olin-electric-motorsports/OEM_Preferred_Parts/3DModels/3P4T_rotary_switch/3P4T_rotary_switch.fcstd

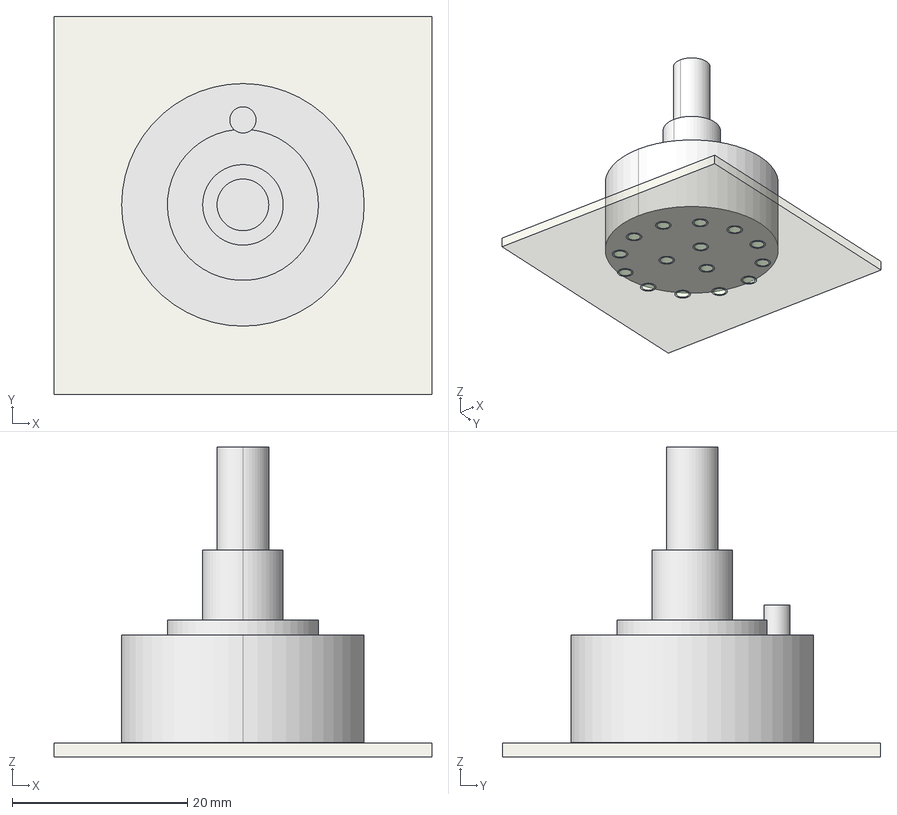
[picture p29: CAD file, 2018-02-22]
3DModels/3P4T_rotary_switch/3P4T_rotary_switch.fcstd
43.2 x 43.2 x 35.4 mm
FrontSilk
TopPads
BotPads
PTHs
Pcb
prog_switch
