olin-electric-motorsports/OEM_Preferred_Parts/3DModels/5029-smdTestPoint/5019--3DModel-STEP-56544.STEP

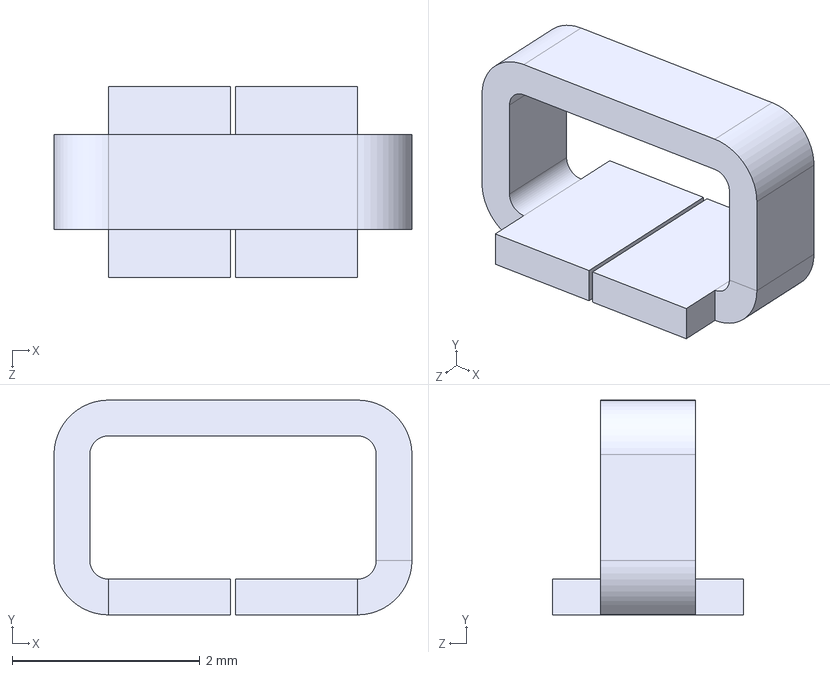
[picture p30: CAD file, 2020-11-04]
3DModels/5029-smdTestPoint/5019--3DModel-STEP-56544.STEP
3.81 x 2.29 x 2.03 mm
