olin-electric-motorsports/OEM_Preferred_Parts/3DModels/Ampseal-14/ampseal-14_OtherSide.stp

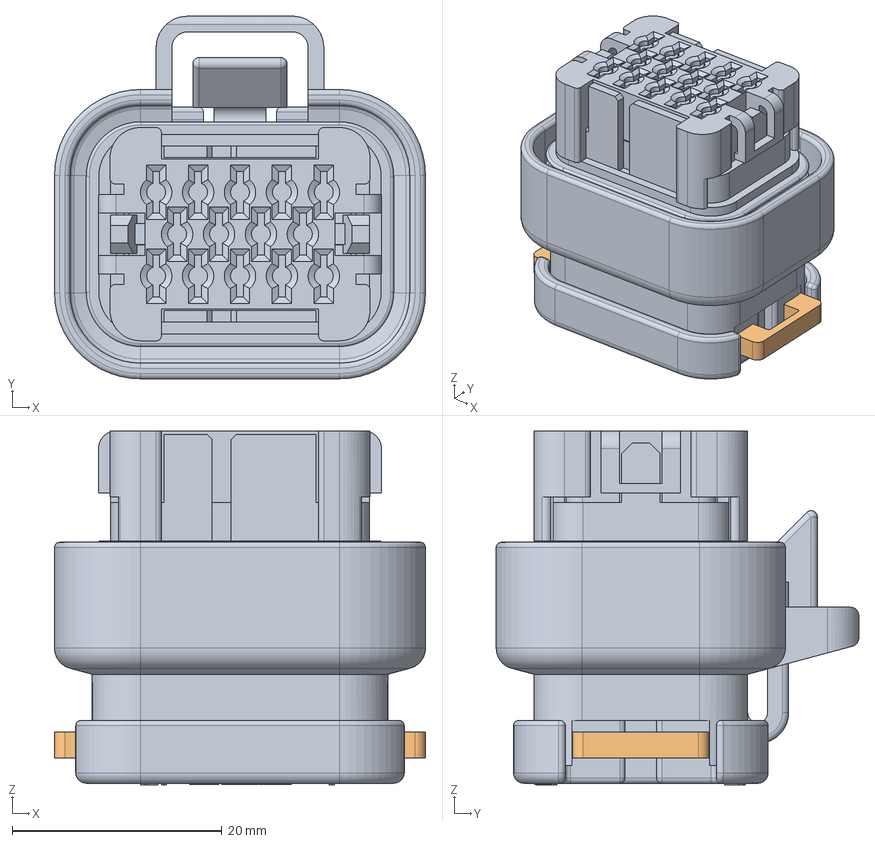
[picture p31: CAD file, 2020-02-05]
3DModels/Ampseal-14/ampseal-14_OtherSide.stp
35.4 x 34.6 x 33.8 mm
