olin-electric-motorsports/OEM_Preferred_Parts/3DModels/Ampseal-23/Ampseal_23.step

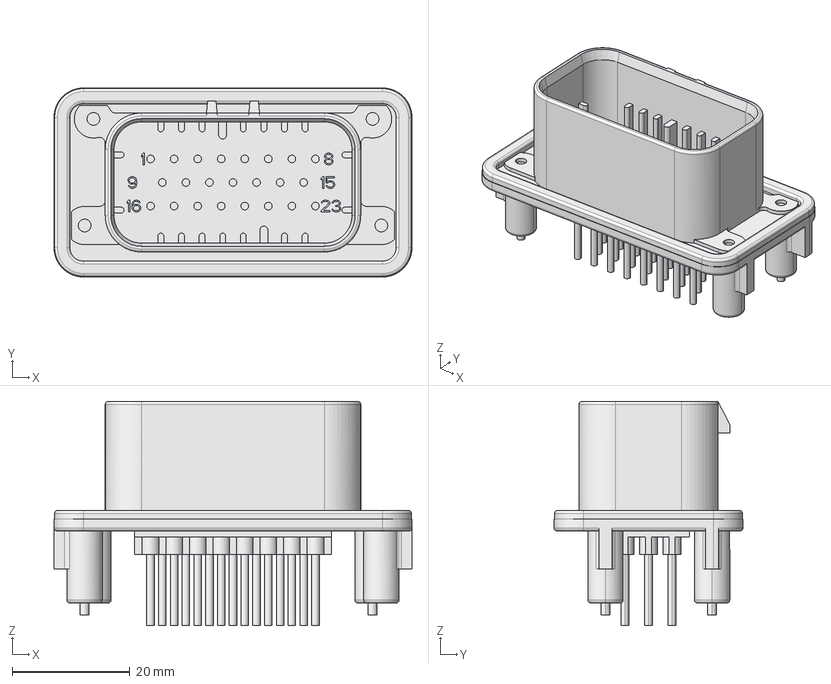
[picture p32: CAD file, 2018-02-08]
3DModels/Ampseal-23/Ampseal_23.step
60.8 x 32.1 x 38.1 mm
