olin-electric-motorsports/OEM_Preferred_Parts/3DModels/Ampseal-35/Ampseal35_OtherSide.stp

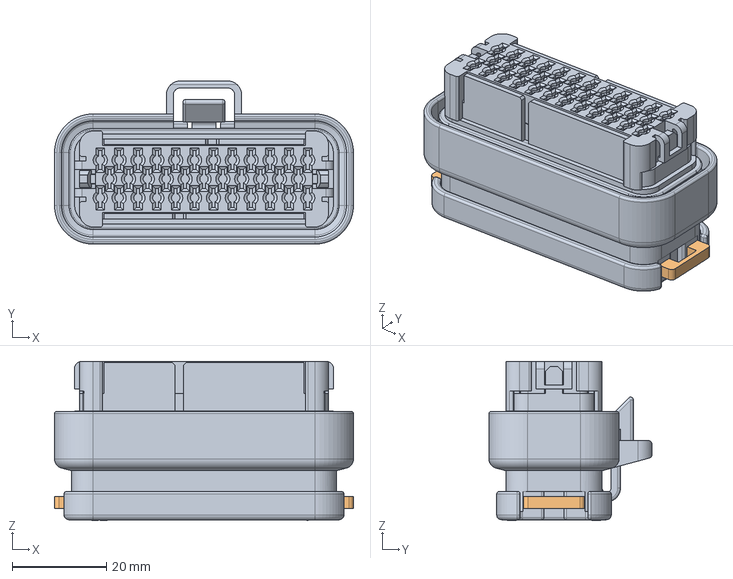
[picture p33: CAD file, 2020-01-15]
3DModels/Ampseal-35/Ampseal35_OtherSide.stp
63.4 x 34.6 x 33.8 mm
