olin-electric-motorsports/OEM_Preferred_Parts/3DModels/AP101_3k_resistor/AP101.fcstd

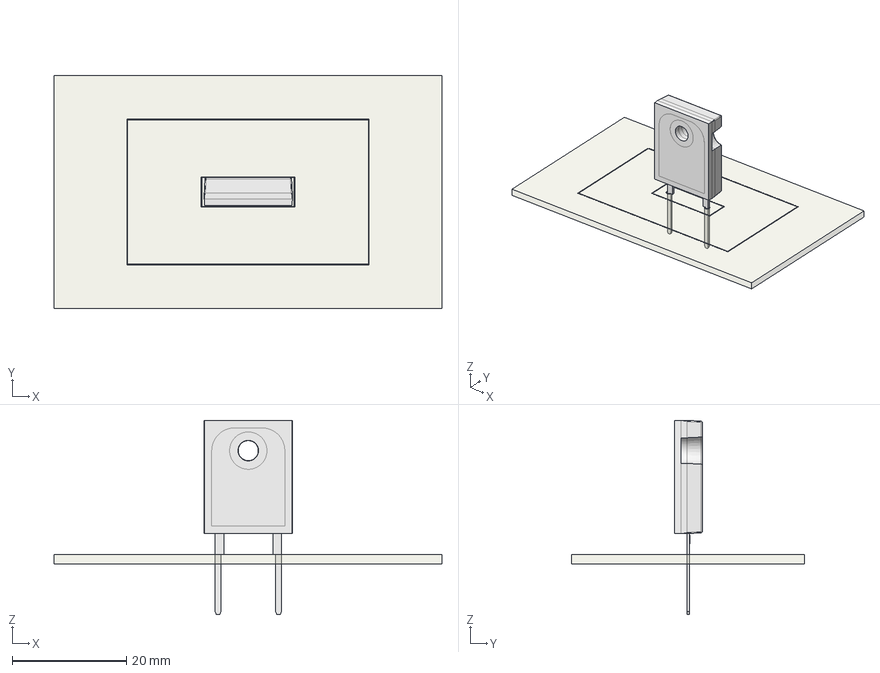
[picture p34: CAD file, 2017-12-29]
3DModels/AP101_3k_resistor/AP101.fcstd
68.0 x 40.8 x 34.0 mm
F_CrtYd
FrontSilk
TopPads
BotPads
PTHs
Pcb
TIP 144_sp
