olin-electric-motorsports/OEM_Preferred_Parts/3DModels/Atmega16m1/32A-M.step

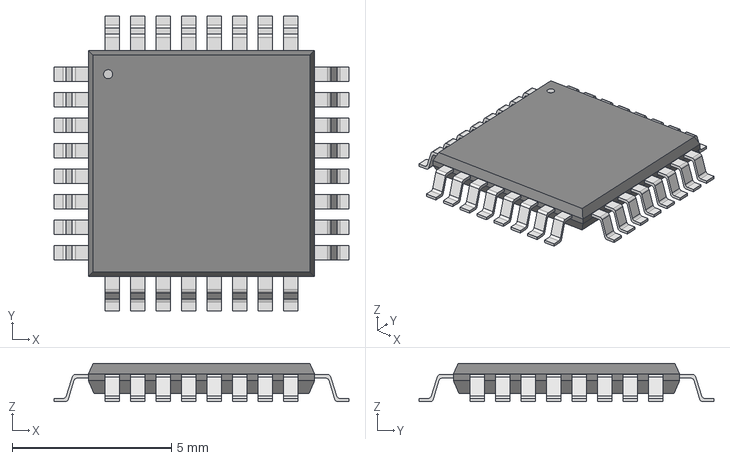
[picture p35: CAD file, 2018-01-06]
3DModels/Atmega16m1/32A-M.step
9.25 x 9.25 x 1.20 mm
