olin-electric-motorsports/OEM_Preferred_Parts/3DModels/BBS-126-G-A/BBS-126-G-A.stp

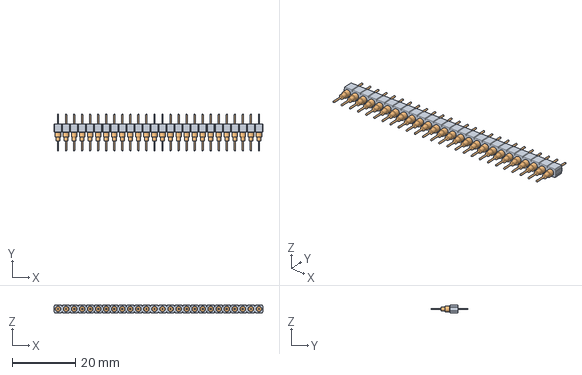
[picture p36: CAD file, 2019-04-12]
3DModels/BBS-126-G-A/BBS-126-G-A.stp
66.0 x 11.7 x 2.44 mm
_BBS-126-G-A_socket
_BBS-126-G-A_pins x 26
