olin-electric-motorsports/OEM_Preferred_Parts/3DModels/C_0805_OEM/C_0805.step

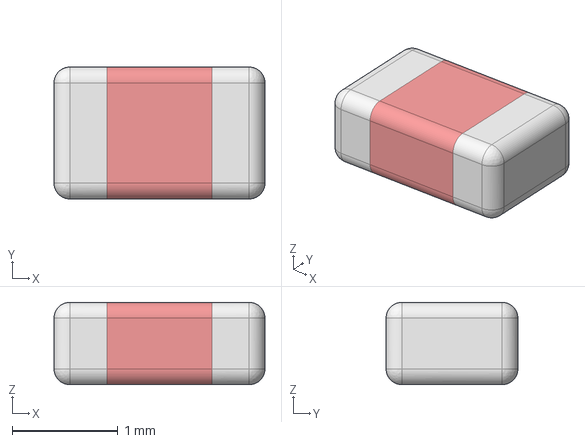
[picture p37: CAD file, 2017-12-01]
3DModels/C_0805_OEM/C_0805.step
2.00 x 1.25 x 0.78 mm
