olin-electric-motorsports/OEM_Preferred_Parts/3DModels/C_1206_OEM/C_1206_OEM.step

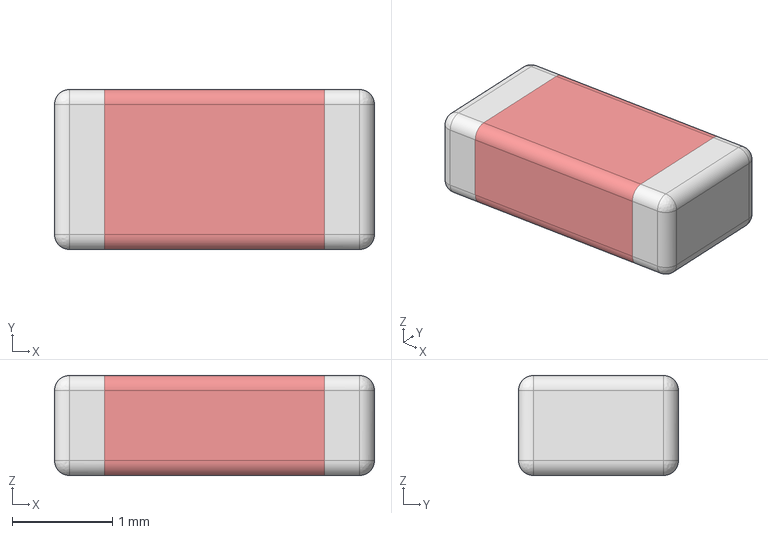
[picture p38: CAD file, 2017-12-29]
3DModels/C_1206_OEM/C_1206_OEM.step
3.20 x 1.60 x 1.00 mm
