olin-electric-motorsports/OEM_Preferred_Parts/3DModels/CAN Transceiver/CAN Transceiver.step

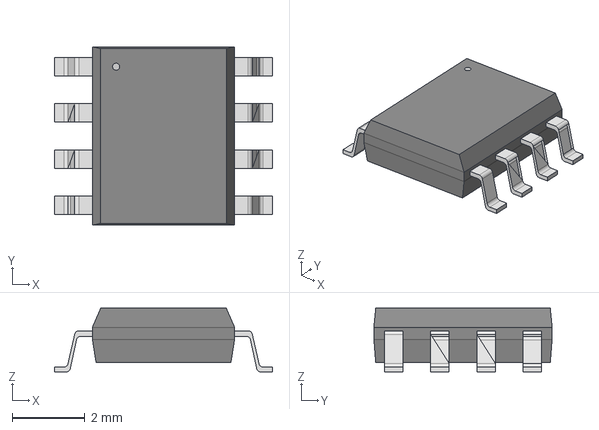
[picture p39: CAD file, 2018-01-06]
3DModels/CAN Transceiver/CAN Transceiver.step
5.99 x 4.90 x 1.75 mm
