olin-electric-motorsports/OEM_Preferred_Parts/3DModels/Crystal/Crystal_SMD_SeikoEpson_TSX3225-4Pin_3.2x2.5mm_HandSoldering.step

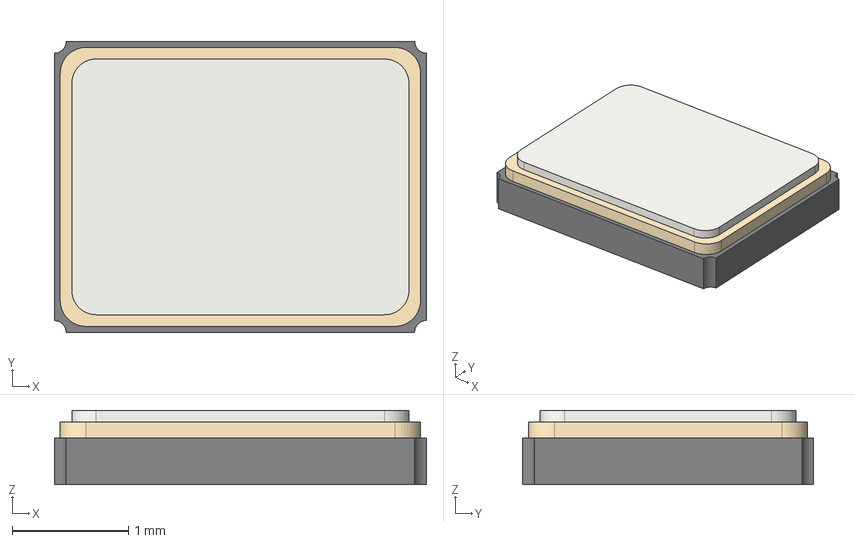
[picture p40: CAD file, 2020-02-01]
3DModels/Crystal/Crystal_SMD_SeikoEpson_TSX3225-4Pin_3.2x2.5mm_HandSoldering.step
3.20 x 2.50 x 0.64 mm
