olin-electric-motorsports/OEM_Preferred_Parts/3DModels/Cynergy_Relay/D_Series_Cynergy_Relays.STEP

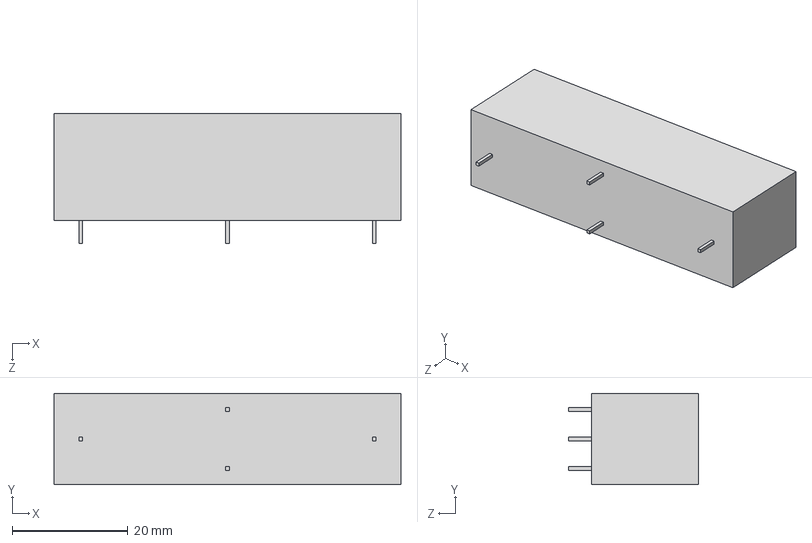
[picture p41: CAD file, 2019-03-15]
3DModels/Cynergy_Relay/D_Series_Cynergy_Relays.STEP
60.0 x 15.8 x 22.5 mm
