olin-electric-motorsports/OEM_Preferred_Parts/3DModels/D_Schottky_SOD123/DO-215AD002_sp.step

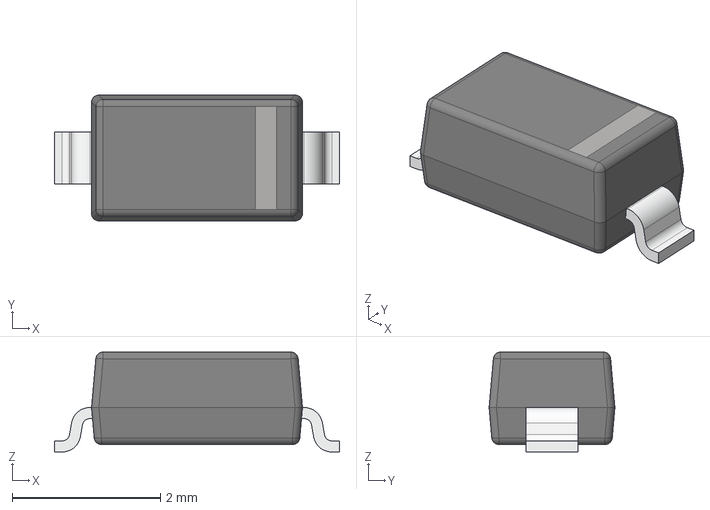
[picture p42: CAD file, 2017-12-29]
3DModels/D_Schottky_SOD123/DO-215AD002_sp.step
3.85 x 1.70 x 1.35 mm
