olin-electric-motorsports/OEM_Preferred_Parts/3DModels/DO_214AA_OEM/DO_214AA.step

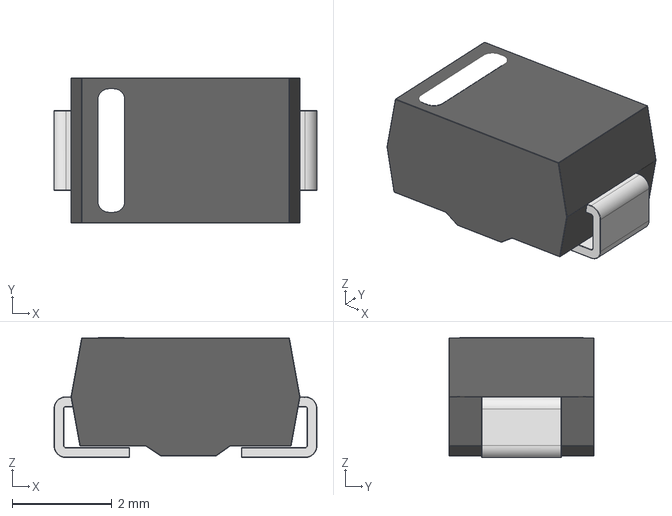
[picture p43: CAD file, 2017-12-01]
3DModels/DO_214AA_OEM/DO_214AA.step
5.28 x 2.92 x 2.41 mm
