olin-electric-motorsports/OEM_Preferred_Parts/3DModels/DTO25/DTO025.step

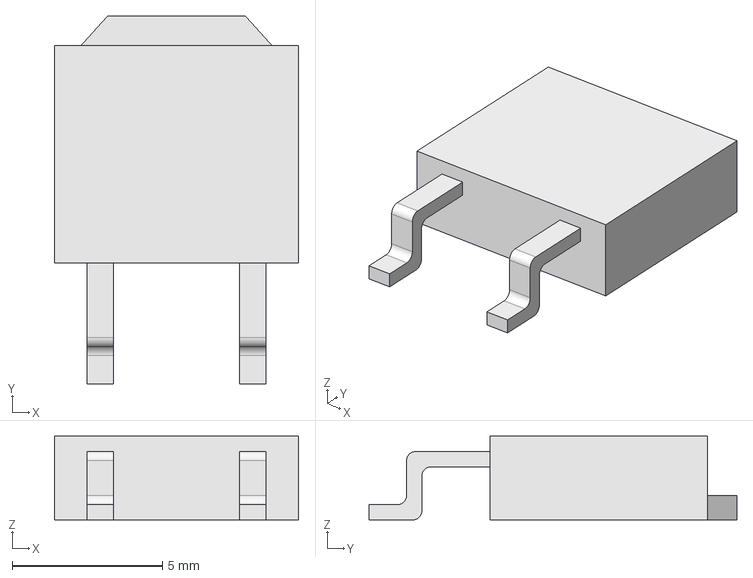
[picture p44: CAD file, 2018-01-06]
3DModels/DTO25/DTO025.step
8.13 x 12.2 x 2.79 mm
