olin-electric-motorsports/OEM_Preferred_Parts/3DModels/Fuse_1210_OEM/Fuse1210.step

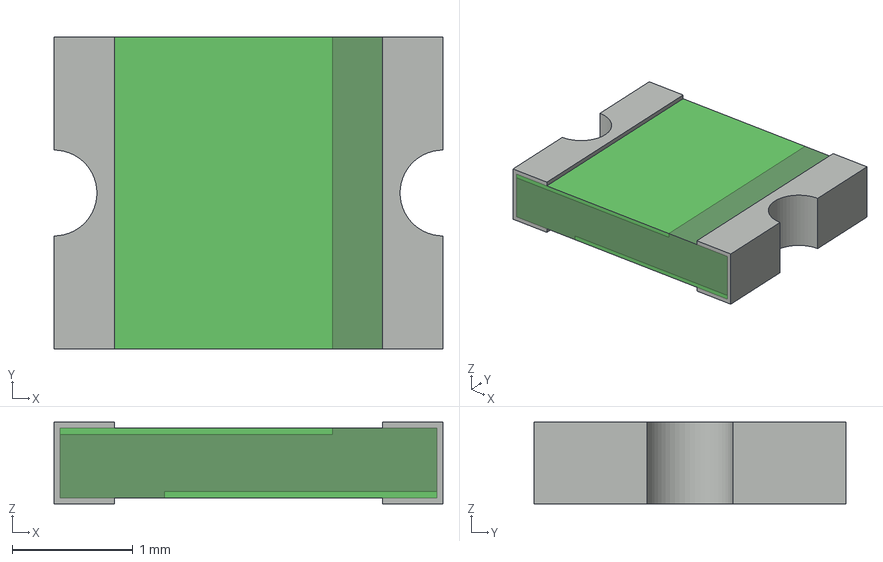
[picture p45: CAD file, 2017-12-01]
3DModels/Fuse_1210_OEM/Fuse1210.step
3.21 x 2.58 x 0.675 mm
