olin-electric-motorsports/OEM_Preferred_Parts/3DModels/Fuse_807/Fuse_807.fcstd

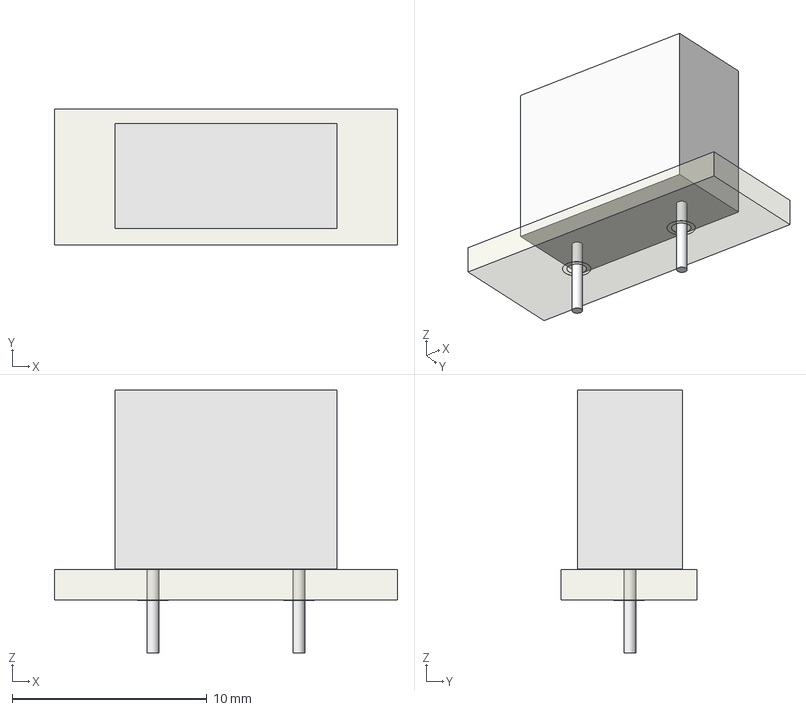
[picture p46: CAD file, 2017-12-29]
3DModels/Fuse_807/Fuse_807.fcstd
17.6 x 6.98 x 13.5 mm
F_CrtYd
FrontSilk
TopPads
BotPads
PTHs
Pcb
