olin-electric-motorsports/OEM_Preferred_Parts/3DModels/fuse_block/fuse_block.step

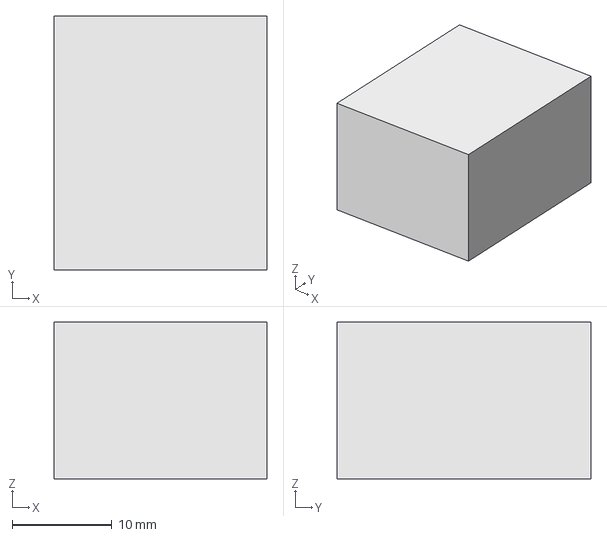
[picture p47: CAD file, 2018-02-22]
3DModels/fuse_block/fuse_block.step
21.3 x 25.4 x 15.7 mm
