olin-electric-motorsports/OEM_Preferred_Parts/3DModels/fuse_block_3557_2/Fuse_3557-2.step

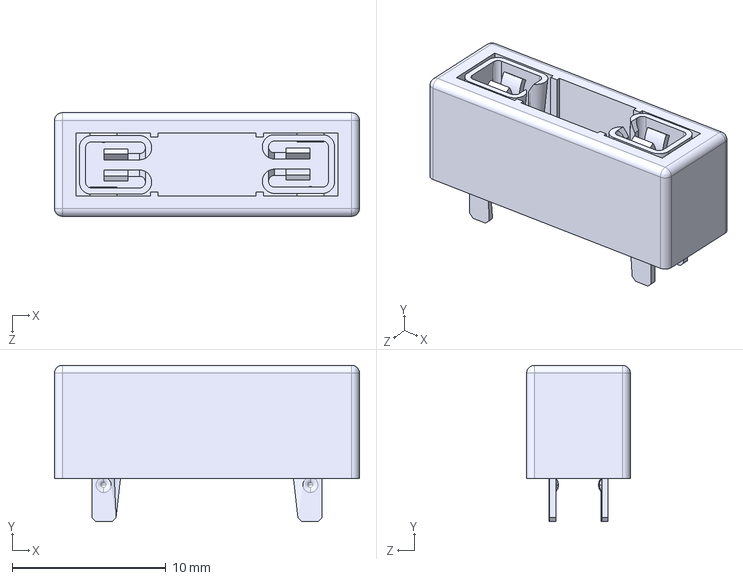
[picture p48: CAD file, 2019-03-01]
3DModels/fuse_block_3557_2/Fuse_3557-2.step
19.8 x 10.2 x 6.73 mm
