olin-electric-motorsports/OEM_Preferred_Parts/3DModels/G5Q_OEM/G5Q.step

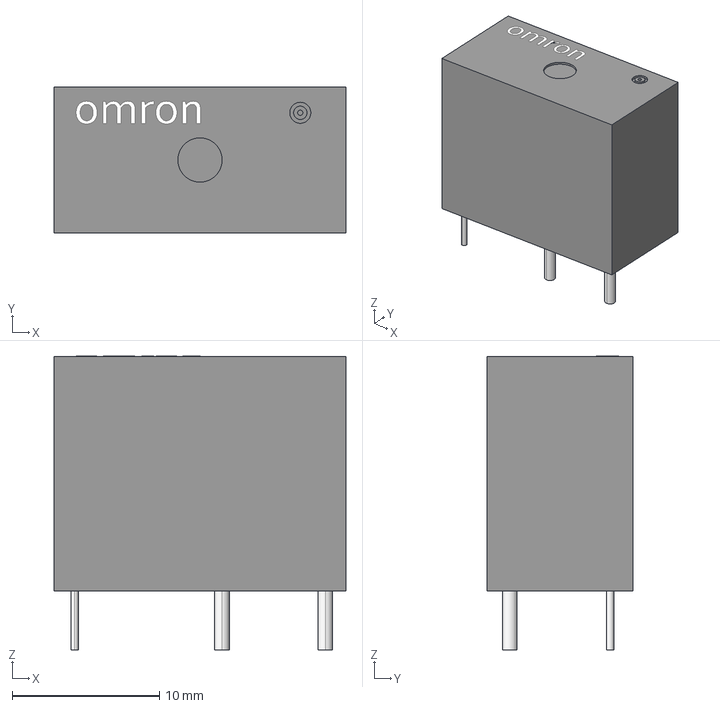
[picture p49: CAD file, 2017-12-01]
3DModels/G5Q_OEM/G5Q.step
19.8 x 9.90 x 19.9 mm
