olin-electric-motorsports/OEM_Preferred_Parts/3DModels/Header_Pin_2x3/Header_Pin_2x3.fcstd

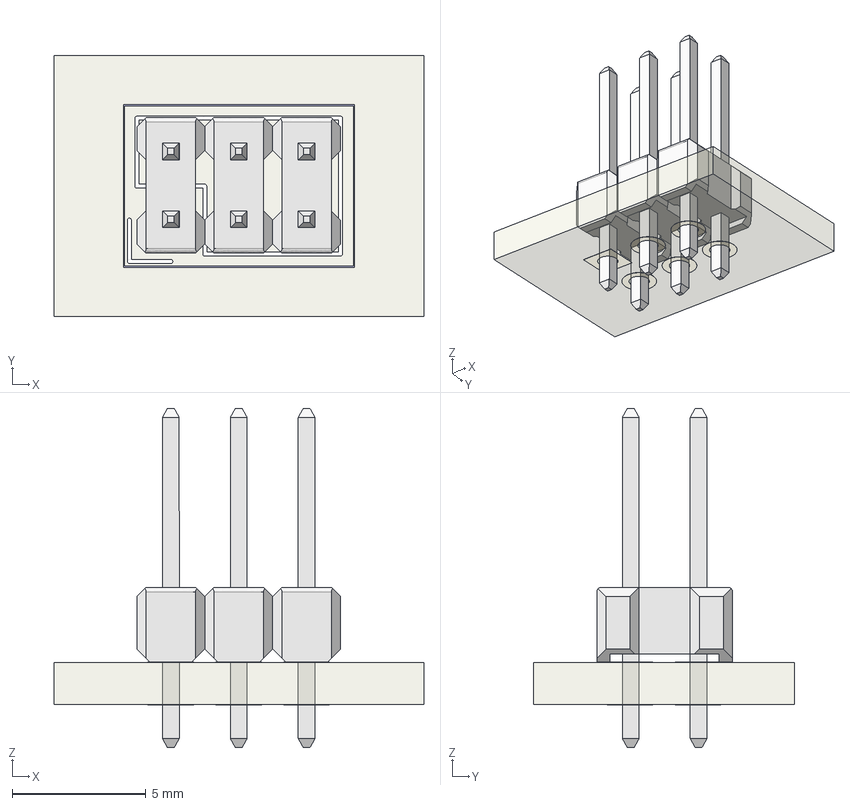
[picture p50: CAD file, 2018-01-06]
3DModels/Header_Pin_2x3/Header_Pin_2x3.fcstd
13.8 x 9.76 x 12.7 mm
FCrtYd
FrontSilk
TopPads
BotPads
PTHs
Pcb
Header_Straight_2x3
