olin-electric-motorsports/OEM_Preferred_Parts/3DModels/LED_0805/LED_0805.fcstd

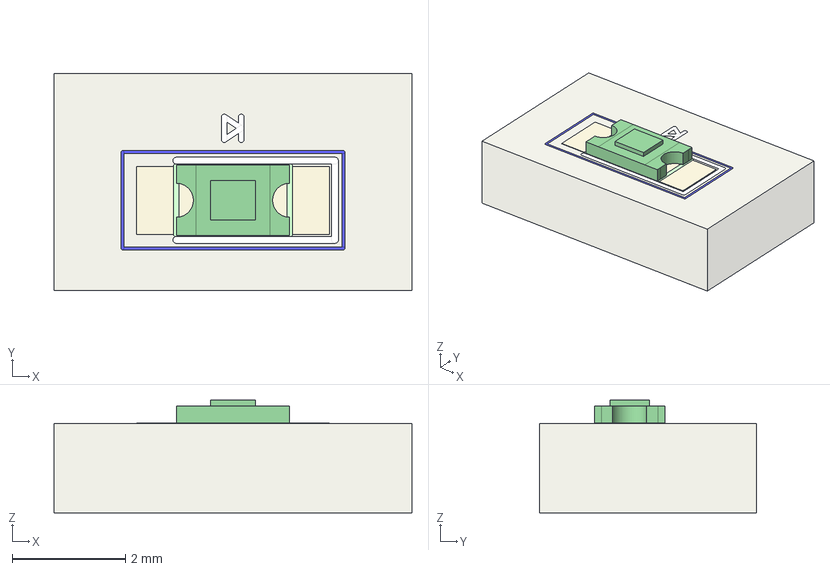
[picture p51: CAD file, 2017-12-01]
3DModels/LED_0805/LED_0805.fcstd
6.32 x 3.83 x 1.99 mm
FFab
FrontSilk
TopPads
Pcb
FCrtYd
LED 0805 Base GREEN001_sp
