olin-electric-motorsports/OEM_Preferred_Parts/3DModels/LTC1380/LTC1380.STEP

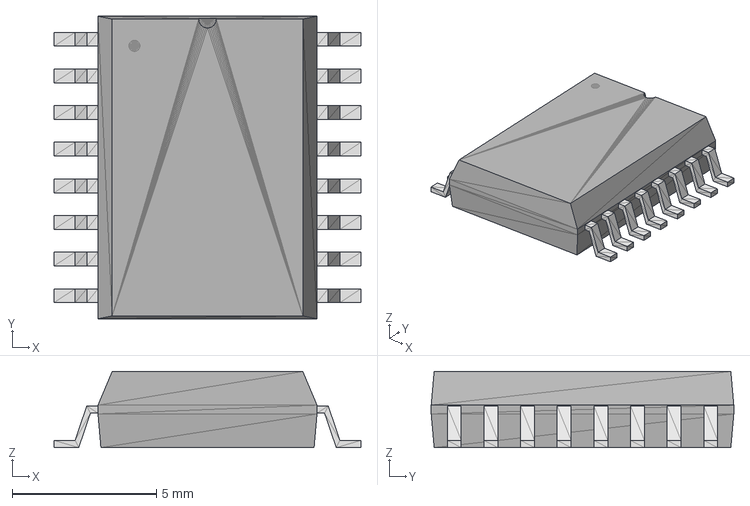
[picture p52: CAD file, 2019-01-19]
3DModels/LTC1380/LTC1380.STEP
10.6 x 10.5 x 2.64 mm
