olin-electric-motorsports/OEM_Preferred_Parts/3DModels/LTC6804/LTC6804-G.step

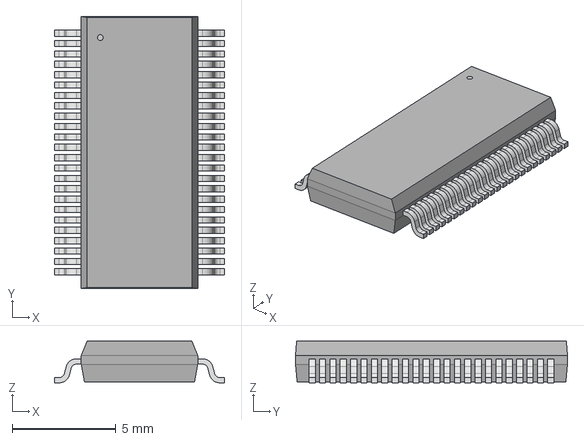
[picture p53: CAD file, 2019-11-15]
3DModels/LTC6804/LTC6804-G.step
8.20 x 13.1 x 2.01 mm
