olin-electric-motorsports/OEM_Preferred_Parts/3DModels/LTC6811-1/LTC6811-1.stp

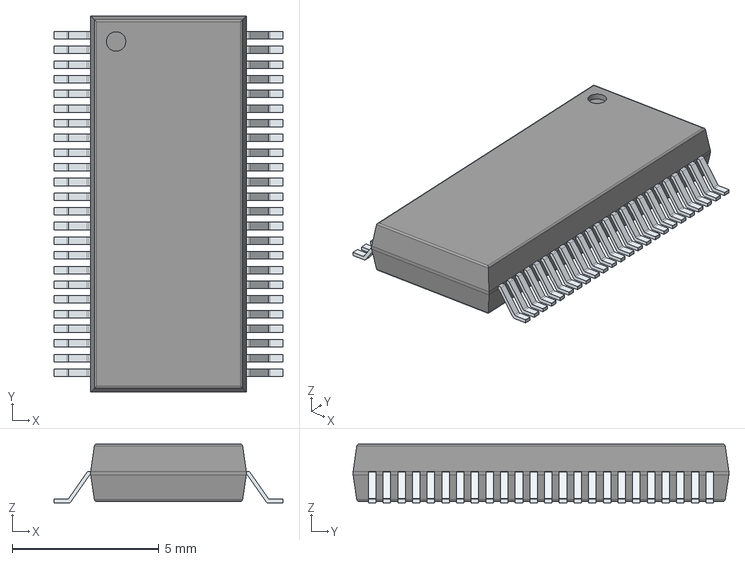
[picture p54: CAD file, 2019-01-19]
3DModels/LTC6811-1/LTC6811-1.stp
7.80 x 12.8 x 2.00 mm
PinsArrayLR
