olin-electric-motorsports/OEM_Preferred_Parts/3DModels/MicroFit-10-RA/MicroFit-10-RA.stp

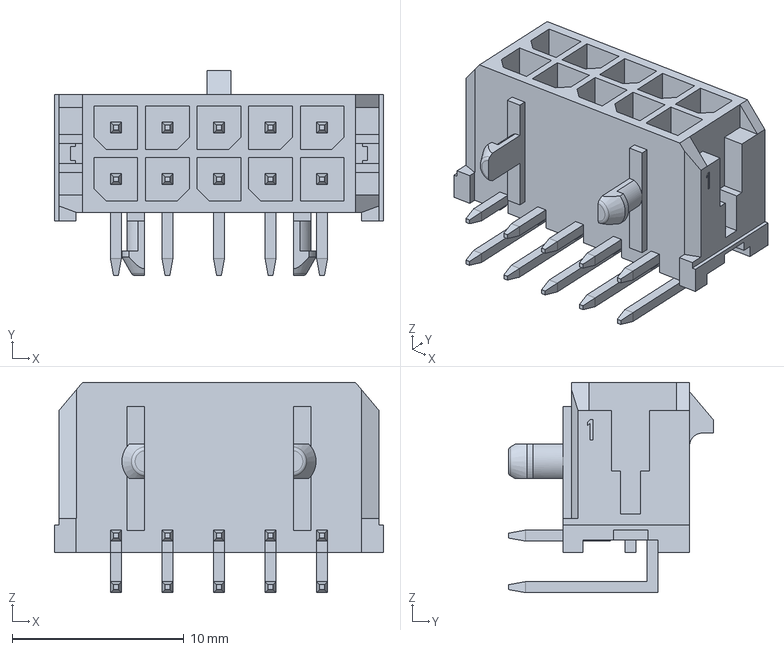
[picture p55: CAD file, 2019-03-15]
3DModels/MicroFit-10-RA/MicroFit-10-RA.stp
19.1 x 11.9 x 12.2 mm
