olin-electric-motorsports/OEM_Preferred_Parts/3DModels/Microfit-2-VT/Microfit_2_VT.stp

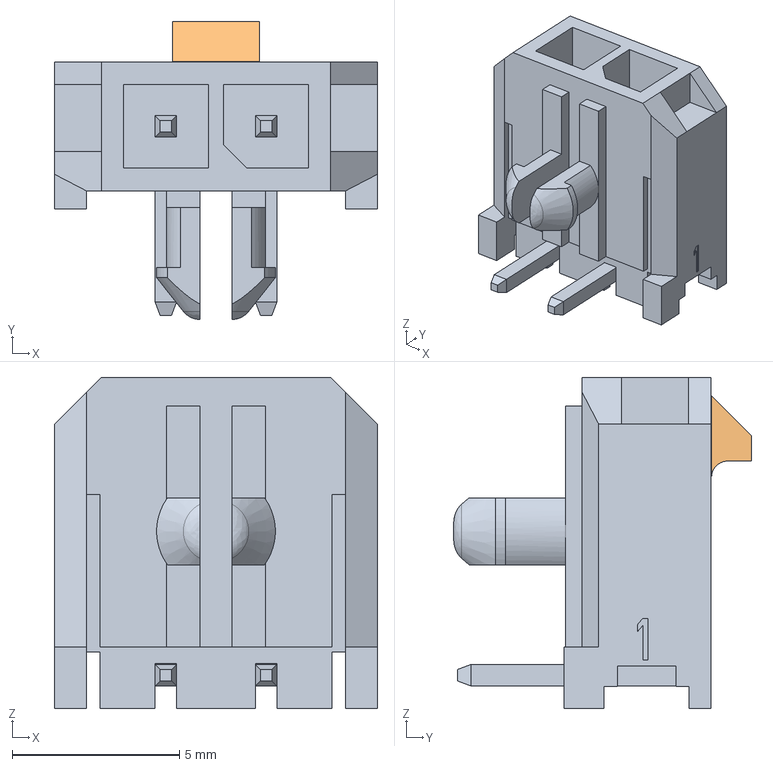
[picture p56: CAD file, 2019-04-12]
3DModels/Microfit-2-VT/Microfit_2_VT.stp
9.65 x 8.91 x 9.90 mm
