olin-electric-motorsports/OEM_Preferred_Parts/3DModels/MicroFit-6-RA/MF_RA_06.stp

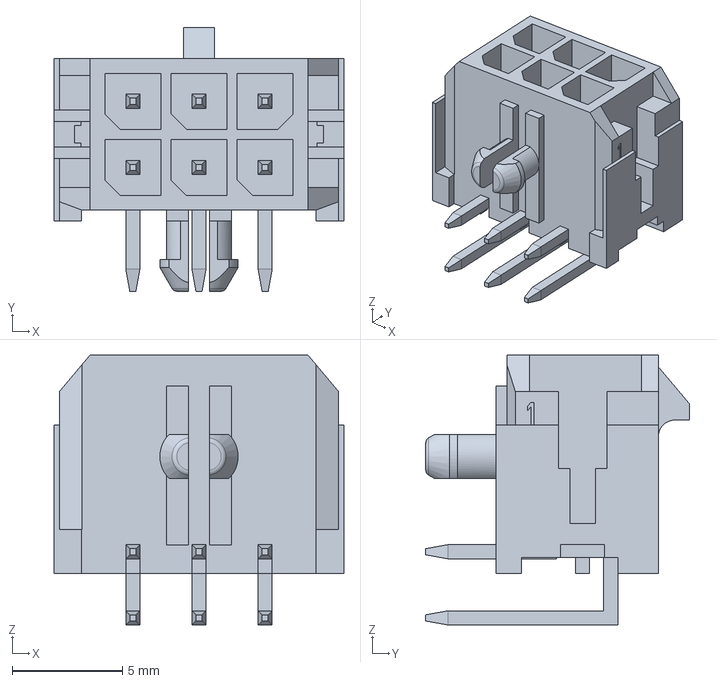
[picture p57: CAD file, 2019-03-15]
3DModels/MicroFit-6-RA/MF_RA_06.stp
13.2 x 11.9 x 12.2 mm
