olin-electric-motorsports/OEM_Preferred_Parts/3DModels/MicroFit-8-RA/MF-08-RA.stp

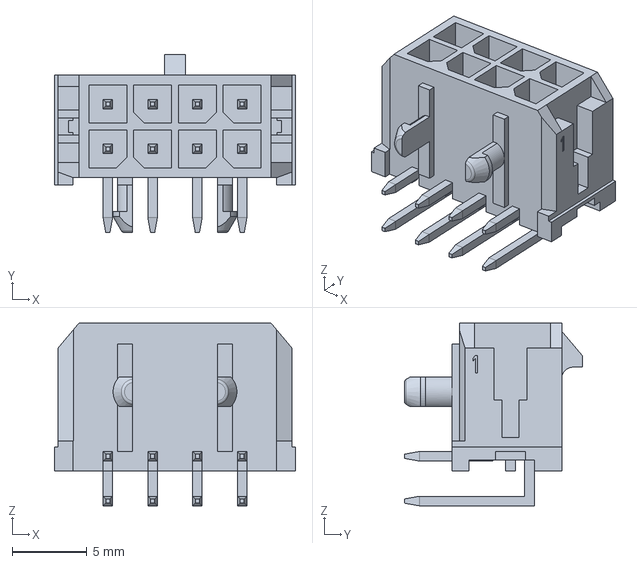
[picture p58: CAD file, 2019-03-15]
3DModels/MicroFit-8-RA/MF-08-RA.stp
16.1 x 11.9 x 12.2 mm
