olin-electric-motorsports/OEM_Preferred_Parts/3DModels/Microfit3_Header_02x06_Angled_OEM/Microfit3_Header_02x06_Angled_OEM.step

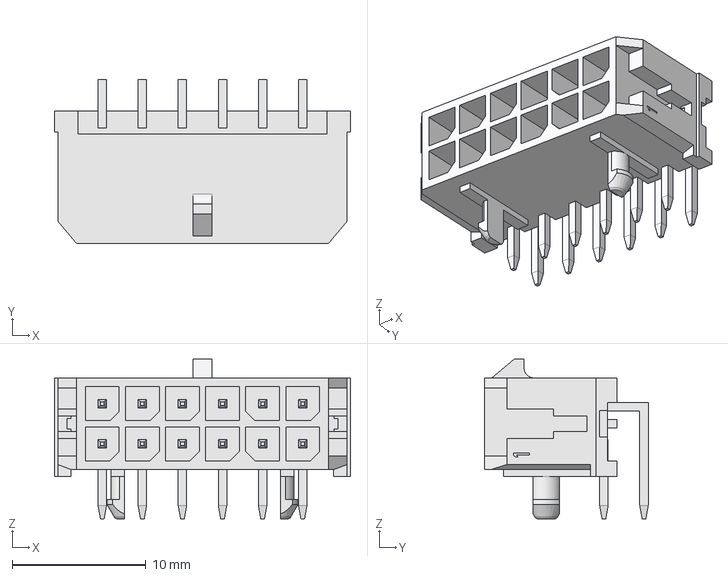
[picture p59: CAD file, 2018-01-06]
3DModels/Microfit3_Header_02x06_Angled_OEM/Microfit3_Header_02x06_Angled_OEM.step
22.1 x 12.2 x 11.9 mm
