olin-electric-motorsports/OEM_Preferred_Parts/3DModels/Microfit_RA_SMD/Microfit_RA_SMD.stp

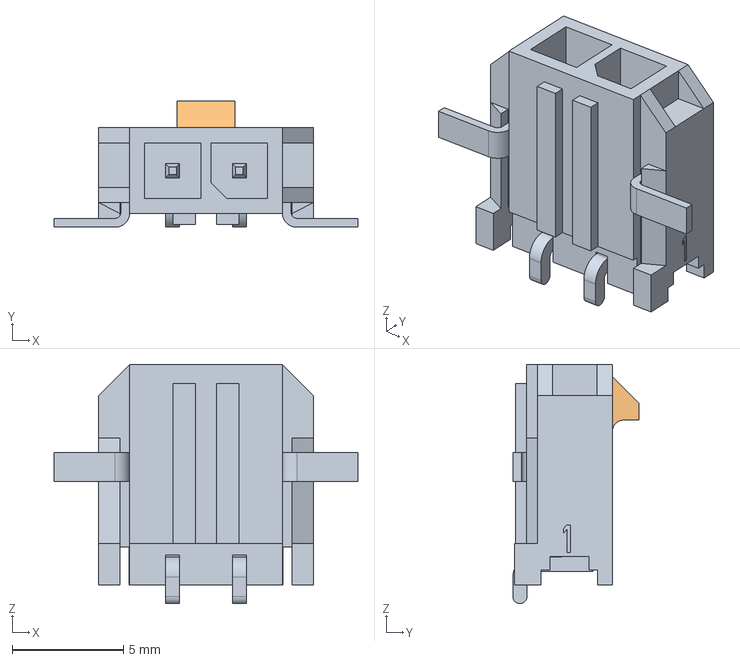
[picture p60: CAD file, 2019-11-15]
3DModels/Microfit_RA_SMD/Microfit_RA_SMD.stp
13.7 x 5.67 x 10.7 mm
