olin-electric-motorsports/OEM_Preferred_Parts/3DModels/MicroFit_V_2/MicroFit_V_2.stp

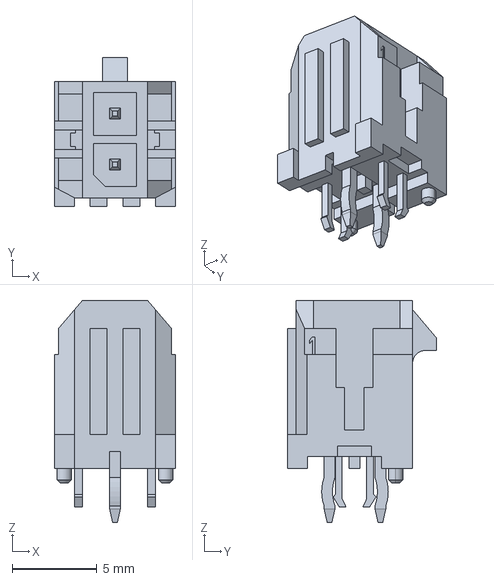
[picture p61: CAD file, 2019-04-12]
3DModels/MicroFit_V_2/MicroFit_V_2.stp
7.15 x 8.77 x 13.1 mm
