olin-electric-motorsports/OEM_Preferred_Parts/3DModels/MicroFit_VT_4/MicroFit_VT_4.stp

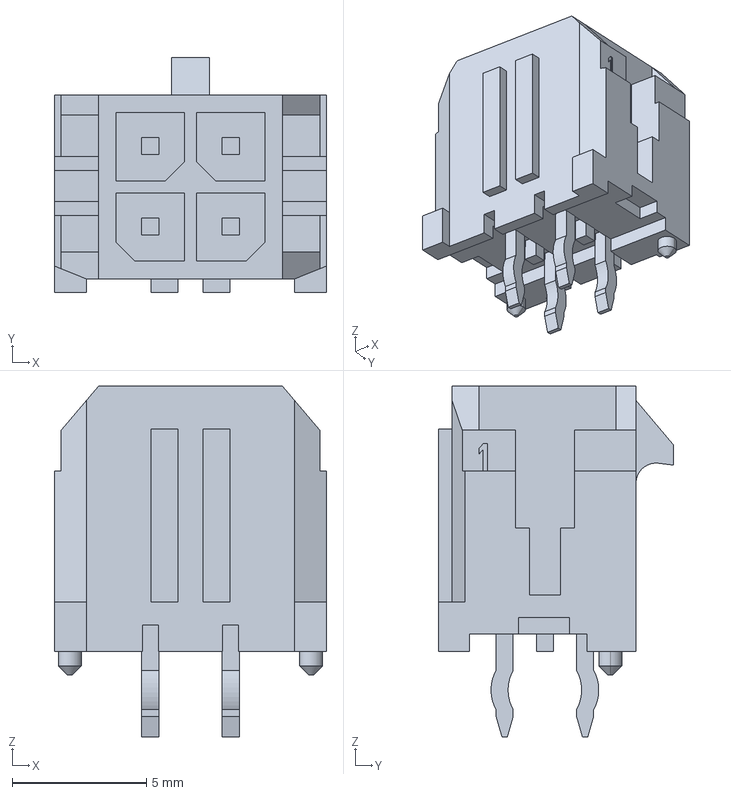
[picture p62: CAD file, 2020-01-15]
3DModels/MicroFit_VT_4/MicroFit_VT_4.stp
10.2 x 8.77 x 13.1 mm
