olin-electric-motorsports/OEM_Preferred_Parts/3DModels/MicroFit_VT_6/MicroFit_VT_6.stp

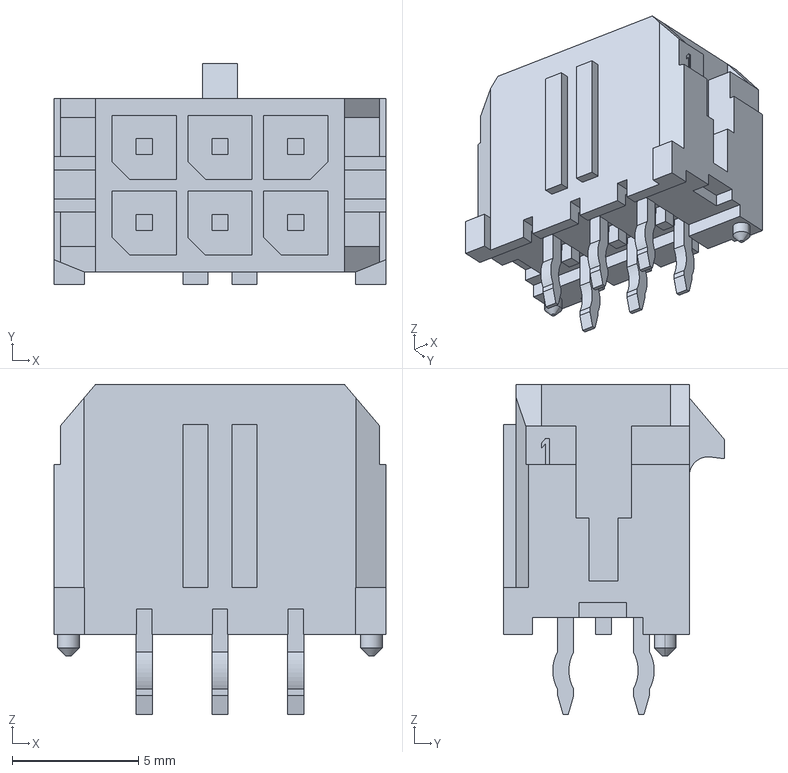
[picture p63: CAD file, 2020-01-15]
3DModels/MicroFit_VT_6/MicroFit_VT_6.stp
13.2 x 8.77 x 13.1 mm
