olin-electric-motorsports/OEM_Preferred_Parts/3DModels/micromatch_female_ra_12/C-1-215464-2.step

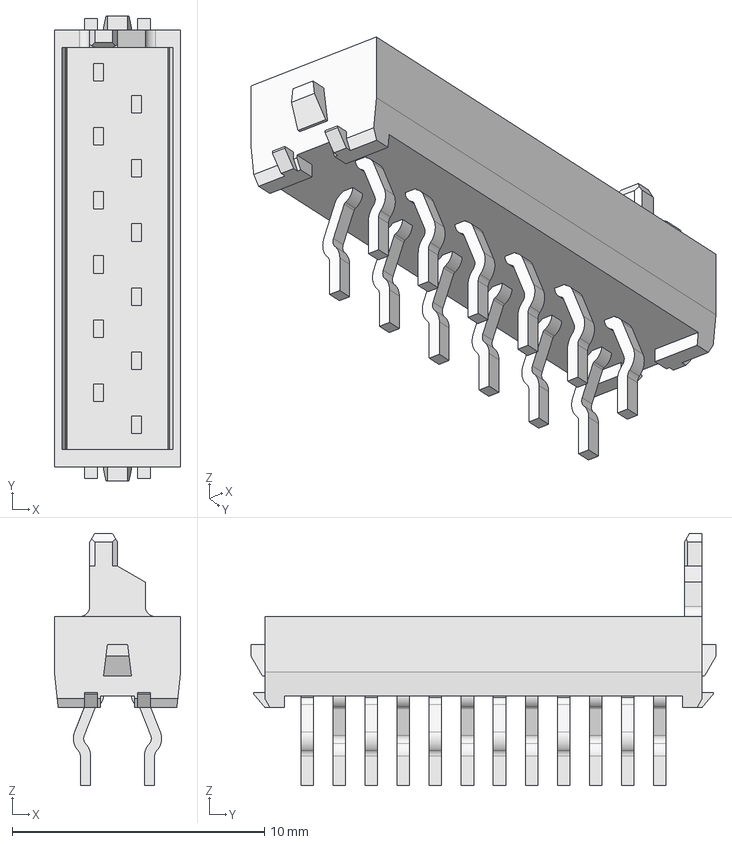
[picture p64: CAD file, 2018-02-22]
3DModels/micromatch_female_ra_12/C-1-215464-2.step
5.00 x 18.4 x 10.0 mm
