olin-electric-motorsports/OEM_Preferred_Parts/3DModels/Micromatch_Female_RA_16/c-8-100400-6-j-3d.stp

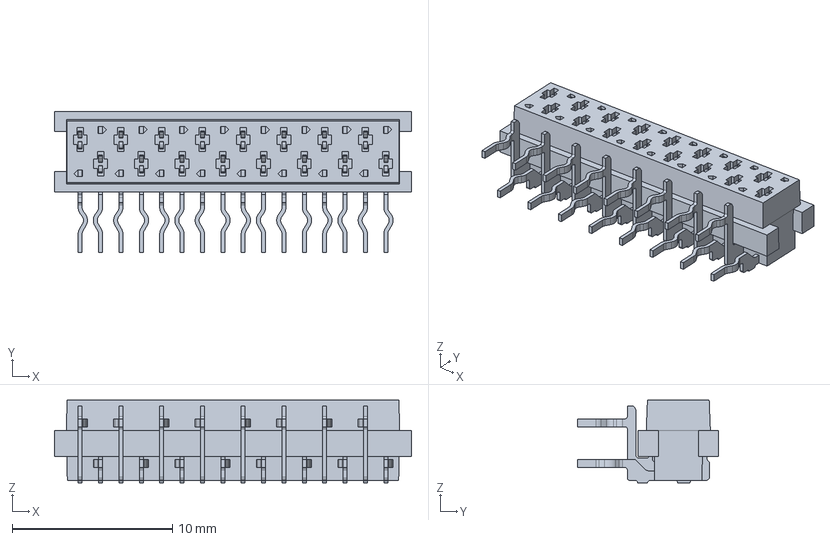
[picture p65: CAD file, 2018-01-06]
3DModels/Micromatch_Female_RA_16/c-8-100400-6-j-3d.stp
22.2 x 8.78 x 5.15 mm
