olin-electric-motorsports/OEM_Preferred_Parts/3DModels/micromatch_female_ra_18/micromatch_female_ra_18.fcstd

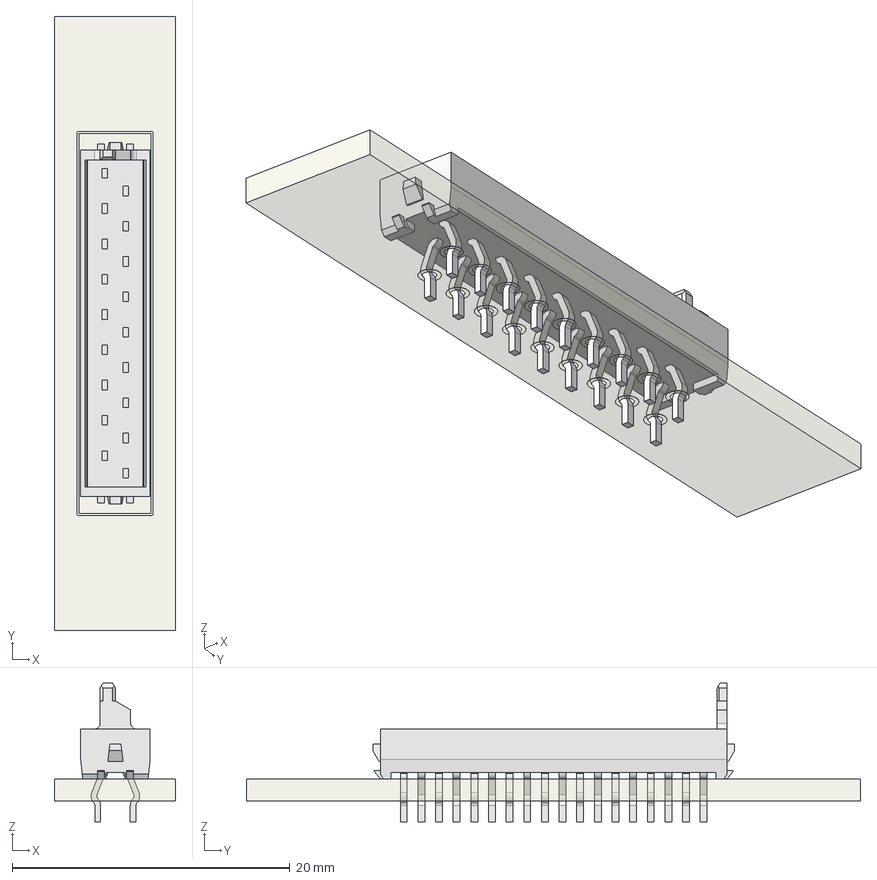
[picture p66: CAD file, 2018-02-22]
3DModels/micromatch_female_ra_18/micromatch_female_ra_18.fcstd
8.72 x 44.2 x 10.0 mm
FrontSilk
TopPads
BotPads
PTHs
Pcb
C-1-215464-8
