olin-electric-motorsports/OEM_Preferred_Parts/3DModels/micromatch_female_ra_20/C-2-215464-0.step

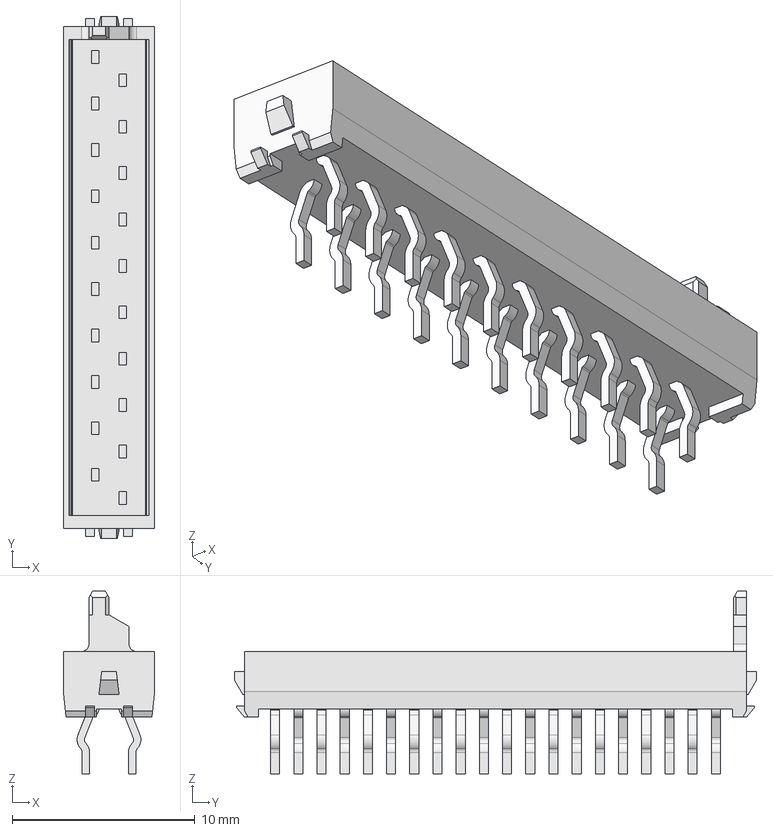
[picture p67: CAD file, 2018-02-22]
3DModels/micromatch_female_ra_20/C-2-215464-0.step
5.00 x 28.6 x 10.0 mm
