olin-electric-motorsports/OEM_Preferred_Parts/3DModels/micromatch_female_ra_6/C-215464-6.step

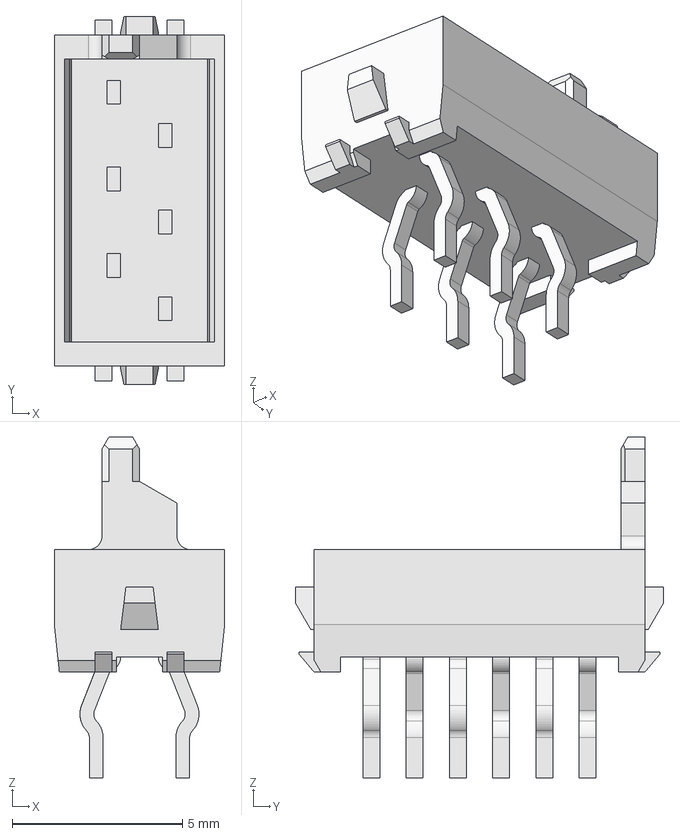
[picture p68: CAD file, 2018-02-22]
3DModels/micromatch_female_ra_6/C-215464-6.step
5.00 x 10.8 x 10.0 mm
