olin-electric-motorsports/OEM_Preferred_Parts/3DModels/Micromatch_Female_RA_8/micromatch_female_ra_8.step

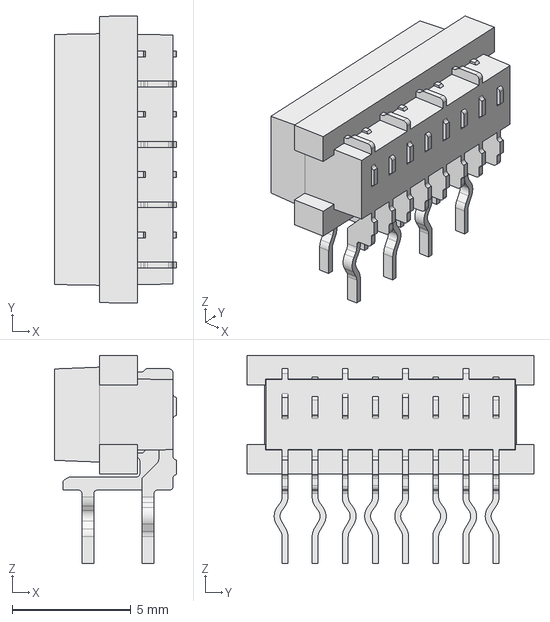
[picture p69: CAD file, 2017-12-04]
3DModels/Micromatch_Female_RA_8/micromatch_female_ra_8.step
5.15 x 12.1 x 8.78 mm
