olin-electric-motorsports/OEM_Preferred_Parts/3DModels/micromatch_female_vert_16/c-1-338068-6-f-3d.stp

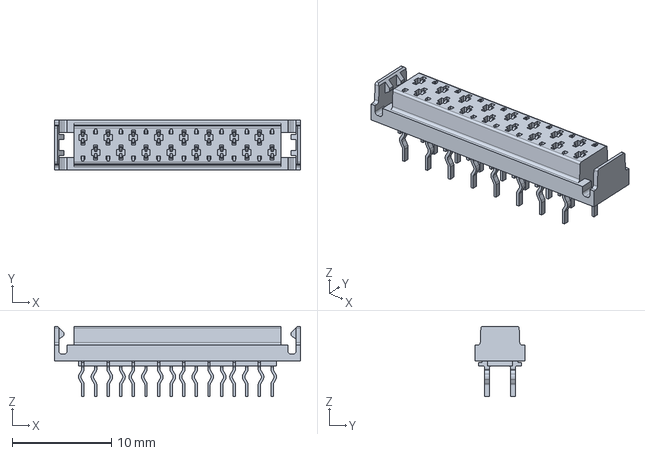
[picture p70: CAD file, 2019-03-18]
3DModels/micromatch_female_vert_16/c-1-338068-6-f-3d.stp
24.8 x 5.00 x 7.10 mm
