olin-electric-motorsports/OEM_Preferred_Parts/3DModels/MicroMatch_Female_VT_6/MM_F_VT_6.stp

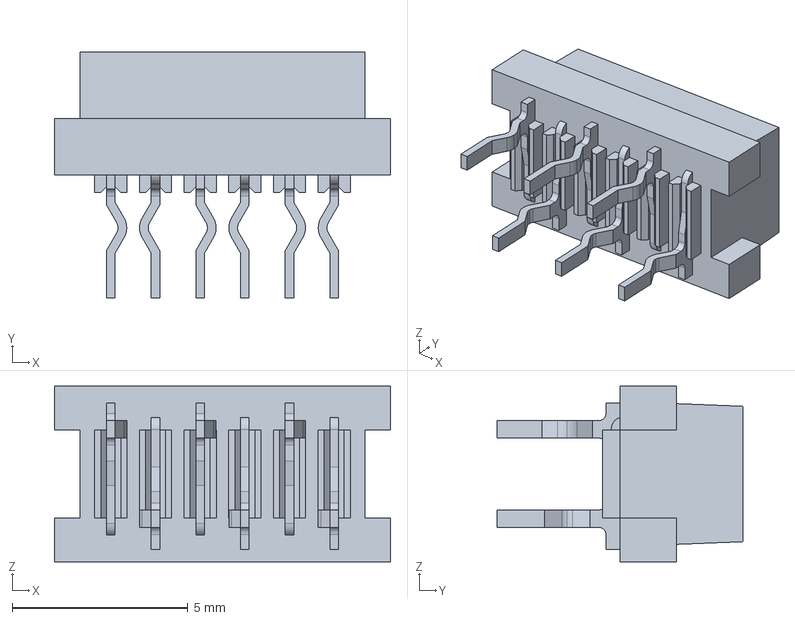
[picture p71: CAD file, 2019-03-01]
3DModels/MicroMatch_Female_VT_6/MM_F_VT_6.stp
9.55 x 7.00 x 5.00 mm
