olin-electric-motorsports/OEM_Preferred_Parts/3DModels/micromatch_vert10/micromatch_vert10.fcstd

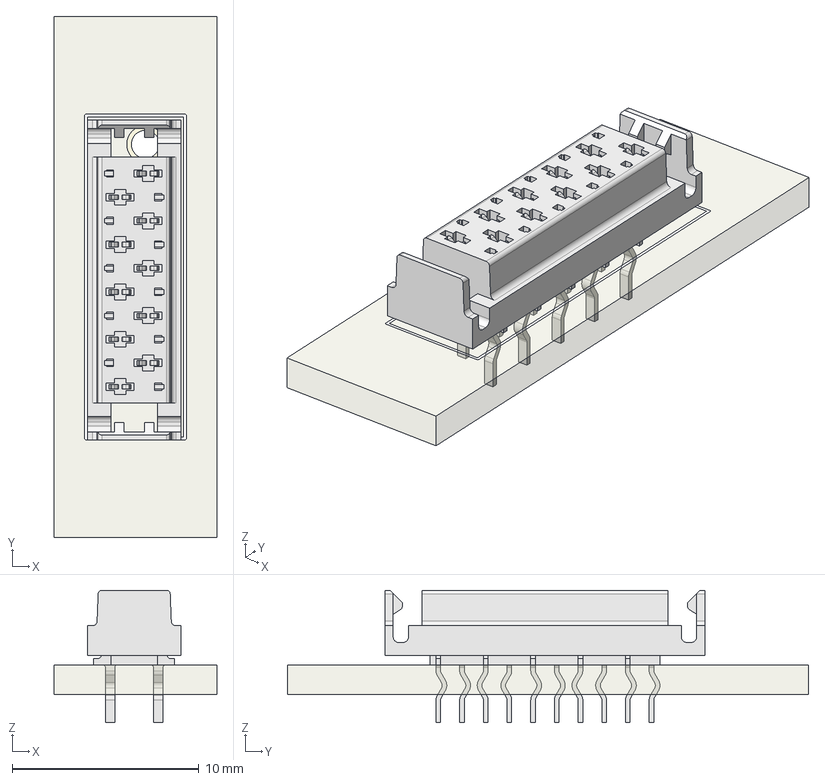
[picture p72: CAD file, 2018-02-08]
3DModels/micromatch_vert10/micromatch_vert10.fcstd
8.72 x 27.9 x 7.10 mm
FrontSilk
TopPads
BotPads
PTHs
Pcb
micromatch_10_vert
