olin-electric-motorsports/OEM_Preferred_Parts/3DModels/micromatch_vert4/micromatch_vert4.step

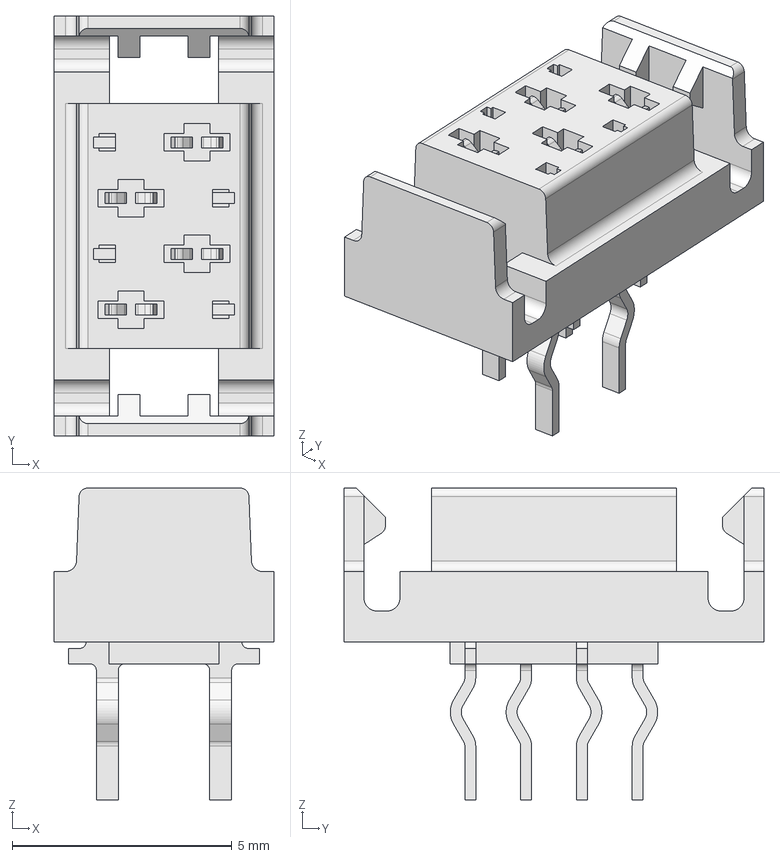
[picture p73: CAD file, 2018-02-08]
3DModels/micromatch_vert4/micromatch_vert4.step
5.00 x 9.55 x 7.10 mm
