olin-electric-motorsports/OEM_Preferred_Parts/3DModels/micromath-female-vert-12/MM-12-V-Female.stp

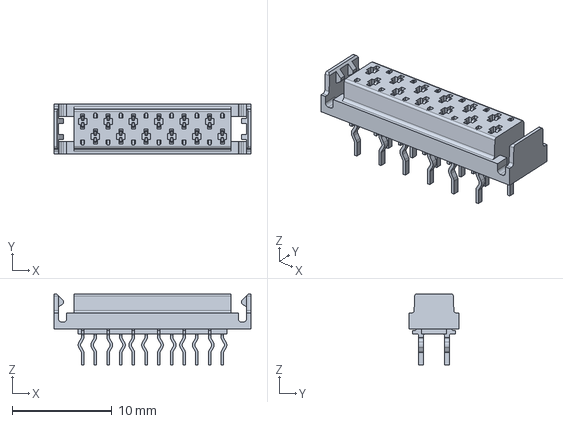
[picture p74: CAD file, 2019-11-15]
3DModels/micromath-female-vert-12/MM-12-V-Female.stp
19.7 x 5.00 x 7.10 mm
