olin-electric-motorsports/OEM_Preferred_Parts/3DModels/Molex_Microfit3_Header_02x10_Angled_OEM_fp/Molex_Microfit3_Header_02x10_Angled_OEM_fp.step

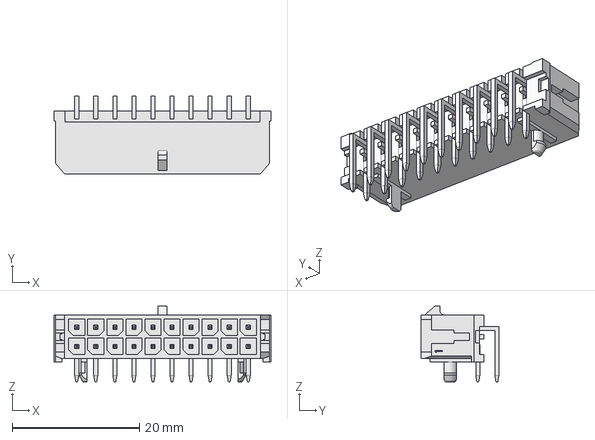
[picture p75: CAD file, 2018-01-06]
3DModels/Molex_Microfit3_Header_02x10_Angled_OEM_fp/Molex_Microfit3_Header_02x10_Angled_OEM_fp.step
34.1 x 12.2 x 12.0 mm
