olin-electric-motorsports/OEM_Preferred_Parts/3DModels/Molex_NanoFit_1x02x2_50mm_Angled_OEM/Molex_NanoFit_1x02x2_50mm_Angled_OEM001.step

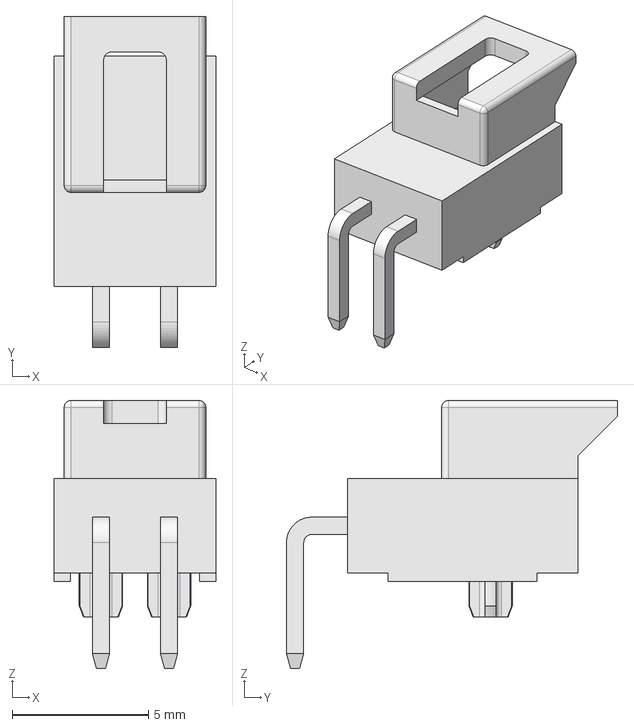
[picture p76: CAD file, 2018-01-06]
3DModels/Molex_NanoFit_1x02x2_50mm_Angled_OEM/Molex_NanoFit_1x02x2_50mm_Angled_OEM001.step
5.94 x 12.2 x 9.84 mm
