olin-electric-motorsports/OEM_Preferred_Parts/3DModels/mx150l_2/mx150l_2.fcstd

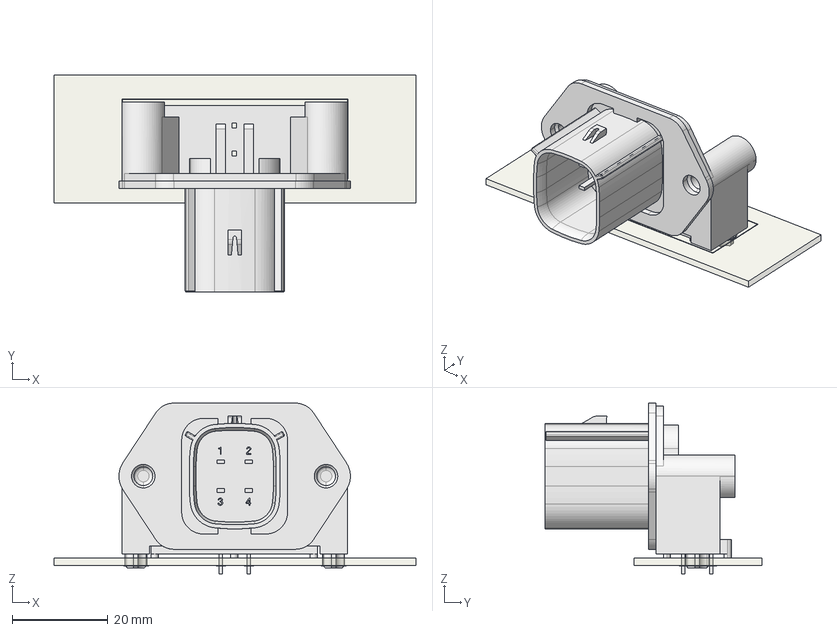
[picture p77: CAD file, 2018-02-10]
3DModels/mx150l_2/mx150l_2.fcstd
75.5 x 45.2 x 35.6 mm
FrontSilk
TopPads
BotPads
PTHs
Pcb
