olin-electric-motorsports/OEM_Preferred_Parts/3DModels/NanoFit_VT_TH_2x2/NF_VT_TH_2x2.stp

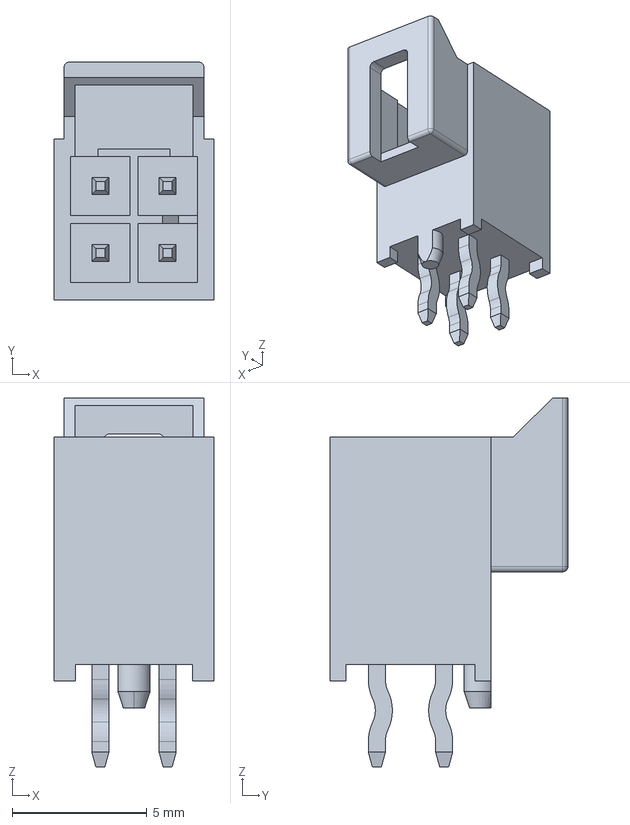
[picture p78: CAD file, 2020-03-10]
3DModels/NanoFit_VT_TH_2x2/NF_VT_TH_2x2.stp
5.94 x 8.84 x 13.7 mm
