olin-electric-motorsports/OEM_Preferred_Parts/3DModels/NanoFit_VT_TH_2x5/NF_VT_TH_2x5.stp

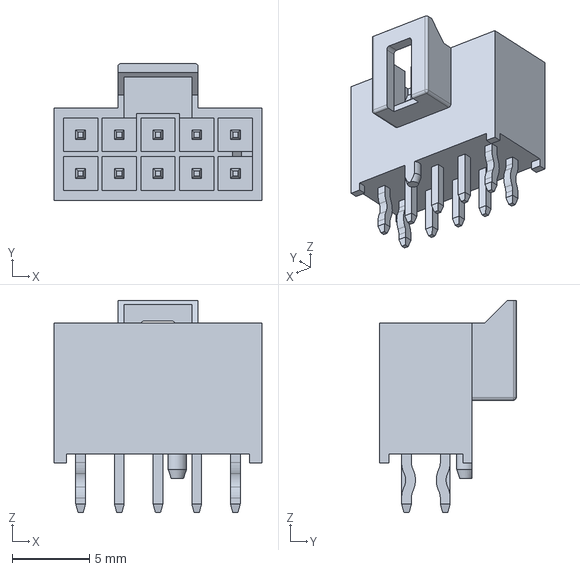
[picture p79: CAD file, 2020-03-10]
3DModels/NanoFit_VT_TH_2x5/NF_VT_TH_2x5.stp
13.4 x 8.84 x 13.7 mm
