olin-electric-motorsports/OEM_Preferred_Parts/3DModels/NanoFit_VT_TH_2x6/NF_VT_TH_2x6.stp

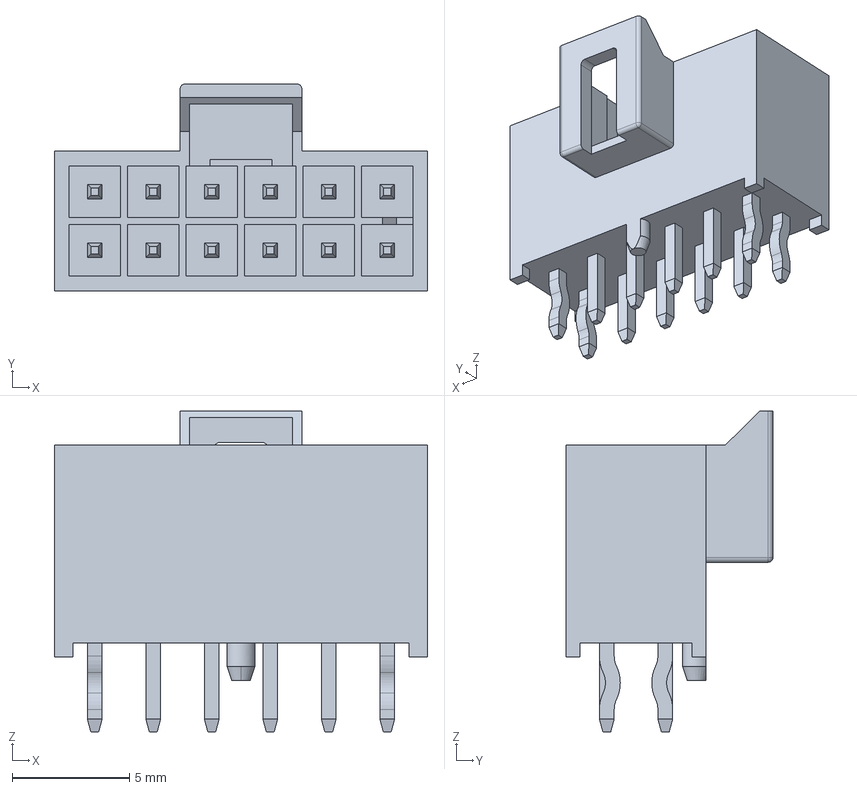
[picture p80: CAD file, 2020-03-10]
3DModels/NanoFit_VT_TH_2x6/NF_VT_TH_2x6.stp
15.9 x 8.84 x 13.7 mm
