olin-electric-motorsports/OEM_Preferred_Parts/3DModels/R_0805_OEM/R_0805.fcstd

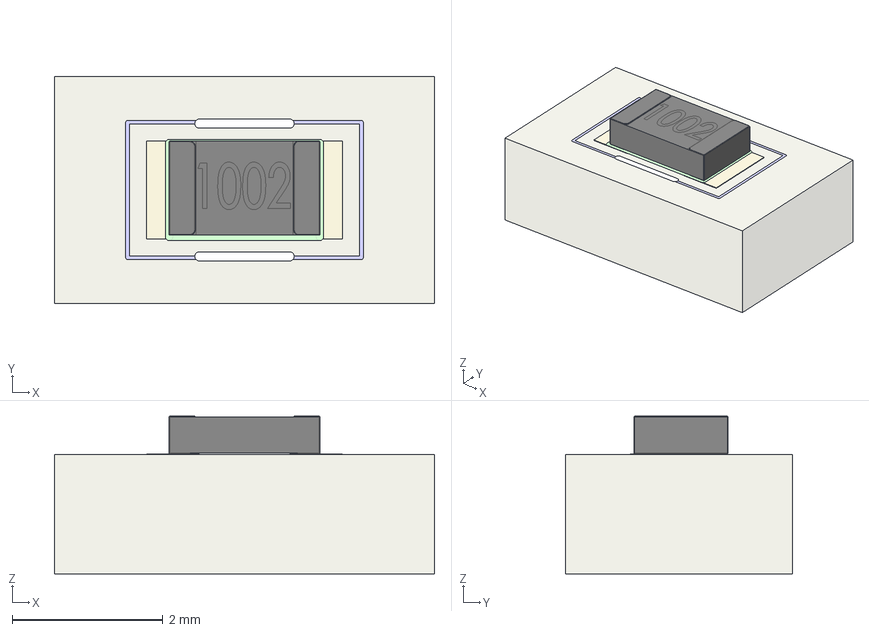
[picture p81: CAD file, 2017-12-01]
3DModels/R_0805_OEM/R_0805.fcstd
5.04 x 3.01 x 2.09 mm
FCrtYd
FFab
FrontSilk
TopPads
Pcb
res0805
