olin-electric-motorsports/OEM_Preferred_Parts/3DModels/R_10K_HV/part_sp.step

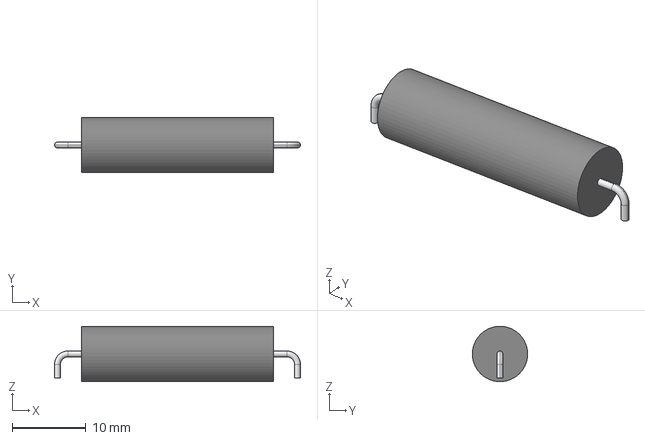
[picture p82: CAD file, 2017-12-29]
3DModels/R_10K_HV/part_sp.step
33.3 x 7.49 x 7.49 mm
