olin-electric-motorsports/OEM_Preferred_Parts/3DModels/R_1k_HS_TO247_OEM/User Library-RA-T2X-25E heat sink.STEP

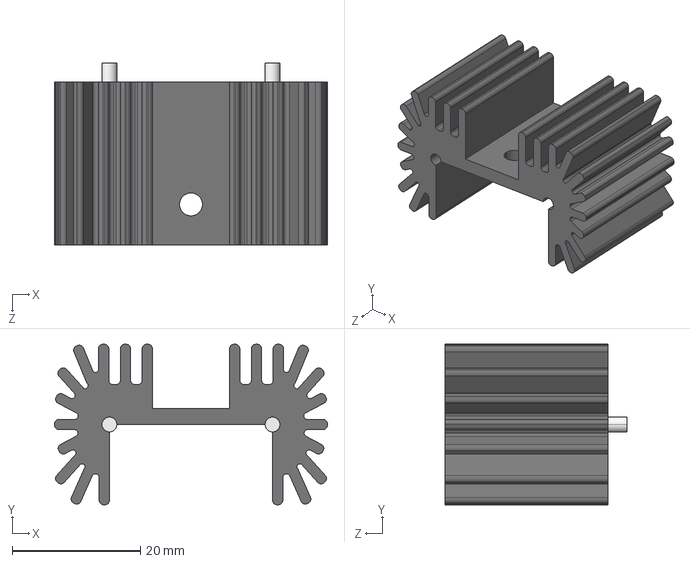
[picture p83: CAD file, 2018-01-29]
3DModels/R_1k_HS_TO247_OEM/User Library-RA-T2X-25E heat sink.STEP
42.5 x 25.0 x 28.4 mm
