olin-electric-motorsports/OEM_Preferred_Parts/3DModels/R_2512_OEM/R_2512_OEM.step

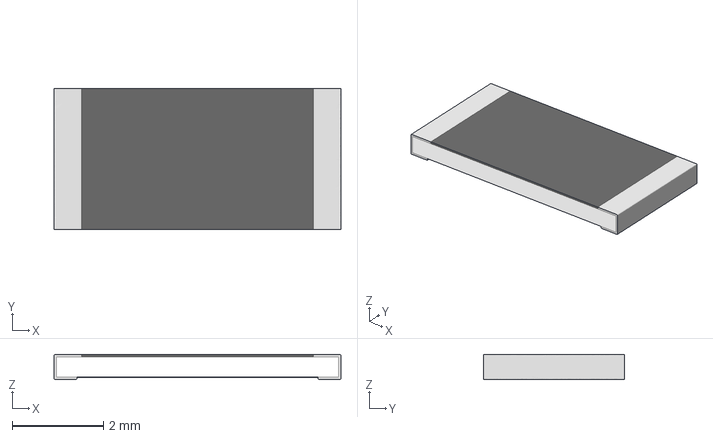
[picture p84: CAD file, 2017-12-29]
3DModels/R_2512_OEM/R_2512_OEM.step
6.30 x 3.10 x 0.55 mm
