olin-electric-motorsports/OEM_Preferred_Parts/3DModels/R_3K_heatsink/RA-T2X-51E_sp001_sp.step

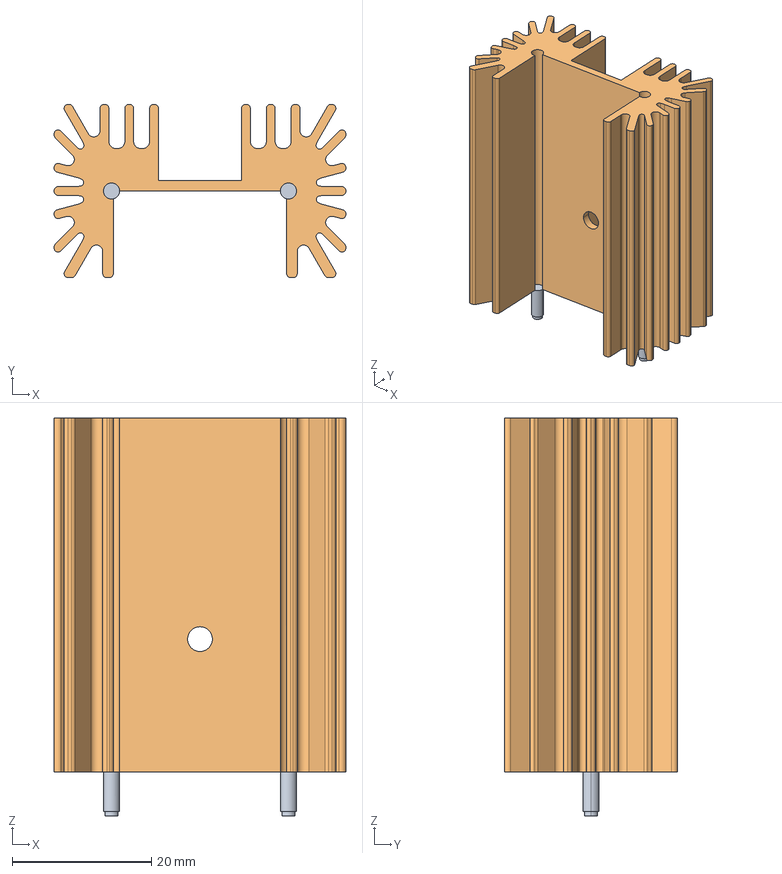
[picture p85: CAD file, 2018-02-13]
3DModels/R_3K_heatsink/RA-T2X-51E_sp001_sp.step
41.9 x 24.9 x 57.1 mm
