olin-electric-motorsports/OEM_Preferred_Parts/3DModels/Radial_Can/C_Radial_D10_L13_P5_OEM.step

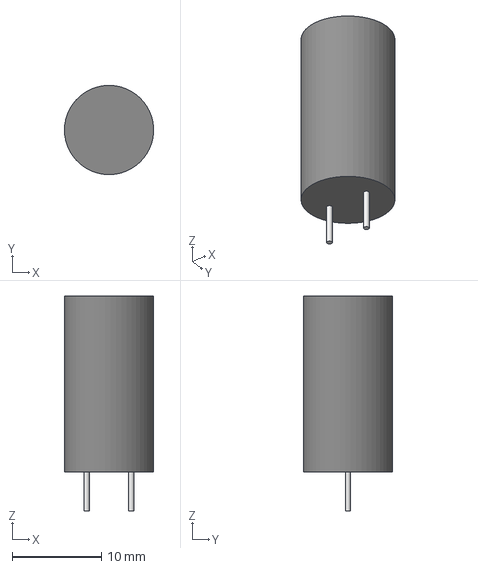
[picture p86: CAD file, 2018-01-06]
3DModels/Radial_Can/C_Radial_D10_L13_P5_OEM.step
10.00 x 10.0 x 24.1 mm
