olin-electric-motorsports/OEM_Preferred_Parts/3DModels/redcube_7461166/redcube_7461166.stp

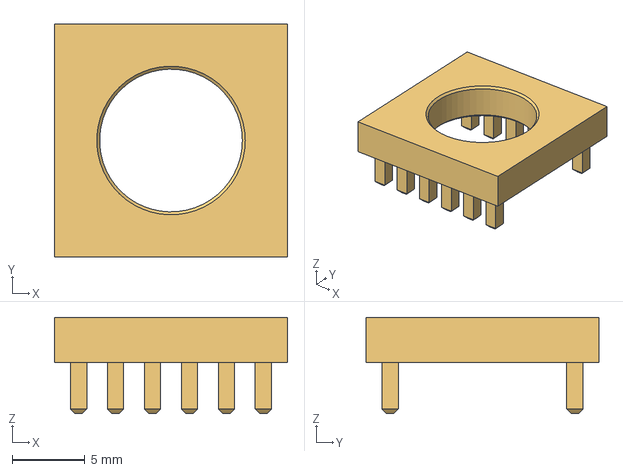
[picture p87: CAD file, 2020-01-17]
3DModels/redcube_7461166/redcube_7461166.stp
16.0 x 16.0 x 6.60 mm
