olin-electric-motorsports/OEM_Preferred_Parts/3DModels/relay_G2RL-1-E/Part 2.step

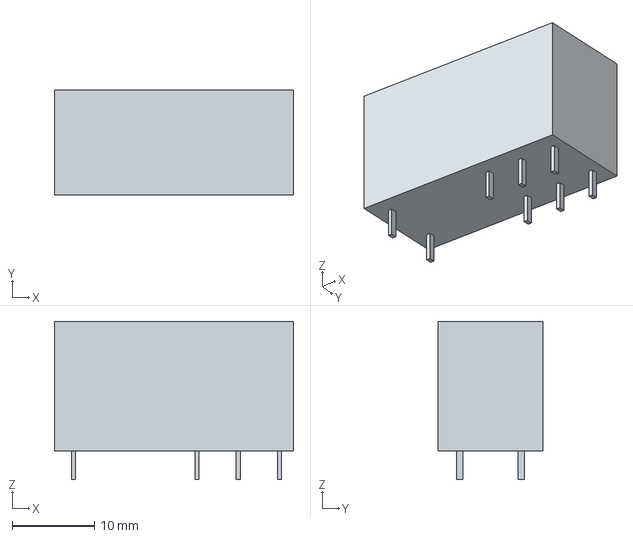
[picture p88: CAD file, 2017-12-29]
3DModels/relay_G2RL-1-E/Part 2.step
29.0 x 12.7 x 19.2 mm
