olin-electric-motorsports/OEM_Preferred_Parts/3DModels/rj45-vert/rj45-vert.step

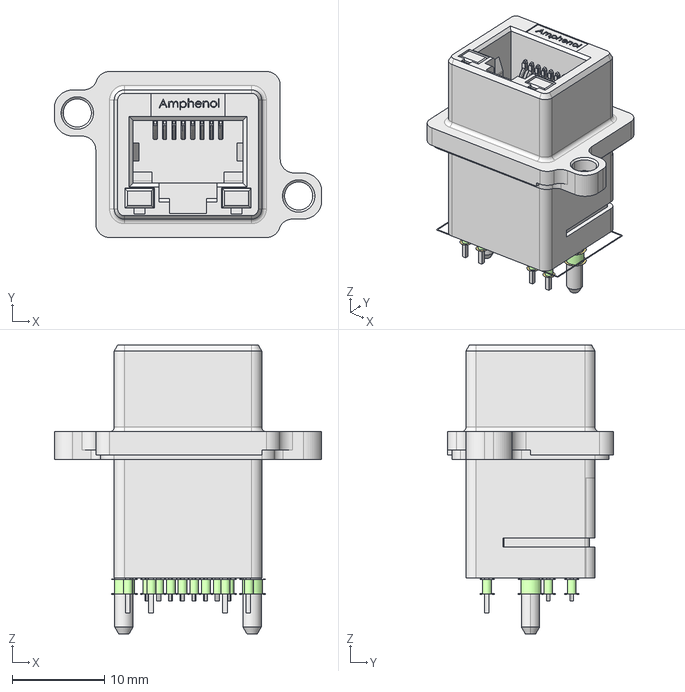
[picture p89: CAD file, 2018-02-09]
3DModels/rj45-vert/rj45-vert.step
29.0 x 18.0 x 31.3 mm
