olin-electric-motorsports/OEM_Preferred_Parts/3DModels/SC-70-5/User Library-SC70-5-1.STEP

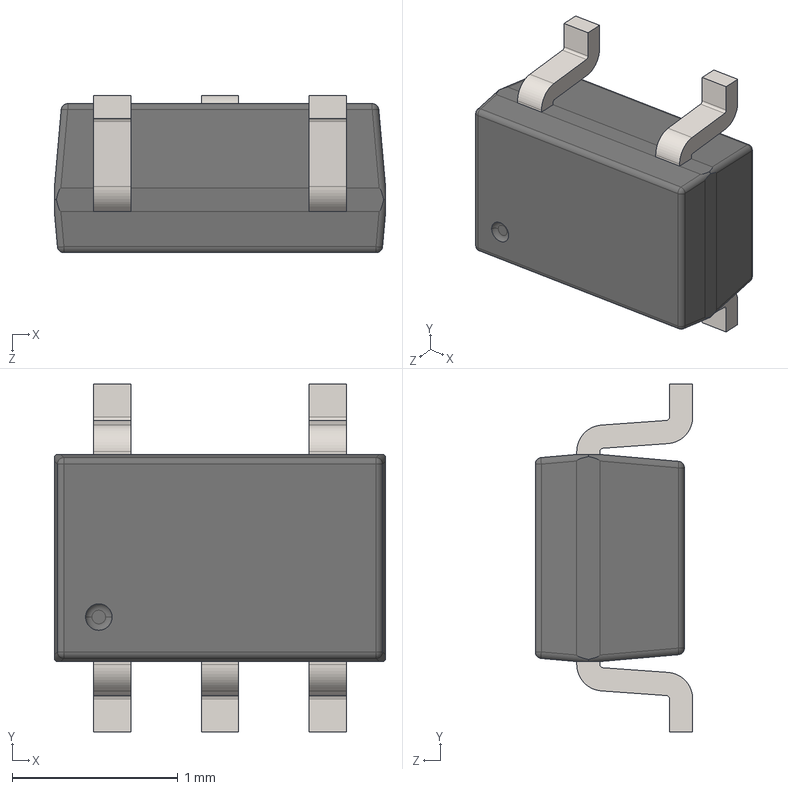
[picture p90: CAD file, 2019-01-19]
3DModels/SC-70-5/User Library-SC70-5-1.STEP
2.00 x 2.10 x 0.95 mm
