olin-electric-motorsports/OEM_Preferred_Parts/3DModels/SEGMENT_BICOL_BL-AR12Z3010/led_bar.step

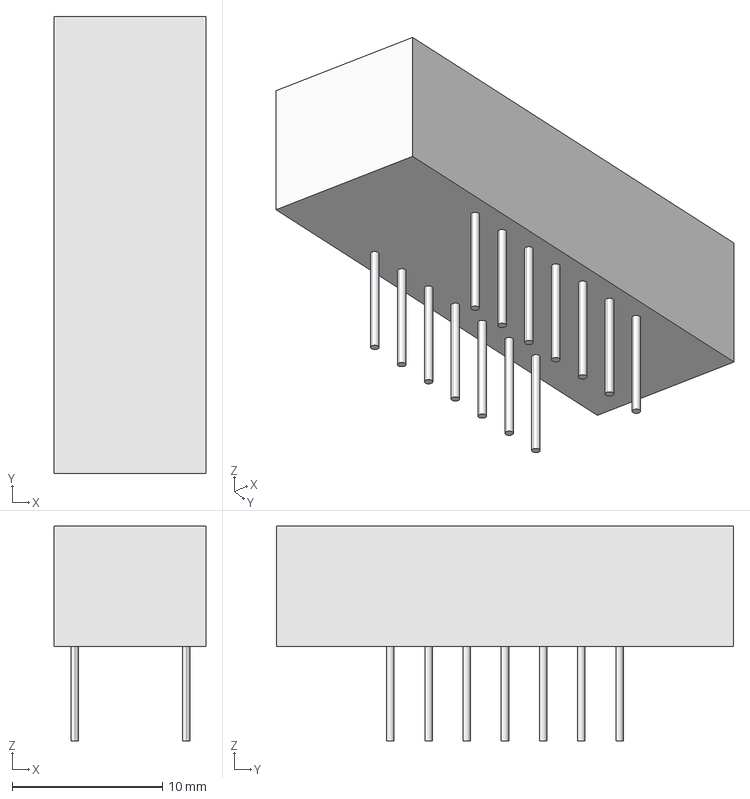
[picture p91: CAD file, 2018-02-22]
3DModels/SEGMENT_BICOL_BL-AR12Z3010/led_bar.step
10.1 x 30.4 x 14.3 mm
