olin-electric-motorsports/OEM_Preferred_Parts/3DModels/SMB_OEM/SMB.step

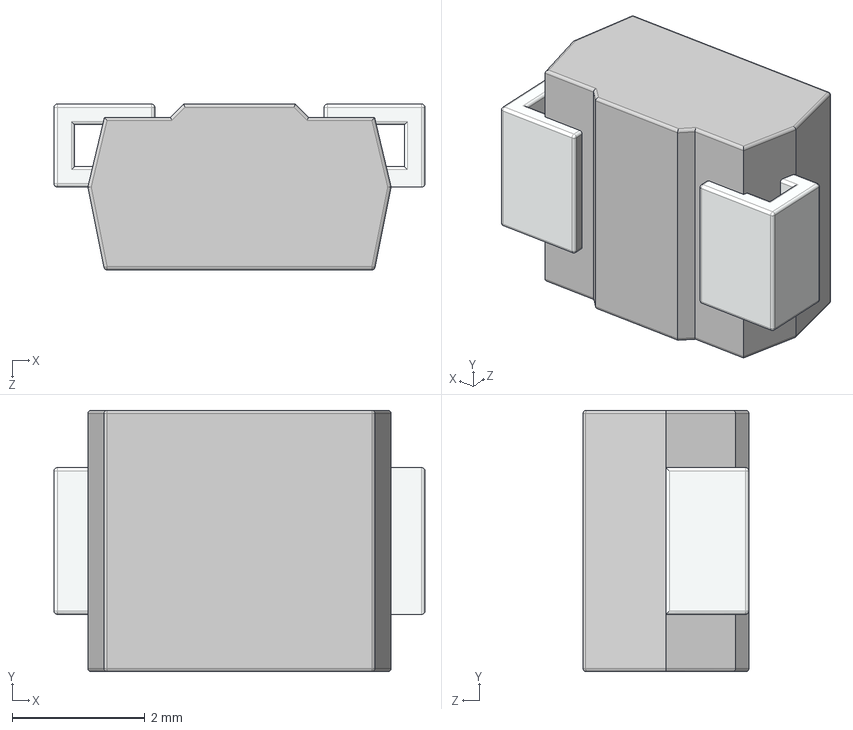
[picture p92: CAD file, 2020-12-02]
3DModels/SMB_OEM/SMB.step
5.59 x 3.94 x 2.50 mm
