olin-electric-motorsports/OEM_Preferred_Parts/3DModels/SOD-123_OEM/SOD-123.step

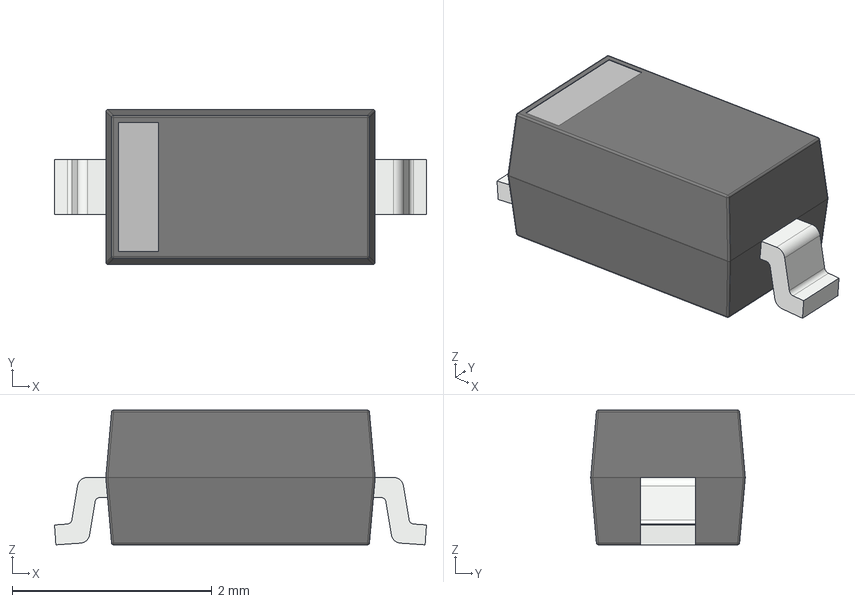
[picture p93: CAD file, 2017-12-01]
3DModels/SOD-123_OEM/SOD-123.step
3.73 x 1.55 x 1.35 mm
