olin-electric-motorsports/OEM_Preferred_Parts/3DModels/SOD_923_OEM/SOD-923.step

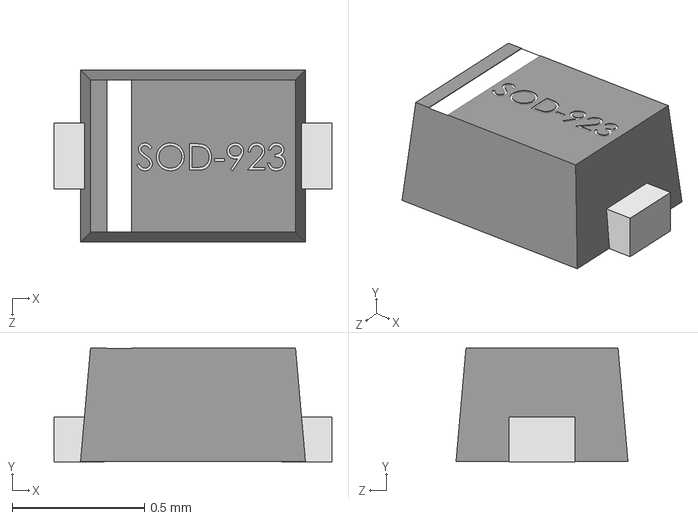
[picture p94: CAD file, 2020-12-02]
3DModels/SOD_923_OEM/SOD-923.step
1.05 x 0.43 x 0.65 mm
