olin-electric-motorsports/OEM_Preferred_Parts/3DModels/SOT-223/sot-223.STEP

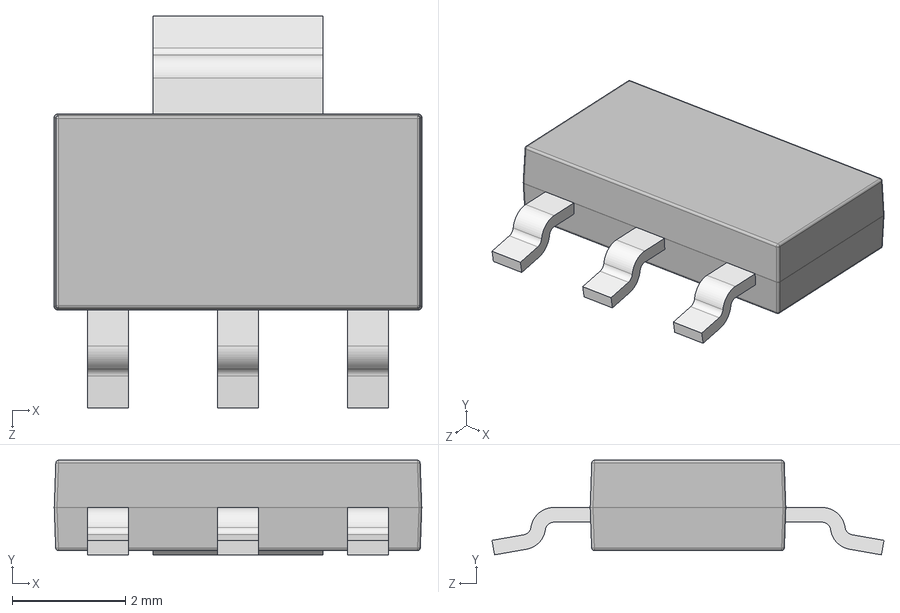
[picture p95: CAD file, 2019-01-19]
3DModels/SOT-223/sot-223.STEP
6.50 x 1.67 x 6.93 mm
