olin-electric-motorsports/OEM_Preferred_Parts/3DModels/SOT-23-5(generic)/SOT-23-5(generic).step

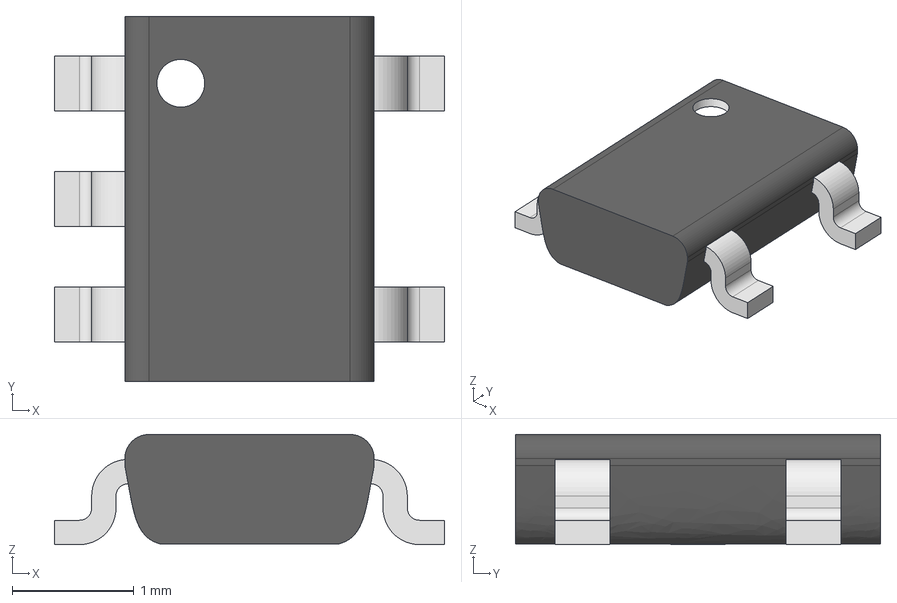
[picture p96: CAD file, 2017-12-29]
3DModels/SOT-23-5(generic)/SOT-23-5(generic).step
3.20 x 3.00 x 0.905 mm
