olin-electric-motorsports/OEM_Preferred_Parts/3DModels/SOT-23-6(generic)/SOT-23-6(generic).step

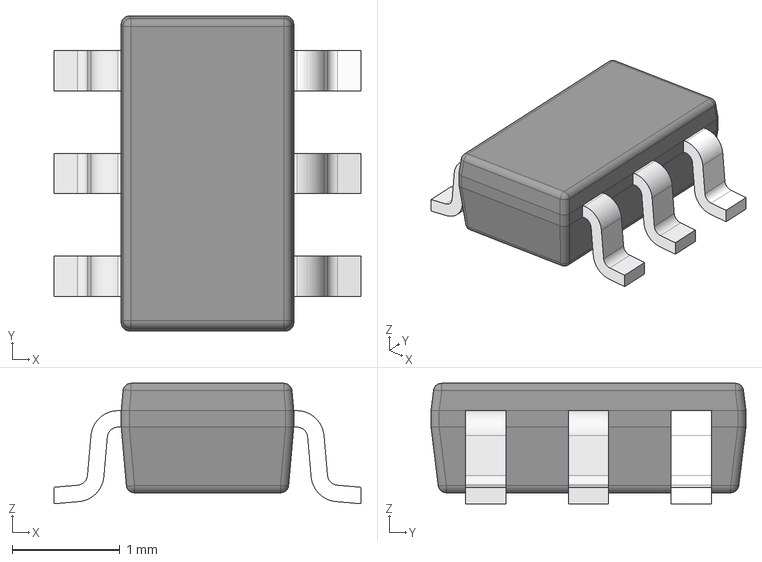
[picture p97: CAD file, 2017-12-29]
3DModels/SOT-23-6(generic)/SOT-23-6(generic).step
2.84 x 2.92 x 1.12 mm
