olin-electric-motorsports/OEM_Preferred_Parts/3DModels/SOT-23_OEM/SOT-23.step

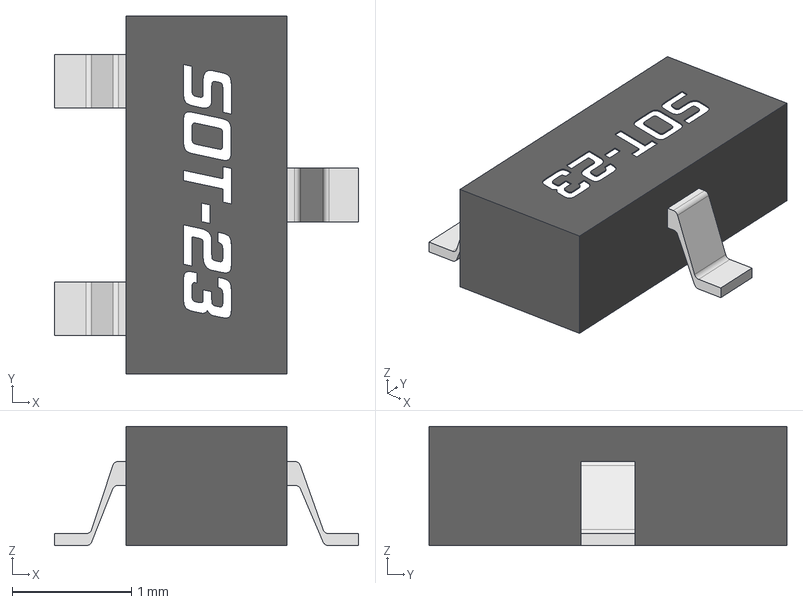
[picture p98: CAD file, 2017-12-01]
3DModels/SOT-23_OEM/SOT-23.step
2.55 x 3.00 x 1.00 mm
