olin-electric-motorsports/OEM_Preferred_Parts/3DModels/SOT223/SOT223.stp

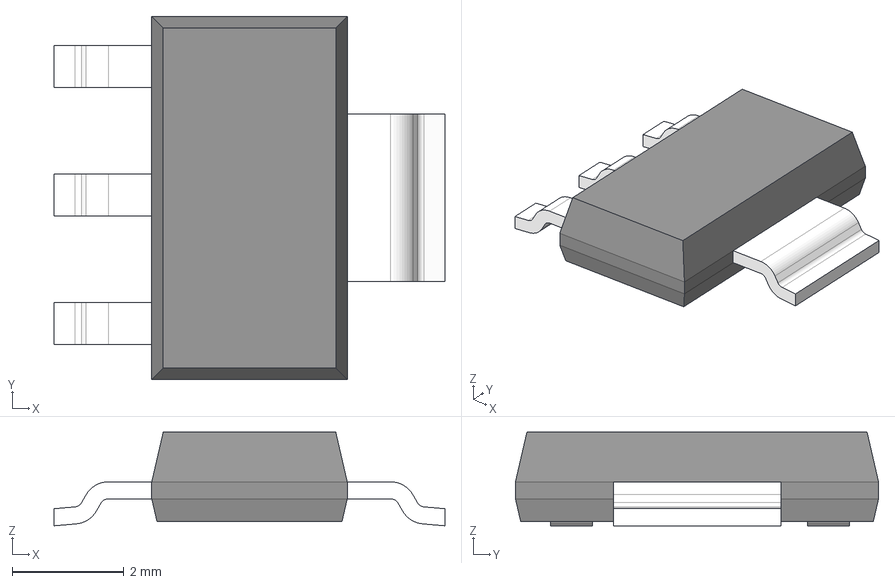
[picture p99: CAD file, 2019-11-15]
3DModels/SOT223/SOT223.stp
7.00 x 6.50 x 1.68 mm
BODY-SOT
LEAD-SOT x 3
LEAD-SOT-WIDE
PIN1-ID
