olin-electric-motorsports/OEM_Preferred_Parts/3DModels/SOT_753/SOT753.STEP

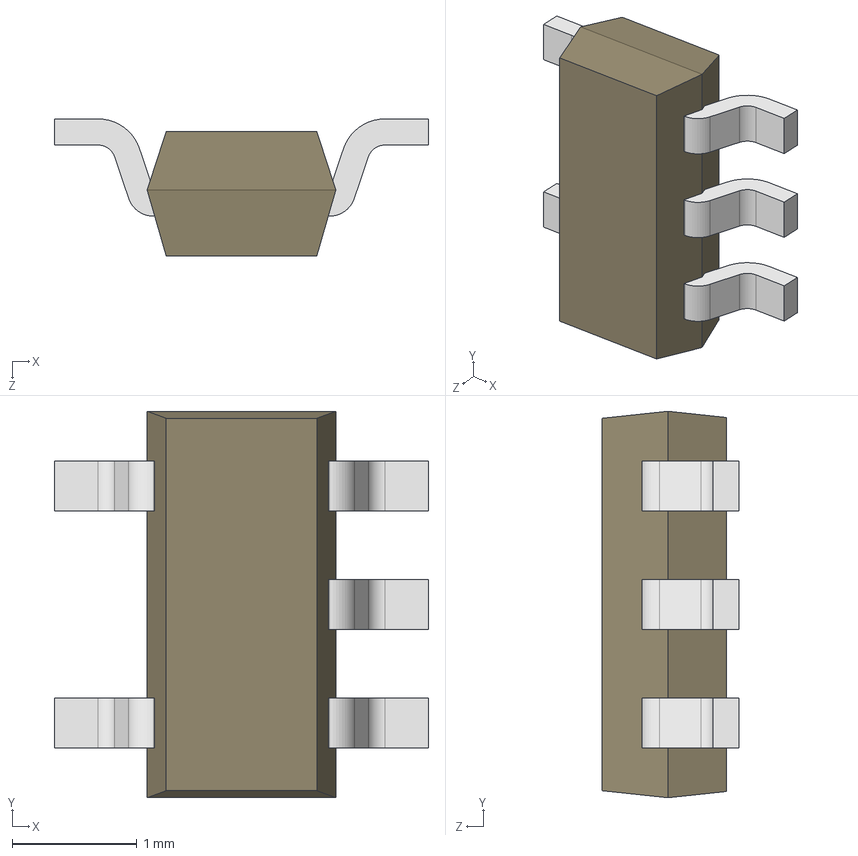
[picture p100: CAD file, 2019-01-19]
3DModels/SOT_753/SOT753.STEP
3.00 x 3.10 x 1.10 mm
