olin-electric-motorsports/OEM_Preferred_Parts/3DModels/SOT_89_OEM/SOT-89.step

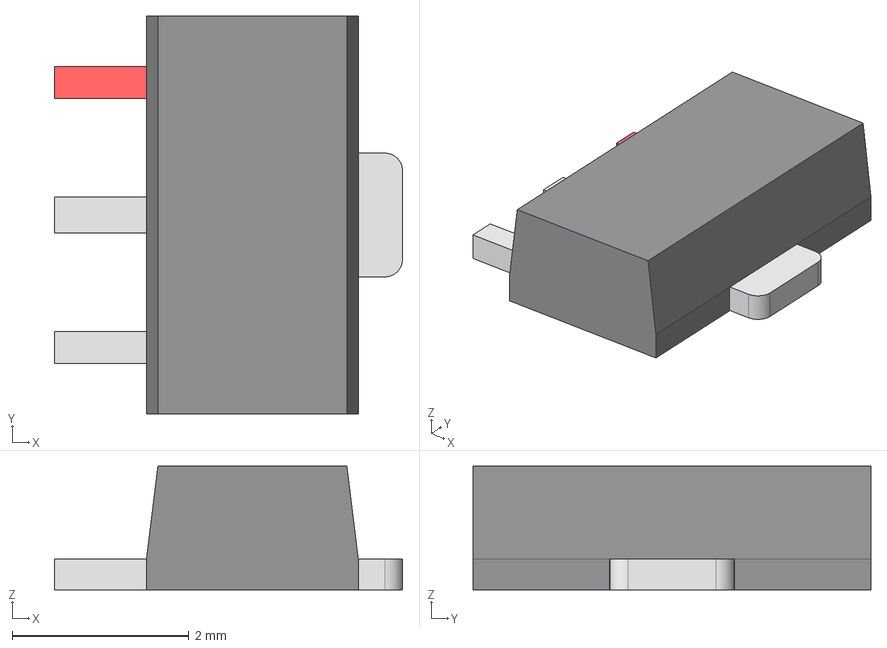
[picture p101: CAD file, 2018-01-29]
3DModels/SOT_89_OEM/SOT-89.step
3.94 x 4.50 x 1.40 mm
