olin-electric-motorsports/OEM_Preferred_Parts/3DModels/SS-126-G-2/SS-126-G-2.stp

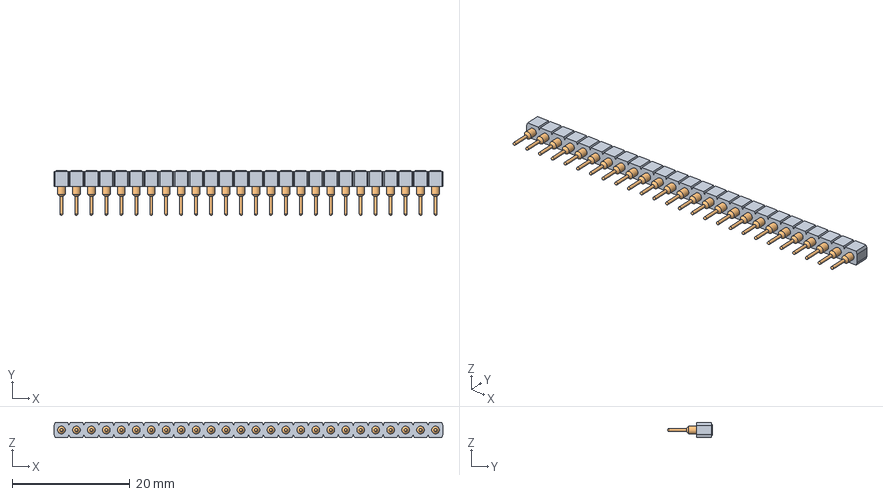
[picture p102: CAD file, 2019-04-12]
3DModels/SS-126-G-2/SS-126-G-2.stp
66.0 x 7.62 x 2.54 mm
_SS-126_socket
_SC-1P1_pins x 26
