olin-electric-motorsports/OEM_Preferred_Parts/3DModels/Standex Meder Relay/Standex_Meder_Relay.STEP

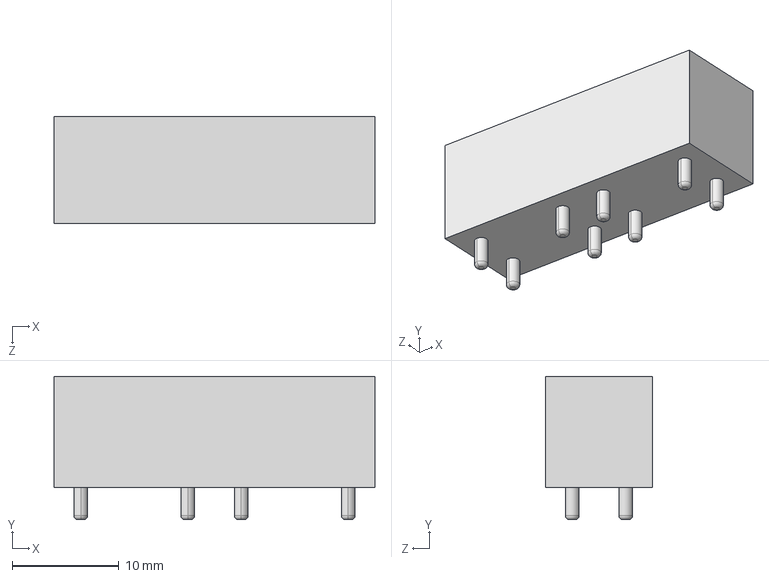
[picture p103: CAD file, 2019-03-15]
3DModels/Standex Meder Relay/Standex_Meder_Relay.STEP
30.0 x 13.4 x 10.0 mm
