olin-electric-motorsports/OEM_Preferred_Parts/3DModels/TLIN1021DRQ1/TLIN1021DRQ1.stp

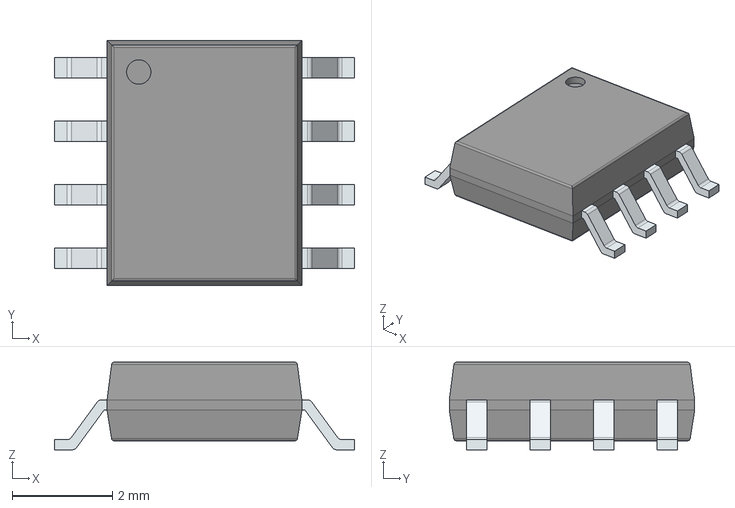
[picture p104: CAD file, 2020-12-08]
3DModels/TLIN1021DRQ1/TLIN1021DRQ1.stp
6.00 x 4.91 x 1.75 mm
PinsArrayLR
