olin-electric-motorsports/OEM_Preferred_Parts/3DModels/TSSOP-16_OEM/TSSOP_16.step

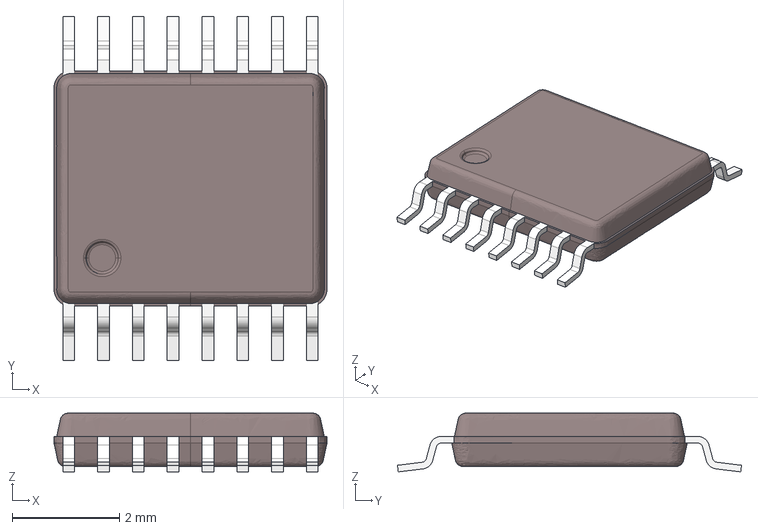
[picture p105: CAD file, 2017-12-01]
3DModels/TSSOP-16_OEM/TSSOP_16.step
5.10 x 6.43 x 1.10 mm
