olin-electric-motorsports/OEM_Preferred_Parts/3DModels/Ultrafit-2/Ultrafit-2.step

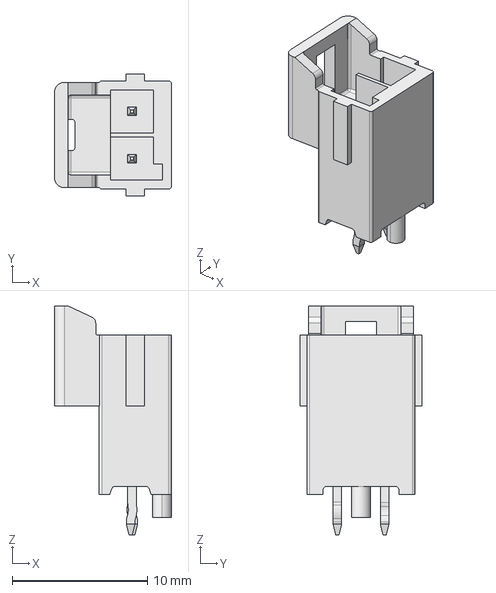
[picture p106: CAD file, 2017-12-04]
3DModels/Ultrafit-2/Ultrafit-2.step
8.67 x 9.00 x 16.9 mm
