olin-electric-motorsports/OEM_Preferred_Parts/3DModels/Ultrafit-5.fcstd

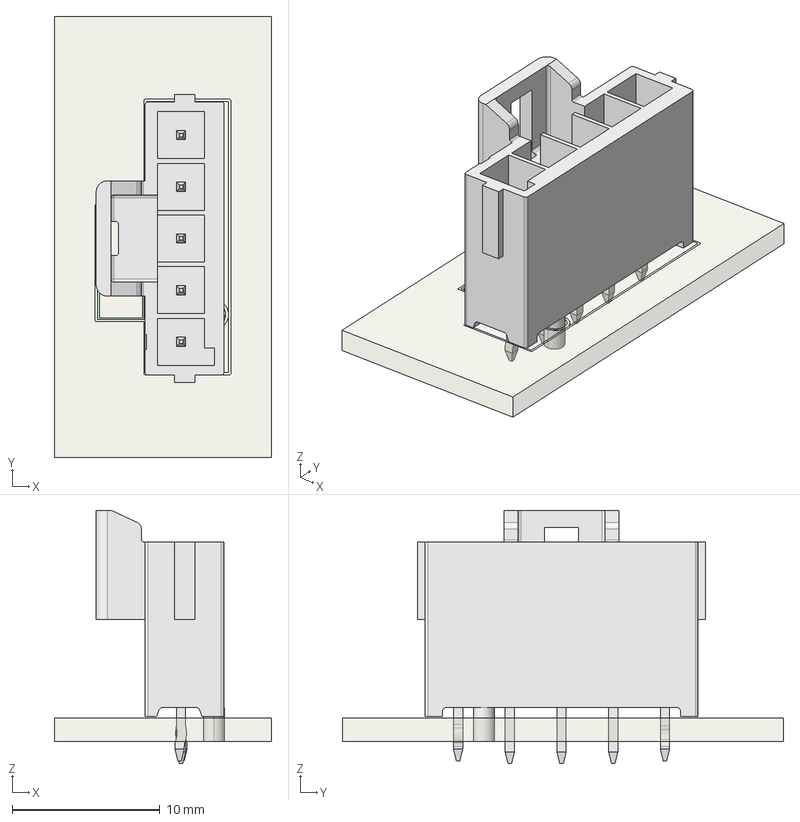
[picture p107: CAD file, 2018-02-08]
3DModels/Ultrafit-5.fcstd
14.7 x 29.8 x 17.1 mm
FFab
FrontSilk
TopPads
BotPads
PTHs
Pcb
COMPOUND_sp
