olin-electric-motorsports/OEM_Preferred_Parts/3DModels/Ultrafit-5/COMPOUND_sp.step

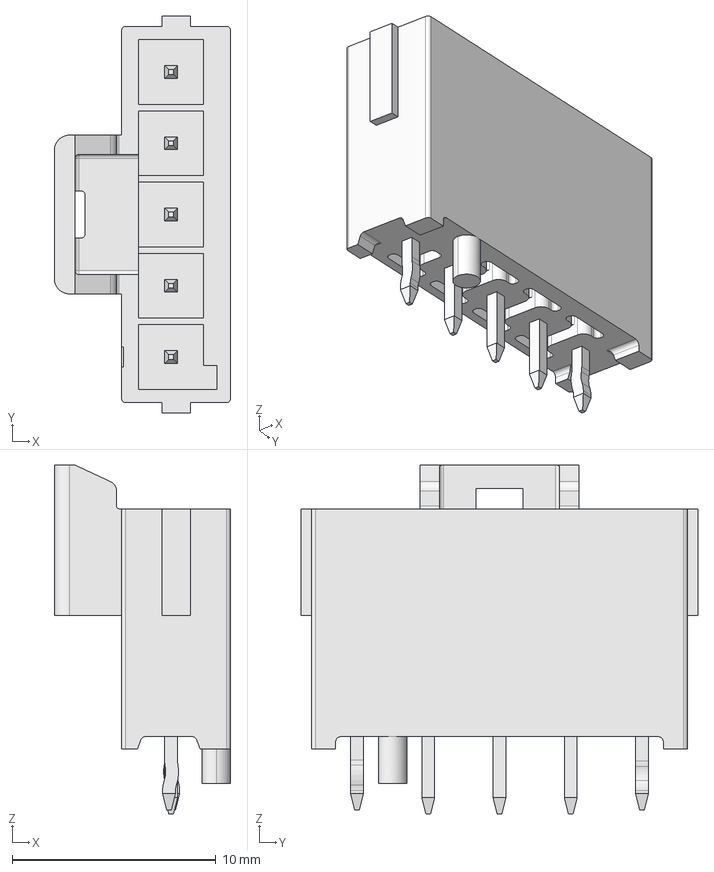
[picture p108: CAD file, 2018-02-08]
3DModels/Ultrafit-5/COMPOUND_sp.step
8.67 x 19.5 x 17.2 mm
