olin-electric-motorsports/OEM_Preferred_Parts/3DModels/USB/SAMTEC-USB-A-S-S-B-SM2.stp

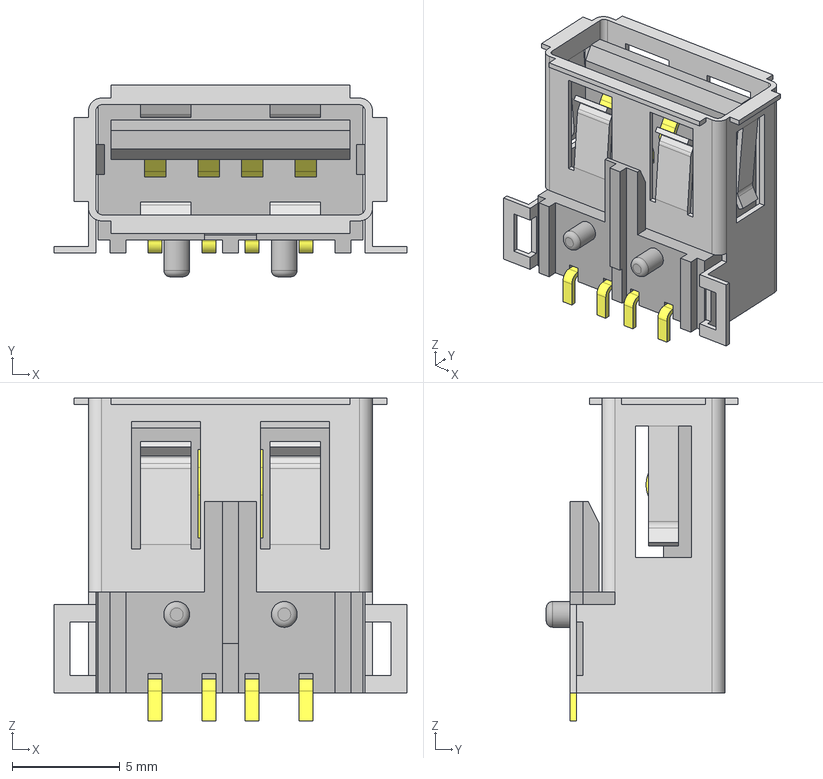
[picture p109: CAD file, 2020-11-04]
3DModels/USB/SAMTEC-USB-A-S-S-B-SM2.stp
16.4 x 8.90 x 15.0 mm
_USB-A-S-SM2_S
_USB-A-S-B-SM2_B
_USB-A-S-SM2_P
