olin-electric-motorsports/OEM_Preferred_Parts/3DModels/3P4T_rotary_switch/prog_switch.step

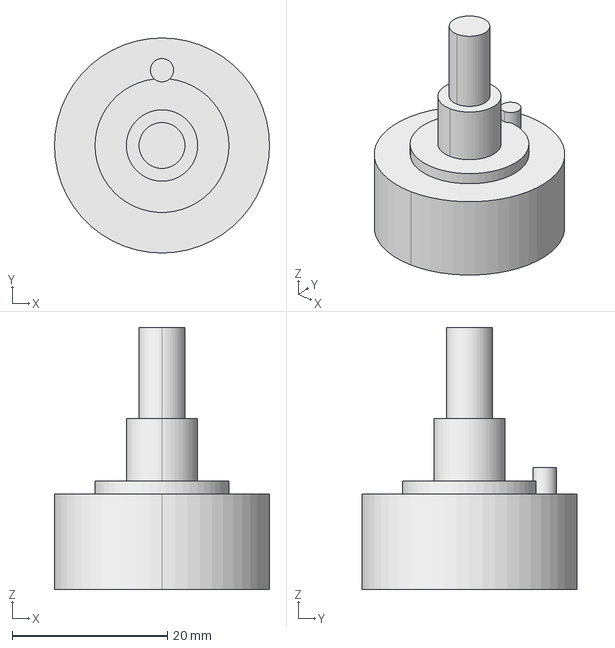
[picture p110: CAD file, 2018-02-22]
3DModels/3P4T_rotary_switch/prog_switch.step
27.7 x 27.7 x 33.8 mm
