olin-electric-motorsports/OEM_Preferred_Parts/3DModels/Ampseal-14/AmpSeal-14.step

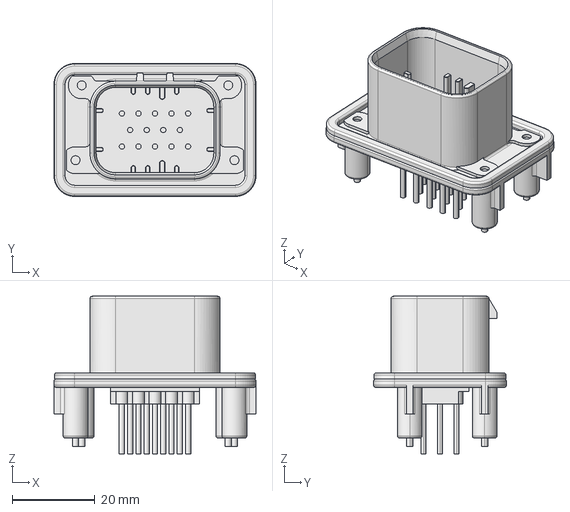
[picture p111: CAD file, 2018-02-08]
3DModels/Ampseal-14/AmpSeal-14.step
48.8 x 32.1 x 38.1 mm
