olin-electric-motorsports/OEM_Preferred_Parts/3DModels/Ampseal-35/Ampseal-35.fcstd

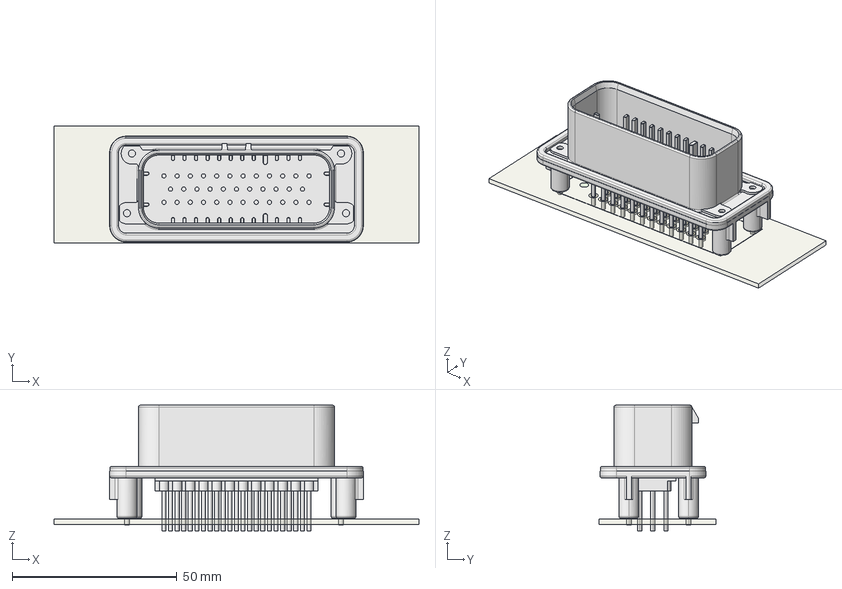
[picture p112: CAD file, 2018-02-19]
3DModels/Ampseal-35/Ampseal-35.fcstd
110.6 x 35.4 x 38.0 mm
FrontSilk
TopPads
BotPads
PTHs
Pcb
C-1-776231-4
