olin-electric-motorsports/OEM_Preferred_Parts/3DModels/AP101_3k_resistor/TIP 144_sp.step

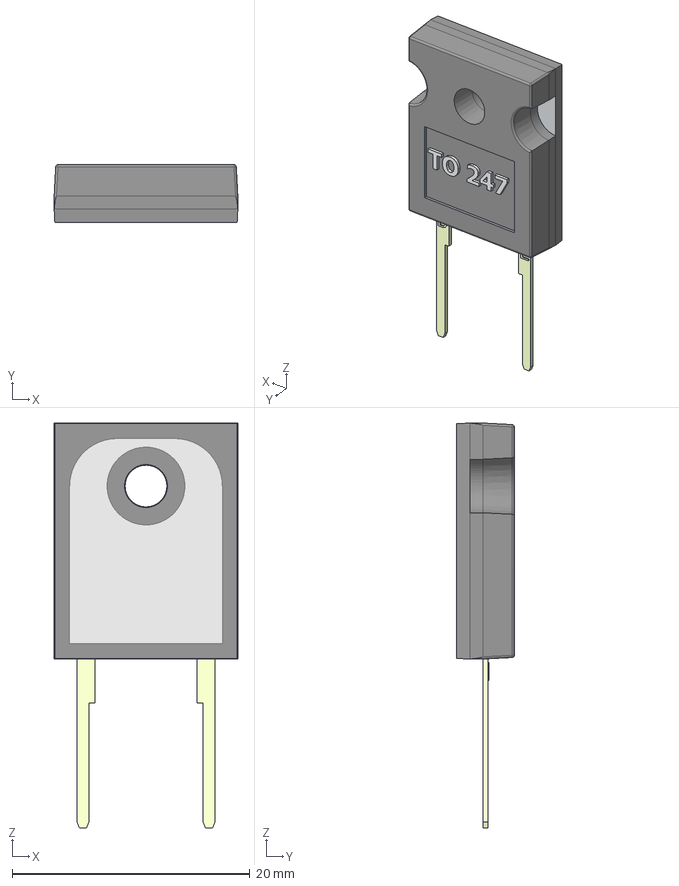
[picture p113: CAD file, 2017-12-29]
3DModels/AP101_3k_resistor/TIP 144_sp.step
15.5 x 4.86 x 34.1 mm
