olin-electric-motorsports/OEM_Preferred_Parts/3DModels/D_Schottky_SOD123/D_Schottky_SOD123.fcstd

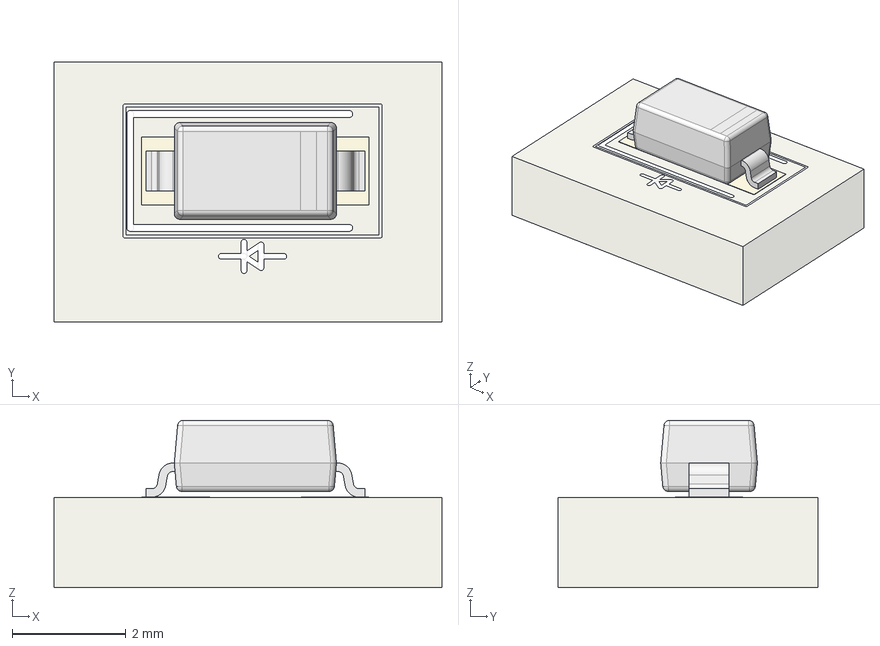
[picture p114: CAD file, 2017-12-29]
3DModels/D_Schottky_SOD123/D_Schottky_SOD123.fcstd
6.82 x 4.58 x 2.94 mm
F_CrtYd
FrontSilk
TopPads
Pcb_solid
DO-215AD002_sp
