olin-electric-motorsports/OEM_Preferred_Parts/3DModels/DTO25/DTO25.fcstd

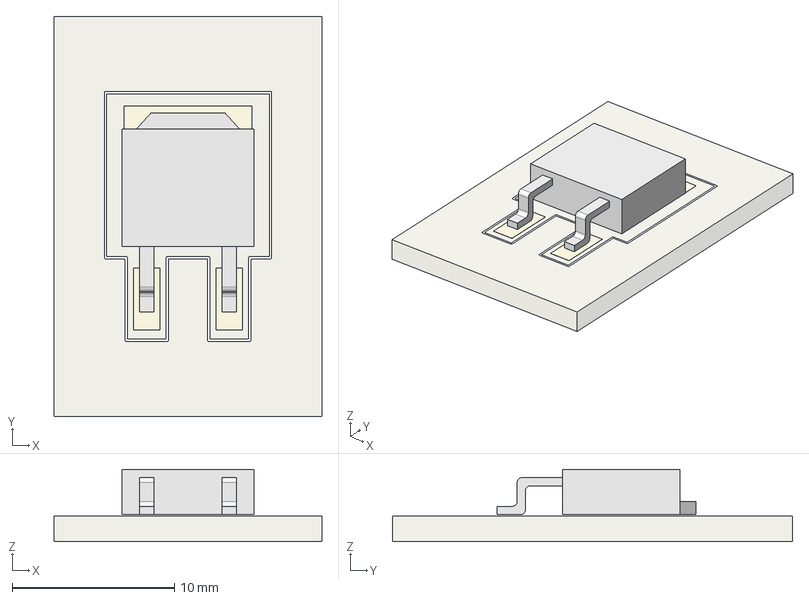
[picture p115: CAD file, 2018-01-06]
3DModels/DTO25/DTO25.fcstd
16.5 x 24.6 x 4.46 mm
FrontSilk
TopPads
Pcb
DTO025
