olin-electric-motorsports/OEM_Preferred_Parts/3DModels/Fuse_807/Part 1.step

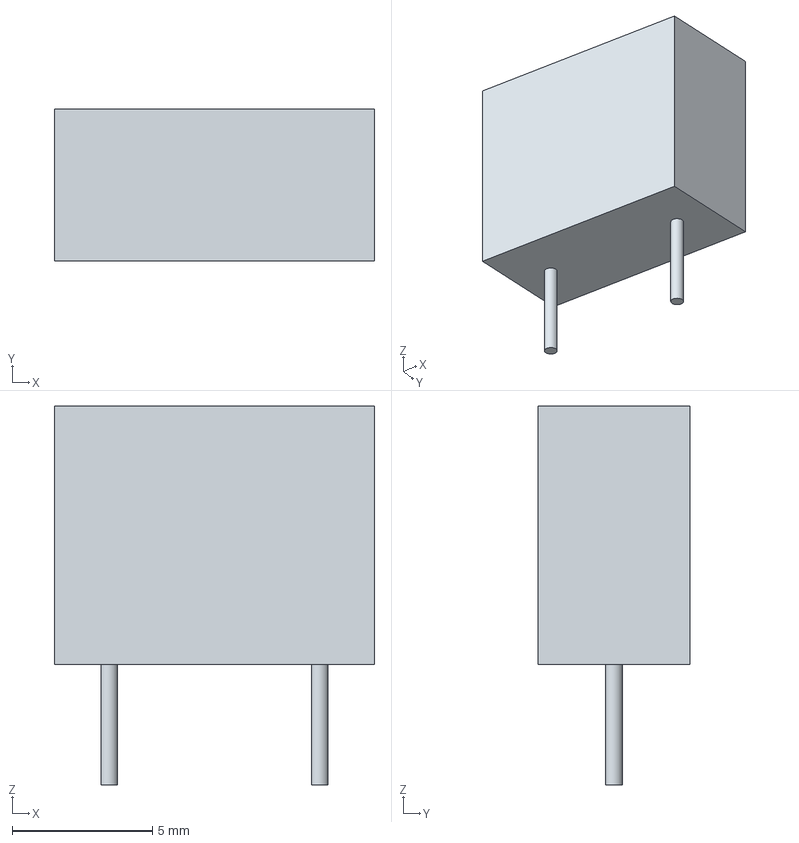
[picture p116: CAD file, 2017-12-29]
3DModels/Fuse_807/Part 1.step
11.4 x 5.40 x 13.5 mm
