olin-electric-motorsports/OEM_Preferred_Parts/3DModels/Header_Pin_2x3/Header_Straight_2x3.step

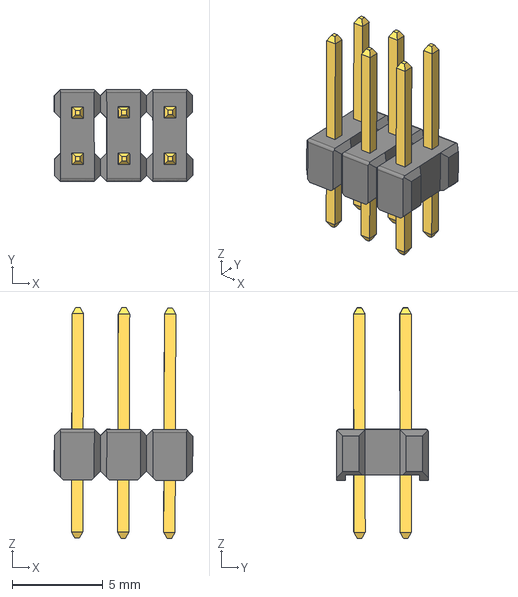
[picture p117: CAD file, 2018-01-06]
3DModels/Header_Pin_2x3/Header_Straight_2x3.step
7.63 x 5.09 x 12.7 mm
