olin-electric-motorsports/OEM_Preferred_Parts/3DModels/LED_0805/LED 0805 Base GREEN001_sp.step

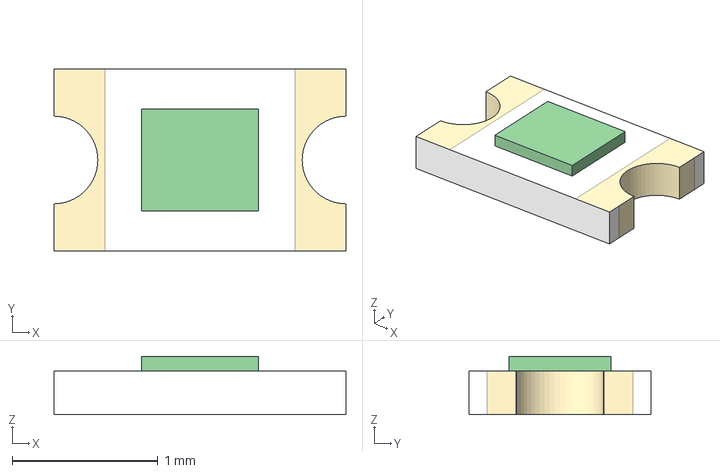
[picture p118: CAD file, 2017-12-01]
3DModels/LED_0805/LED 0805 Base GREEN001_sp.step
2.00 x 1.25 x 0.4 mm
