olin-electric-motorsports/OEM_Preferred_Parts/3DModels/MicroFit_VT_4/MicroFit_4_OtherSide.stp

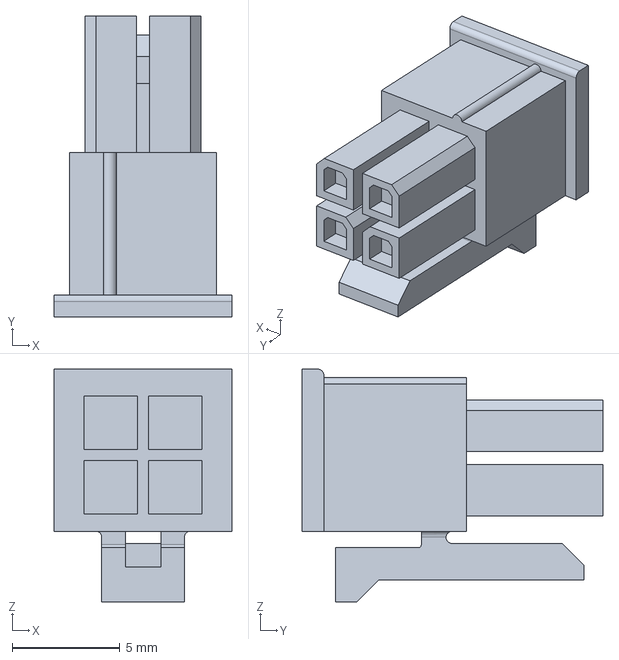
[picture p119: CAD file, 2020-01-15]
3DModels/MicroFit_VT_4/MicroFit_4_OtherSide.stp
8.27 x 14.0 x 10.8 mm
