olin-electric-motorsports/OEM_Preferred_Parts/3DModels/MicroFit_VT_6/MicroFit_6_OtherSide.stp

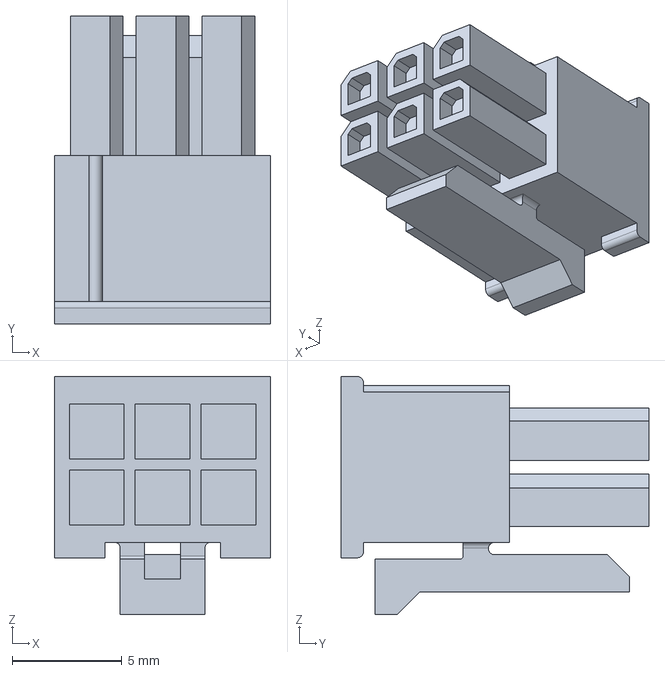
[picture p120: CAD file, 2020-01-15]
3DModels/MicroFit_VT_6/MicroFit_6_OtherSide.stp
9.85 x 14.0 x 10.8 mm
