olin-electric-motorsports/OEM_Preferred_Parts/3DModels/micromatch_female_ra_12/micromatch_female_ra_12.fcstd

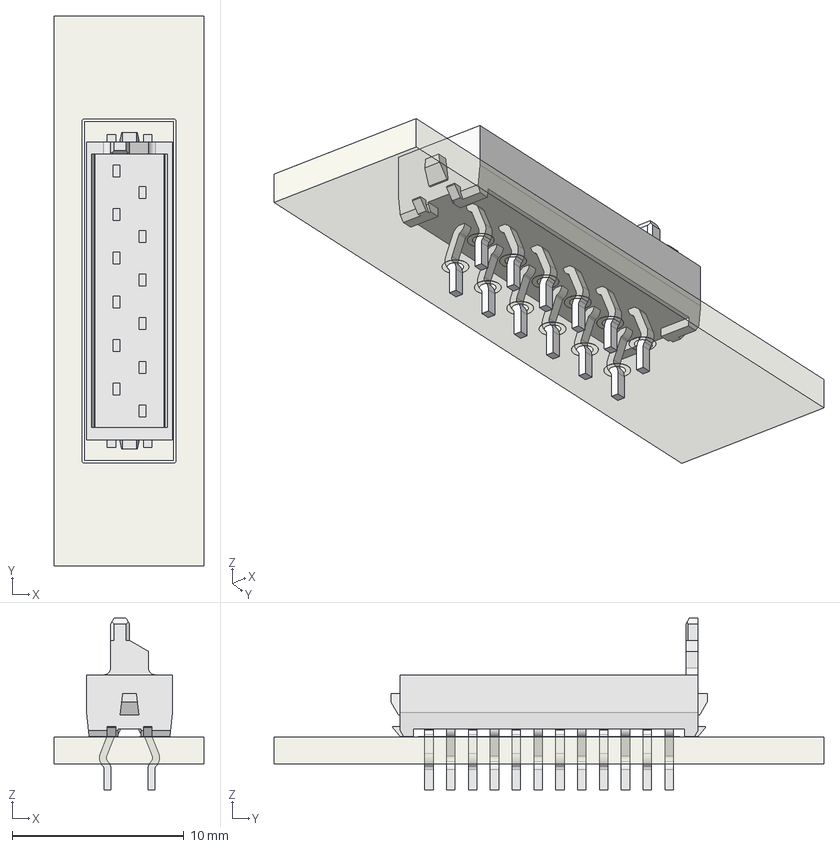
[picture p121: CAD file, 2018-02-22]
3DModels/micromatch_female_ra_12/micromatch_female_ra_12.fcstd
8.72 x 32.0 x 10.0 mm
FrontSilk
TopPads
BotPads
PTHs
Pcb
C-1-215464-2
