olin-electric-motorsports/OEM_Preferred_Parts/3DModels/micromatch_female_ra_18/C-1-215464-8.step

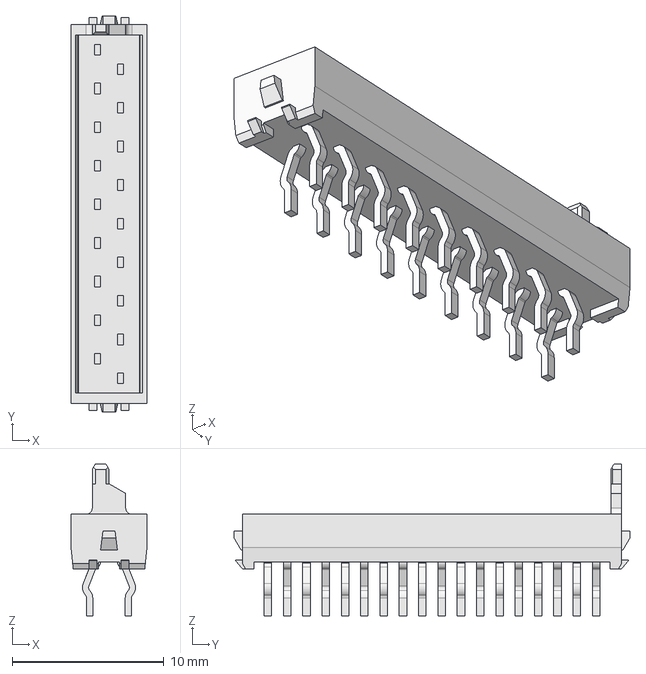
[picture p122: CAD file, 2018-02-22]
3DModels/micromatch_female_ra_18/C-1-215464-8.step
5.00 x 26.0 x 10.0 mm
