olin-electric-motorsports/OEM_Preferred_Parts/3DModels/Micromatch_Female_RA_20/Micromatch_Female_RA_20.step

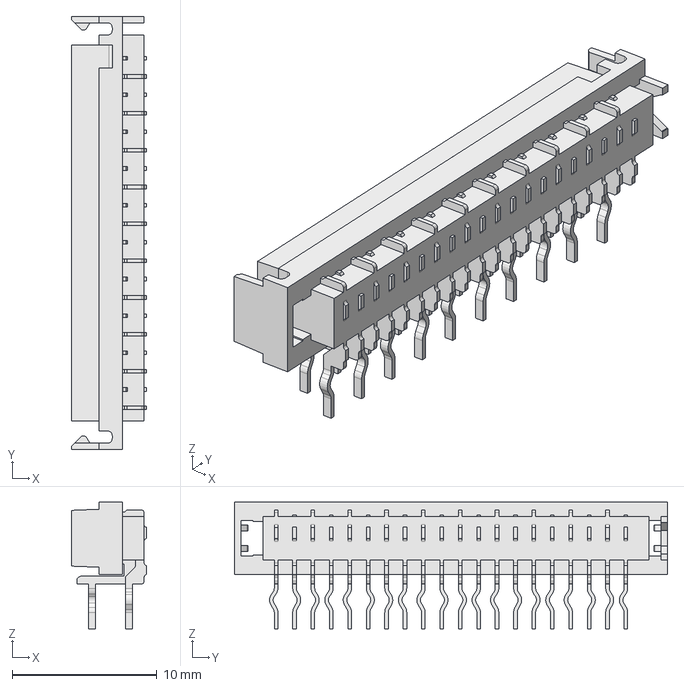
[picture p123: CAD file, 2017-12-29]
3DModels/Micromatch_Female_RA_20/Micromatch_Female_RA_20.step
5.15 x 29.9 x 8.76 mm
