olin-electric-motorsports/OEM_Preferred_Parts/3DModels/micromatch_female_ra_6/micromatch_female_ra_6.fcstd

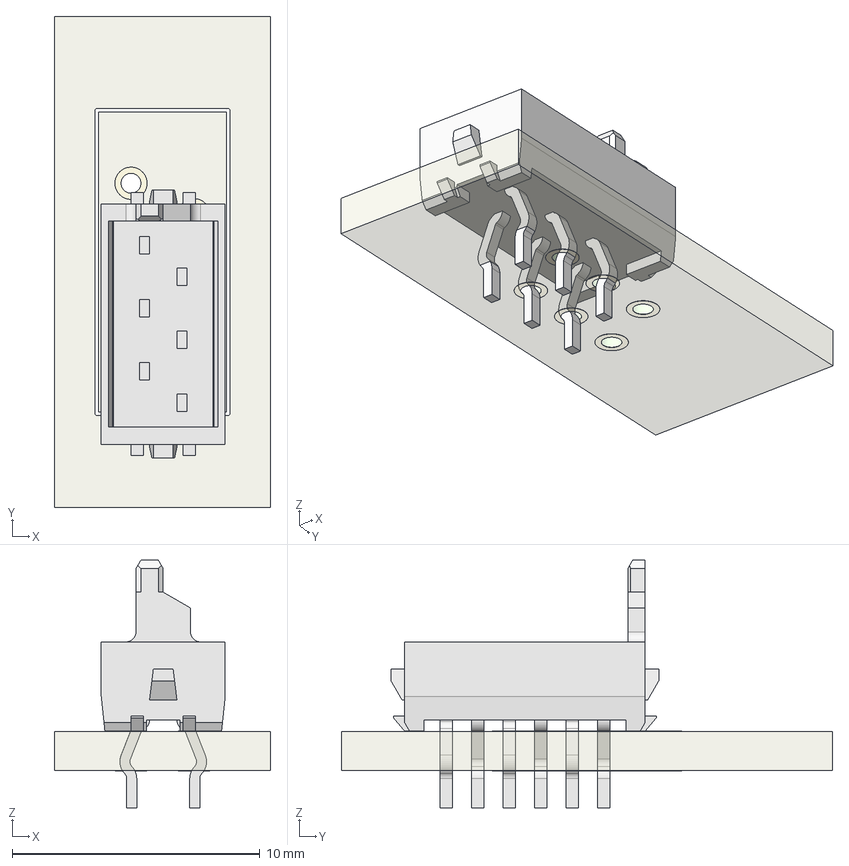
[picture p124: CAD file, 2018-02-22]
3DModels/micromatch_female_ra_6/micromatch_female_ra_6.fcstd
8.72 x 19.8 x 10.0 mm
FrontSilk
TopPads
BotPads
PTHs
Pcb
C-215464-6
