olin-electric-motorsports/OEM_Preferred_Parts/3DModels/micromatch_vert10/micromatch_10_vert.step

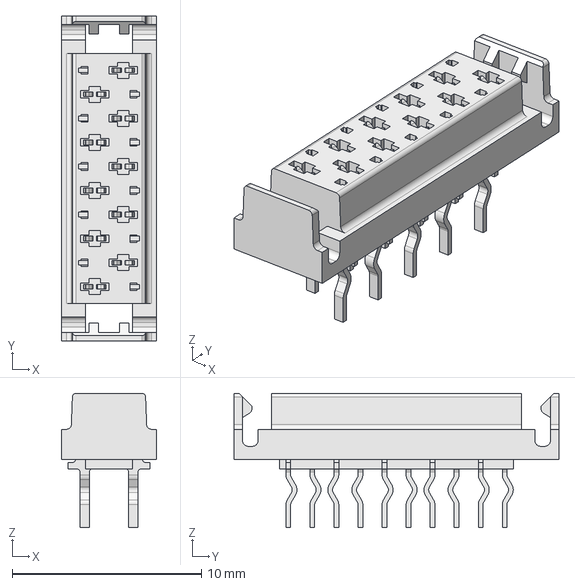
[picture p125: CAD file, 2018-02-08]
3DModels/micromatch_vert10/micromatch_10_vert.step
5.00 x 17.2 x 7.10 mm
