olin-electric-motorsports/OEM_Preferred_Parts/3DModels/Molex_Microfit3_Header_02x10_Angled_OEM_fp/Molex_Microfit3_Header_02x10_Angled_OEM.fcstd

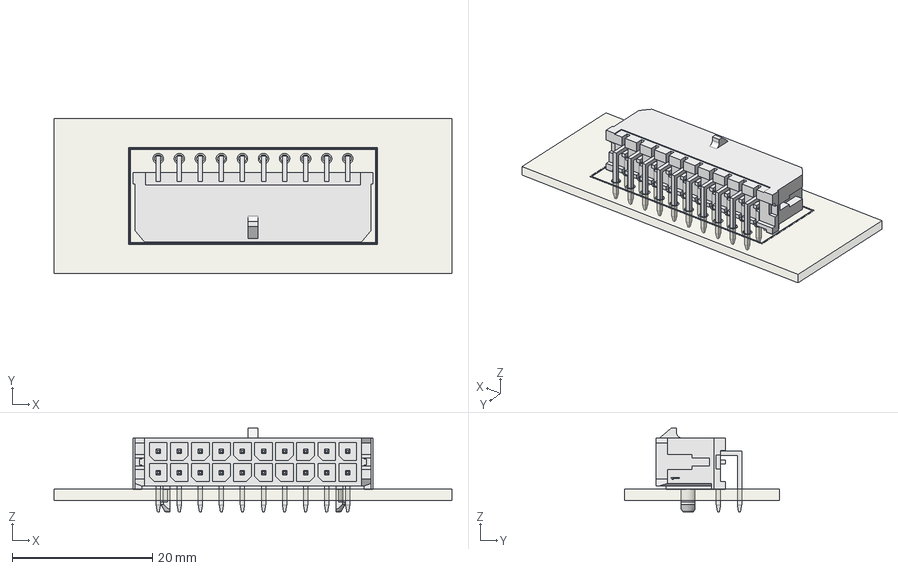
[picture p126: CAD file, 2018-01-06]
3DModels/Molex_Microfit3_Header_02x10_Angled_OEM_fp/Molex_Microfit3_Header_02x10_Angled_OEM.fcstd
56.7 x 22.1 x 12.0 mm
FCrtYd
FrontSilk
TopPads
BotPads
PTHs
Pcb
Molex_Microfit3_Header_02x10_Angled_OEM_fp
