olin-electric-motorsports/OEM_Preferred_Parts/3DModels/Molex_NanoFit_1x02x2_50mm_Angled_OEM/Molex_NanoFit_1x02x2_50mm_Angled_OEM.fcstd

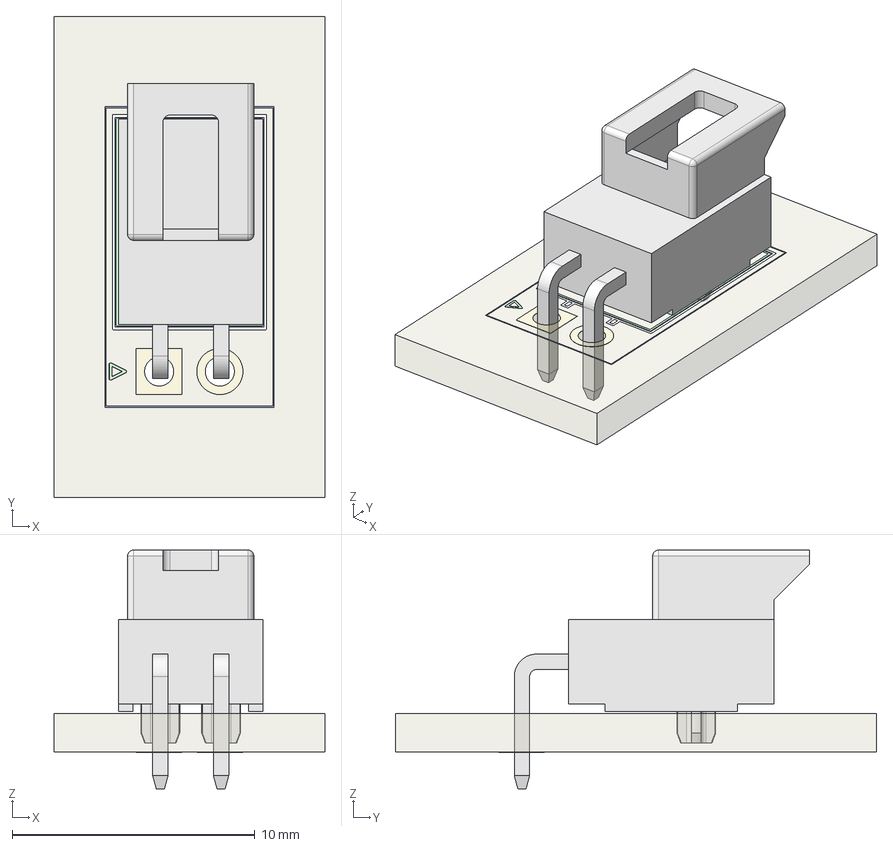
[picture p127: CAD file, 2018-01-06]
3DModels/Molex_NanoFit_1x02x2_50mm_Angled_OEM/Molex_NanoFit_1x02x2_50mm_Angled_OEM.fcstd
11.2 x 19.8 x 9.84 mm
FCrtYd
FFab
FrontSilk
TopPads
BotPads
PTHs
Pcb
Molex_NanoFit_1x02x2_50mm_Angled_OEM001
