olin-electric-motorsports/OEM_Preferred_Parts/3DModels/R_0805_OEM/res0805.step

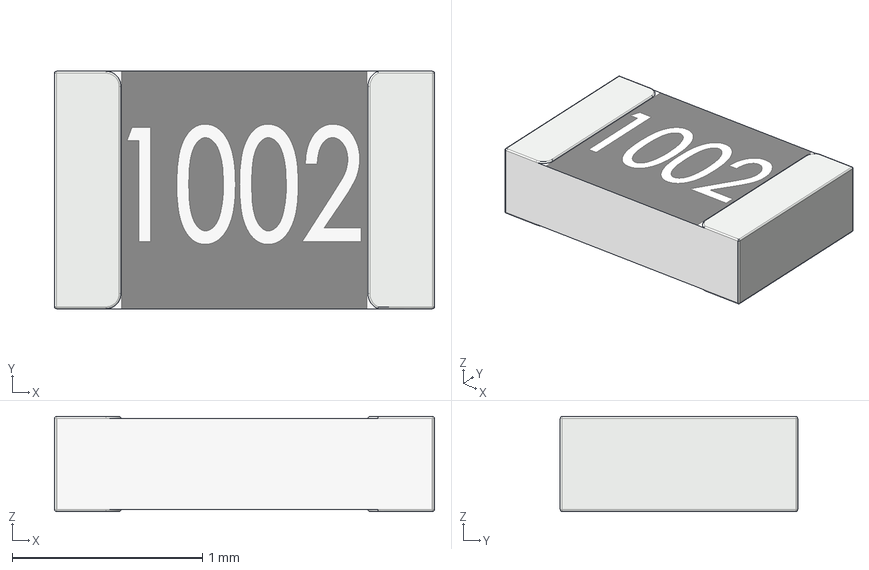
[picture p128: CAD file, 2017-12-01]
3DModels/R_0805_OEM/res0805.step
2.00 x 1.25 x 0.5 mm
