olin-electric-motorsports/OEM_Preferred_Parts/3DModels/R_10K_HV/R_10K_HV.fcstd

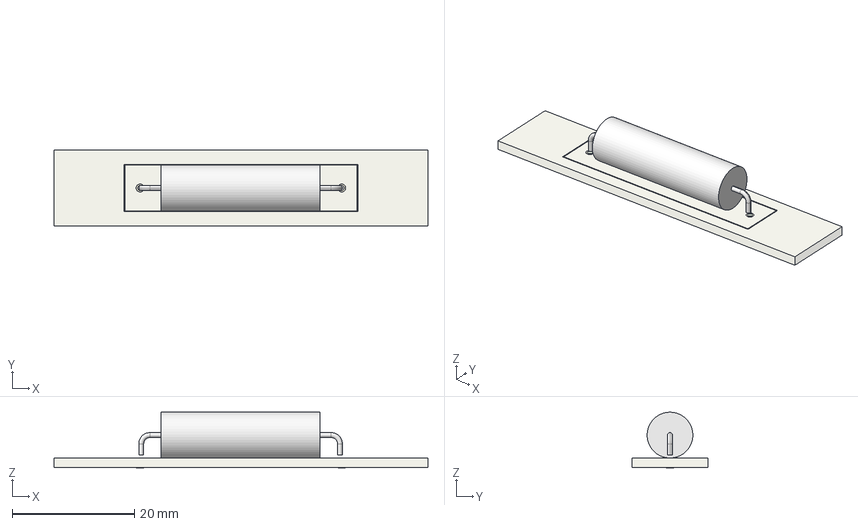
[picture p129: CAD file, 2017-12-29]
3DModels/R_10K_HV/R_10K_HV.fcstd
61.2 x 12.4 x 9.09 mm
FrontSilk
TopPads
BotPads
PTHs
Pcb
part_sp
