olin-electric-motorsports/OEM_Preferred_Parts/3DModels/R_1k_HS_TO247_OEM/R_1k_HS_TO247.step

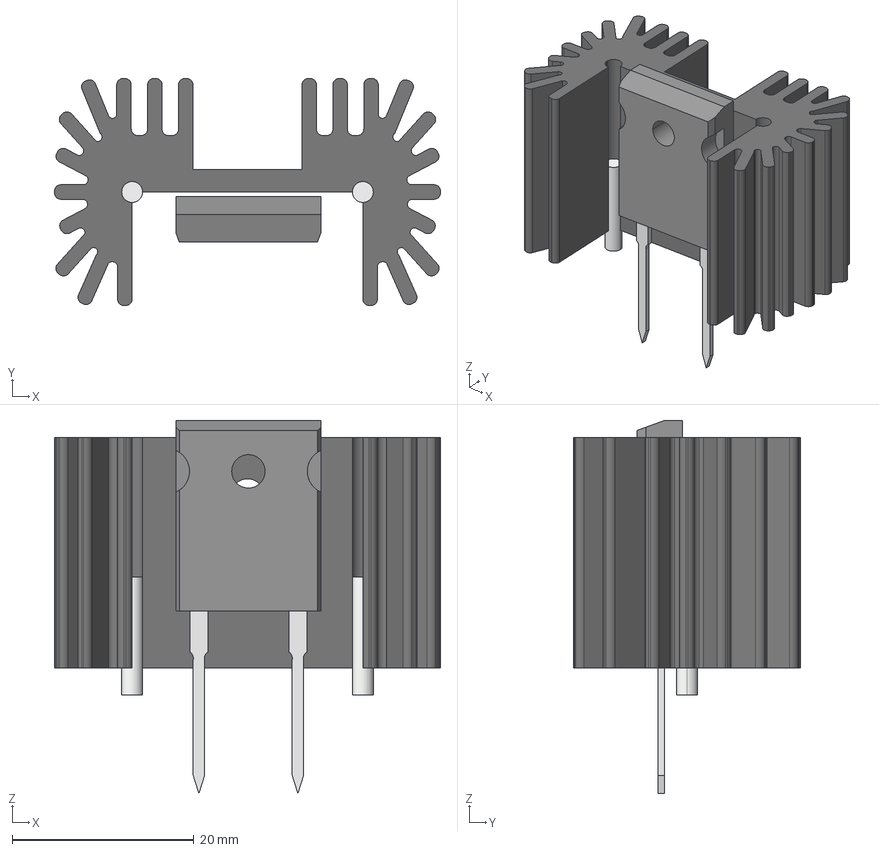
[picture p130: CAD file, 2018-01-29]
3DModels/R_1k_HS_TO247_OEM/R_1k_HS_TO247.step
42.5 x 25.0 x 41.1 mm
