olin-electric-motorsports/OEM_Preferred_Parts/3DModels/R_3K_heatsink/R_3k_heatsink.fcstd

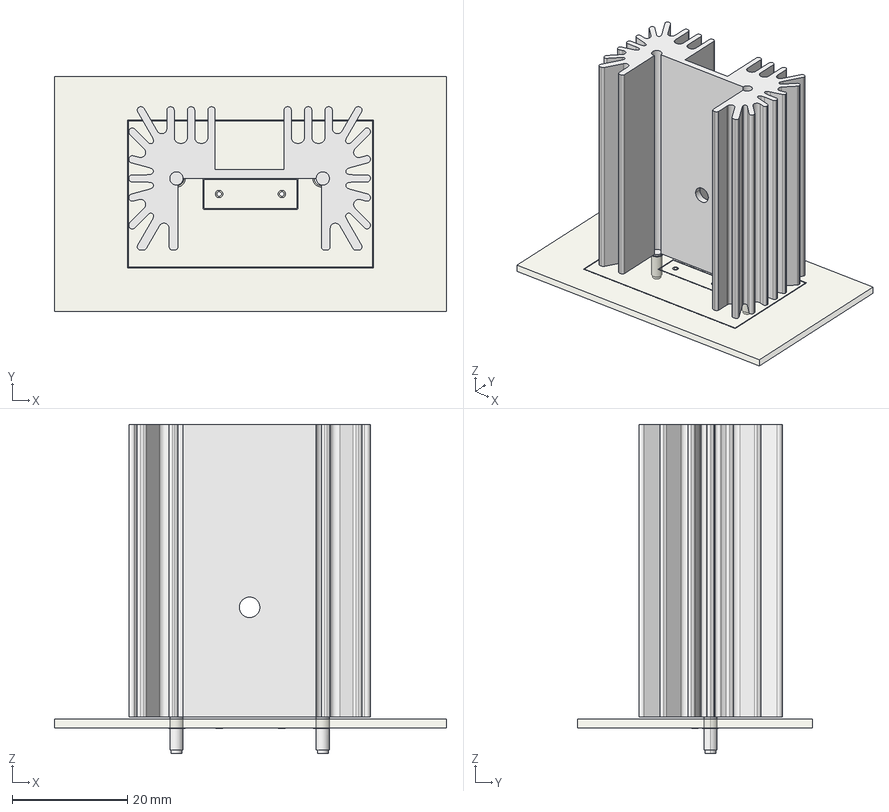
[picture p131: CAD file, 2018-02-13]
3DModels/R_3K_heatsink/R_3k_heatsink.fcstd
68.0 x 40.8 x 57.1 mm
F_CrtYd
FrontSilk
TopPads
BotPads
PTHs
Pcb
RA-T2X-51E_sp001_sp
