olin-electric-motorsports/OEM_Preferred_Parts/3DModels/relay_G2RL-1-E/relay.fcstd

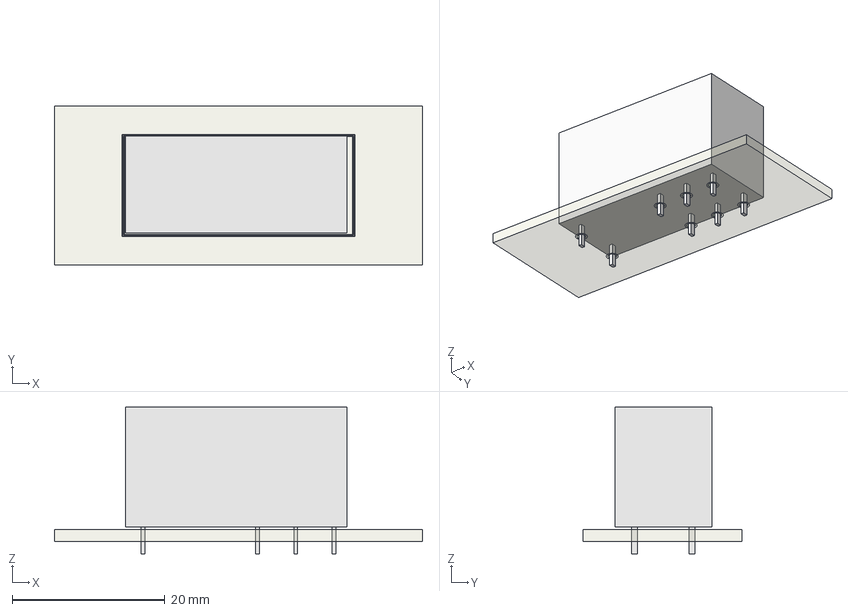
[picture p132: CAD file, 2017-12-29]
3DModels/relay_G2RL-1-E/relay.fcstd
48.2 x 20.8 x 19.2 mm
F_CrtYd
FrontSilk
TopPads
BotPads
PTHs
Pcb
