olin-electric-motorsports/OEM_Preferred_Parts/3DModels/SEGMENT_BICOL_BL-AR12Z3010/SEGMENT_BICOL_BL-AR12Z3010.fcstd

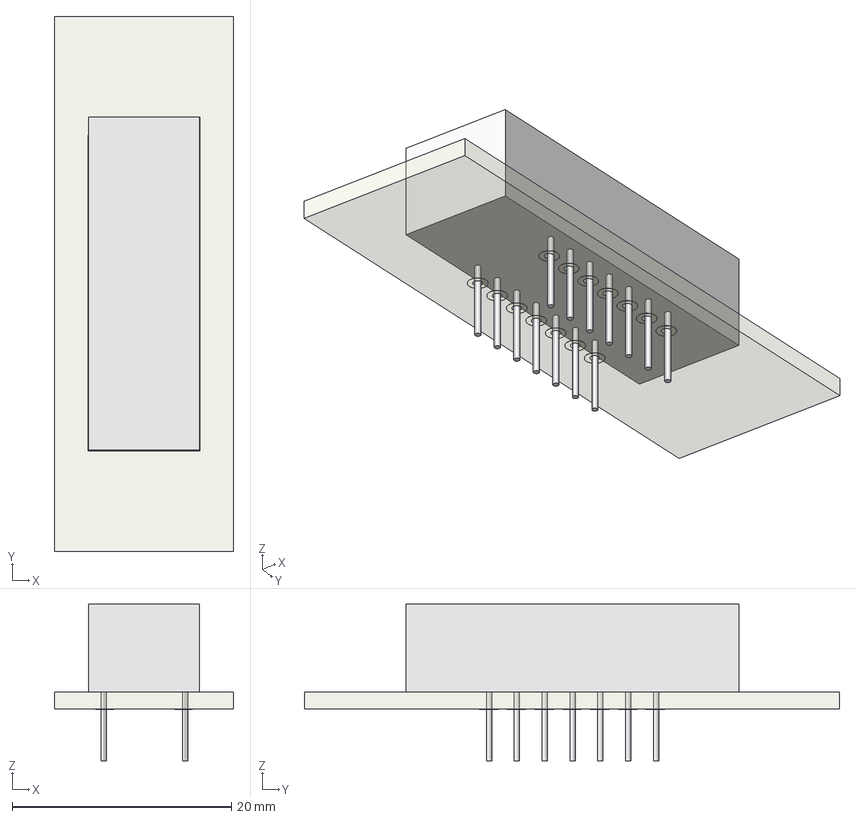
[picture p133: CAD file, 2018-02-22]
3DModels/SEGMENT_BICOL_BL-AR12Z3010/SEGMENT_BICOL_BL-AR12Z3010.fcstd
16.4 x 48.8 x 14.3 mm
FrontSilk
TopPads
BotPads
PTHs
Pcb
led_bar
