olin-electric-motorsports/OEM_Preferred_Parts/3DModels/TC-33X-2.stp

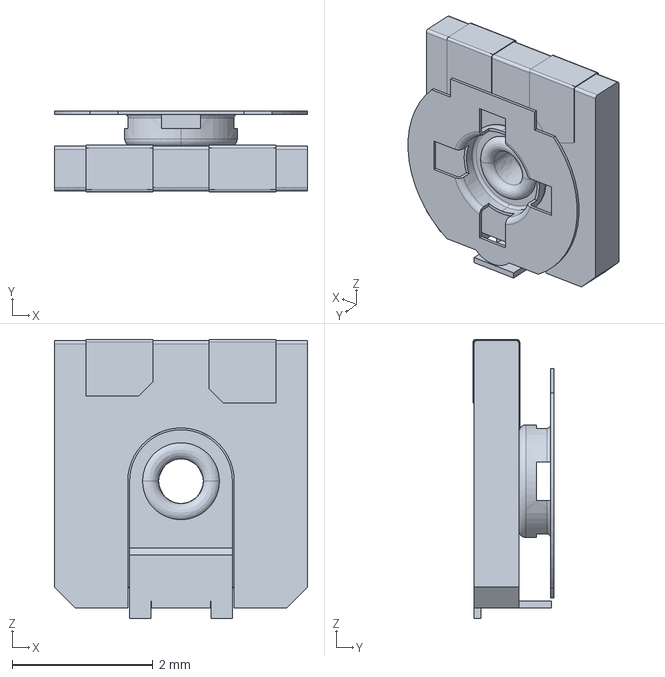
[picture p134: CAD file, 2017-03-07]
3DModels/TC-33X-2.stp
3.60 x 1.15 x 3.96 mm
