olin-electric-motorsports/OEM_Preferred_Parts/3DModels/Ultrafit-2-RA/Ultrafit_2_RA.fcstd

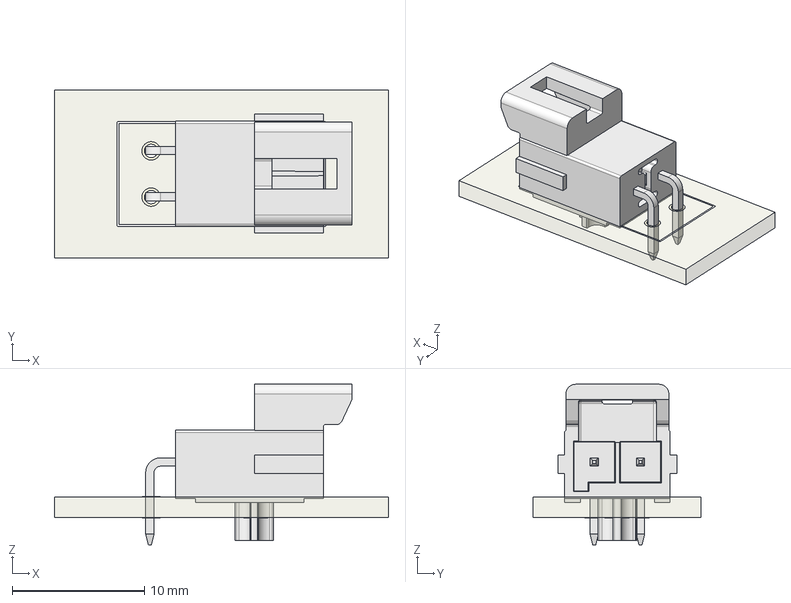
[picture p135: CAD file, 2018-02-10]
3DModels/Ultrafit-2-RA/Ultrafit_2_RA.fcstd
25.3 x 12.7 x 12.2 mm
FrontSilk
TopPads
BotPads
PTHs
Pcb
