olin-electric-motorsports/OEM_Preferred_Parts/3DModels/Ultrafit-4/ultrafit-4.fcstd

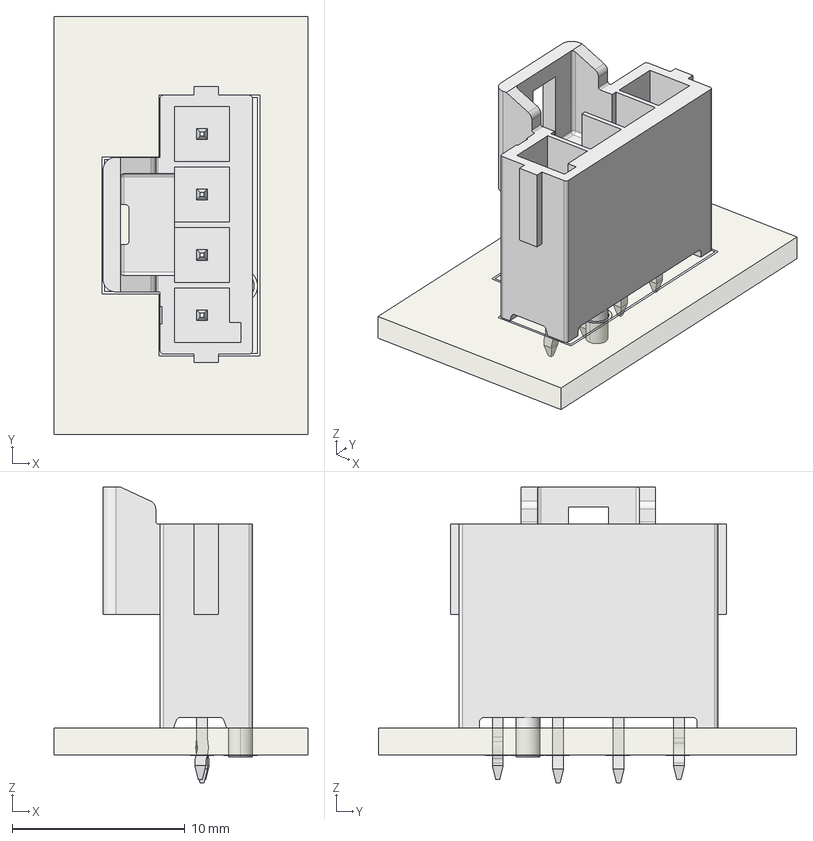
[picture p136: CAD file, 2017-12-29]
3DModels/Ultrafit-4/ultrafit-4.fcstd
14.7 x 24.2 x 17.2 mm
FrontSilk
TopPads
BotPads
PTHs
Pcb
