olin-electric-motorsports/OEM_Preferred_Parts/3DModels/USB/TE-Microusb.stp

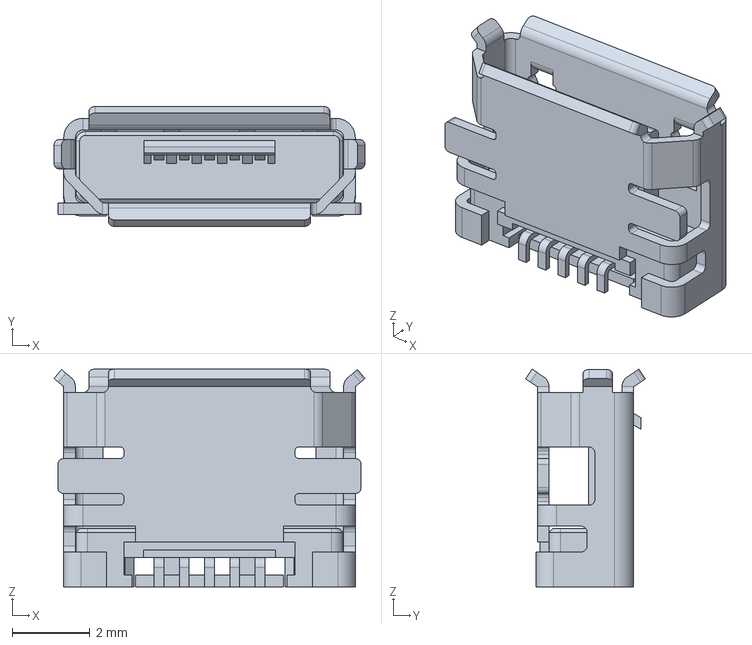
[picture p137: CAD file, 2020-11-04]
3DModels/USB/TE-Microusb.stp
8.00 x 3.08 x 5.60 mm
