olin-electric-motorsports/OEM_Preferred_Parts/3DModels/3352E.stp

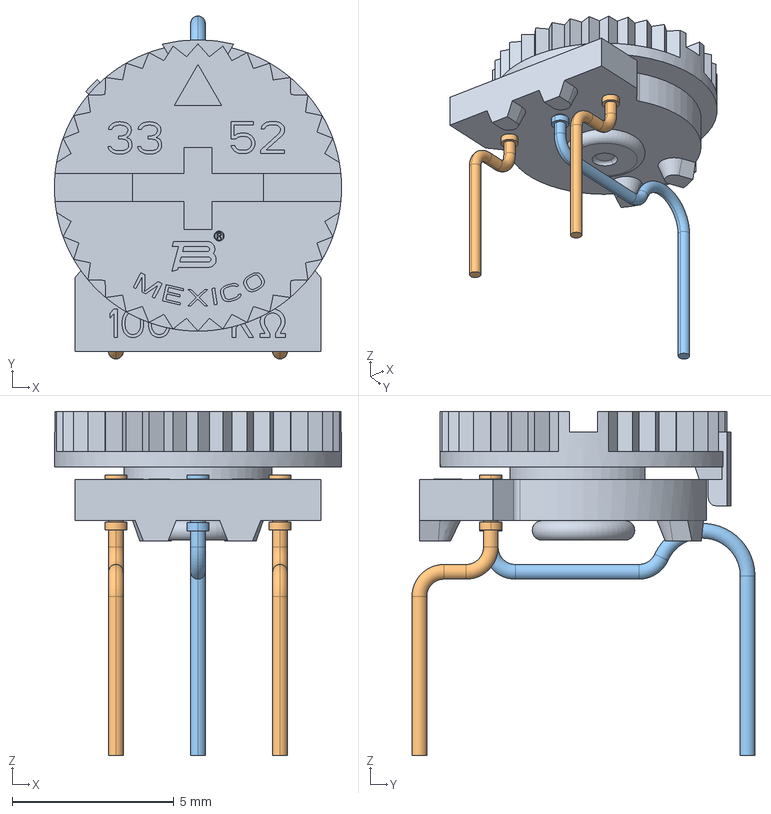
[picture p138: CAD file, 2017-03-07]
3DModels/3352E.stp
8.89 x 10.6 x 10.7 mm
