olin-electric-motorsports/OEM_Preferred_Parts/3DModels/Ampseal-35/C-1-776231-4.step

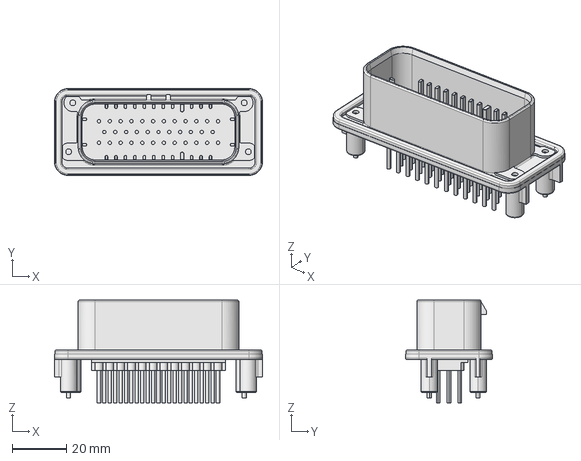
[picture p139: CAD file, 2018-02-19]
3DModels/Ampseal-35/C-1-776231-4.step
76.9 x 32.1 x 38.0 mm
