olin-electric-motorsports/OEM_Preferred_Parts/3DModels/LED_0805/FCrtYd.step

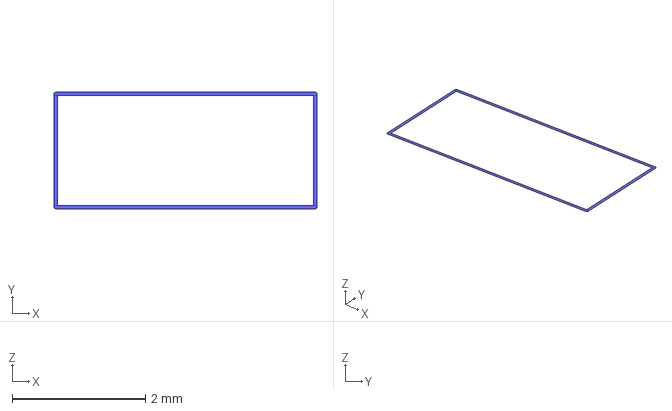
[picture p140: CAD file, 2017-12-01]
3DModels/LED_0805/FCrtYd.step
3.95 x 1.75 x 0 mm
