olin-electric-motorsports/OEM_Preferred_Parts/3DModels/R_1k_HS_TO247_OEM/User Library-TO247-2.STEP

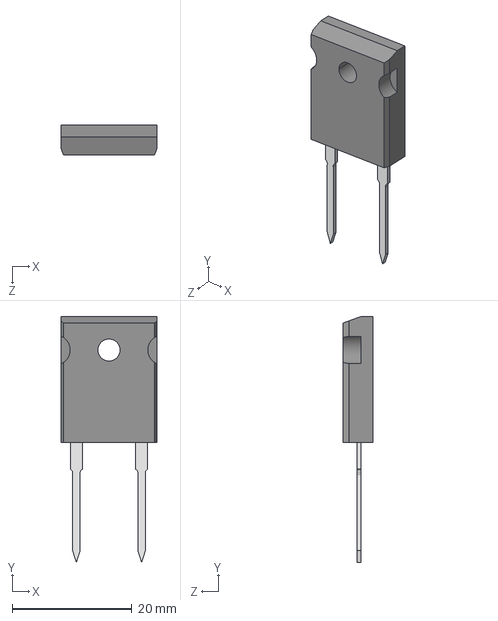
[picture p141: CAD file, 2018-01-29]
3DModels/R_1k_HS_TO247_OEM/User Library-TO247-2.STEP
15.9 x 41.1 x 5.03 mm
