olin-electric-motorsports/OEM_Preferred_Parts/3DModels/KS_01Q_01_Button.step

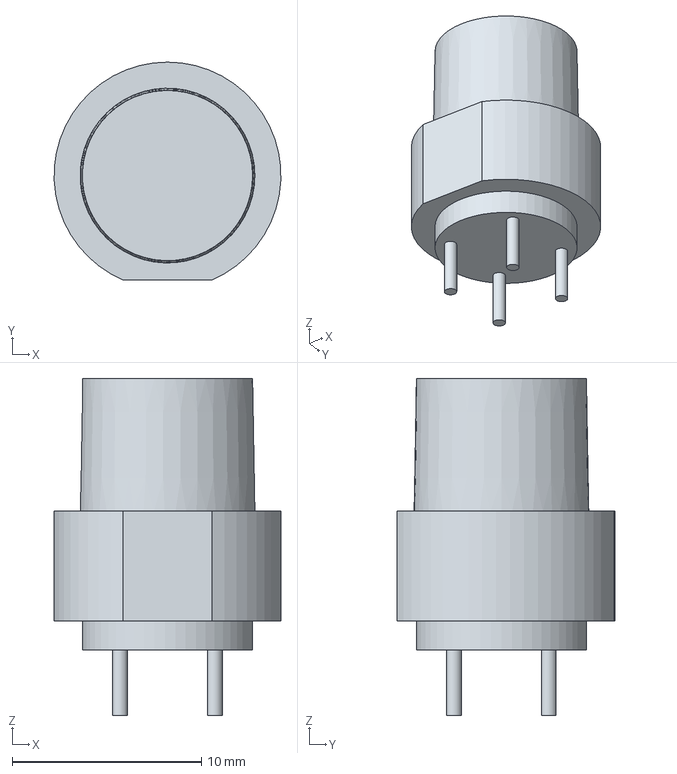
[picture p142: CAD file, 2017-03-07]
3DModels/KS_01Q_01_Button.step
12.0 x 11.5 x 17.8 mm
