olin-electric-motorsports/OEM_Preferred_Parts/3DModels/untitled.obj

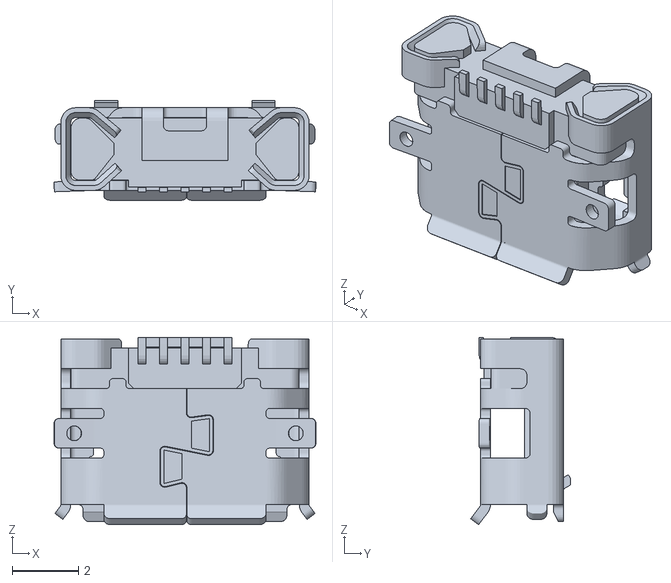
[picture p143: CAD file, 2017-03-07]
3DModels/untitled.obj
7.91 x 3.01 x 5.66
