olin-electric-motorsports/OEM_Preferred_Parts/(list of files, cad)

Other CAD files:
3DModels/Micromatch_Male_MOB_20/c-2-215464-0-c-3d.stp
3DModels/pwr163/pwr163.stp
3DModels/UVZ_Cap/UVZ_Cap.step
3DModels/Atmega16m1/Atmega16m1.step
3DModels/CAN Transceiver/SOIC8-N_MC.step
3DModels/LTC6804/LTC6804.step
3DModels/Micromatch_Female_RA_16/micromatch_female_ra_16.step
3DModels/Radial_Can/U1-T.step
3DModels/Header_Pin_2x3/Pin Header 2x3 TH Pitch 2.54mm.stp
3DModels/LTC6804/LTC6804-L.step
3DModels/Ampseal-14/Ampseal-14.fcstd
3DModels/Ampseal-23/Ampseal-23.fcstd
3DModels/Atmega16m1/Atmega16m1.fcstd
3DModels/CAN Transceiver/CAN_Transceiver.fcstd
3DModels/C_0805_OEM/C_0805.fcstd
3DModels/C_1206_OEM/C_1206_OEM.fcstd
3DModels/DO_214AA_OEM/DO_214AA.fcstd
3DModels/Fuse_1210_OEM/Fuse_1210.fcstd
3DModels/G5Q_OEM/G5Q.fcstd
3DModels/LTC6811-1/LTC6811-1.stl
3DModels/MICROFIT4RA/43045-0400_stp/430450400.stp
3DModels/Microfit3_Header_02x06_Angled_OEM/Microfit3_Header_02x06_Angled_OEM.fcstd
3DModels/Micromatch_Female_RA_8/micromatch_female_ra_8.fcstd
3DModels/R_1k_HS_TO247_OEM/R_1K_HS_TO247.fcstd
3DModels/R_2512_OEM/R_2512_OEM.fcstd
3DModels/Radial_Can/C_Radial_D10_L13_P5_OEM.fcstd
3DModels/SM91501ALE/SM91501ALE.STP
3DModels/SMB_OEM/SMB.STEP
3DModels/SMB_OEM/SMB.fcstd
3DModels/SOD-123_OEM/SOD-123.fcstd
3DModels/SOD_923_OEM/SOD-923.IGS
3DModels/SOD_923_OEM/SOD-923.STEP
3DModels/SOD_923_OEM/SOD-923.fcstd
3DModels/SOT-23-5(generic)/SOT-23-5(generic).fcstd
3DModels/SOT-23-6(generic)/SOT-23-6(generic).fcstd
3DModels/SOT-23_OEM/SOT-23.fcstd
3DModels/SOT_89_OEM/SOT-89.stp
3DModels/SOT_89_OEM/SOT_89.fcstd
3DModels/TLIN1021DRQ1/TLIN1021DRQ1.stl
3DModels/TSSOP-16_OEM/TSSOP-16.fcstd
3DModels/T_LAN_7490100111A/7490100111A.stp
3DModels/Ultrafit-2-RA/1723101302.step
3DModels/Ultrafit-2/Ultrafit-2.fcstd
3DModels/Ultrafit-4-RA/172310-1304_stp/1723101304.stp
3DModels/Ultrafit-4/1722861104.step
3DModels/fuse_block/fuse_block.fcstd
3DModels/micromatch_female_ra_20/micromatch_female_ra_20.fcstd
3DModels/micromatch_vert4/micromatch_vert4.fcstd
3DModels/mx150l_2/194270032.step
legacy/3DModels/SOP28/Document_sp.step
legacy/3DModels/SOP28/SOP28.fcstd
legacy/3DModels/micromatch-female-vert-20/micromatch-female-vert-20.step
