olin-electric-motorsports/OEM_Preferred_Parts/2019_Endurance_Course_Location.pdf

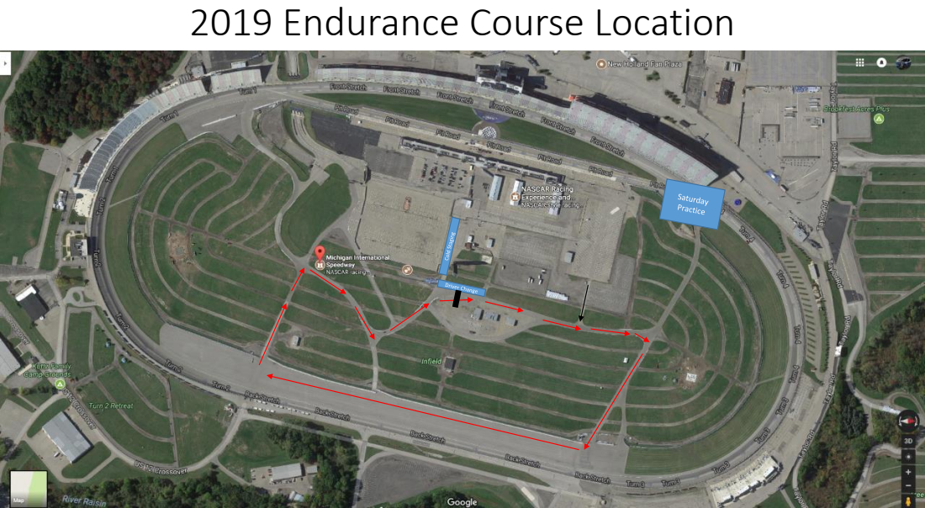
[picture p144: page 1]

2019 Endurance Course Location
