olin-electric-motorsports/OEM_Preferred_Parts/(commit log)

2017-03-07 Additional components as well as 3D files
    [3352E.stp, KS_01Q_01_Button.step, TC-33X-2.stp, untitled.obj]
2017-09-27 Added AMPSEAL schematic symbols and TPS561201 and 562201 buck converters
2017-09-29 added all parts for tutorial board except fuse, ultrafit, mounting hole, and footprint for inductor
2017-10-03 finished adding schematic symbols and footprints for ultrafit 4 pin, inductor, fuse and mounting hole
2017-10-13 fixed atmega schematic (made footprint path invisible)
2017-10-13 fixed mistake on atmega, added new fuse and footprint
2017-10-13 finished adding components for template schematic, edited a few components to add BOM information
2017-10-14 added 22k resistor to schematic component library
2017-10-16 added generic 24 pin conn
2017-10-16 20Vz Zener Diode
2017-10-17 added 20 pin male micromatch
2017-10-18 add connectors
2017-10-18 fix resistor description
2017-10-19 voltage regulator
2017-10-19 Added voltage regulator part to KiCAD library
2017-10-19 Fixed SSM3K333R FootPrint, Power Relay SPST, R2.2K,C.33u,SN74LVC1G123DCTR, Ultrafit 5, Voltage Regulator, LMV341
2017-10-19 add 15V linear regulator
2017-10-19 update TLP175A Photo Relay
2017-10-20 created ltc1380 schematic
2017-10-20 add ultrafit 2, add a voltage regulator, delete all the female connectors
2017-10-22 Updated Kicad library, added one component
2017-10-23 fix some components and added femal ra micromatch connectors
2017-10-24 added all female micromatch components, new cheaper slower op-amp, and made footprints for all female micromatch connectors
2017-10-24 readd the 20V and 13V zener diode that got deleted by accident sometime
2017-10-24 Adding schematic component for CP2120
2017-10-24 Adding footprint for CP2120-QFN
2017-10-24 22M resistor
2017-10-24 1M resistor
2017-10-26 added ultrafit 2 footprint
2017-10-26 add G2RL1-E power relay
2017-10-26 added 18V zener diode and footprint for it
2017-10-26 copied kicad footprints into our library so as to make value field hidden on PCBs, edited existing footprints for same reason, edited schematic library to use the new footprints I created
2017-10-27 add footprint for 3.15A fuse and fix precharge relay G2RL1-E
2017-10-27 1.07kR 1.13kR, Photo Relay, power relay, opamp
2017-10-27 add correct footprints to some of the components
2017-10-31 Added isoSPI transformer and 200mA fuse
2017-10-31 add 15V linear regulator footprint in formula footprint library (originally in the kicad library)
2017-10-31 Footprint fixes
2017-11-01 add footprint for 1k power resistor
2017-11-05 created a new resistor component and footprint
2017-11-05 added new footprint for 10K, HV resistors
2017-11-05 added a footprint for the 10K HV resistor
2017-11-05 Add footprint for trim pot
2017-11-05 Associate footprint with trim pot part
2017-11-05 Added DTO25 footprint and schematic
2017-11-05 BMS parts added 11_5_17 1:05
2017-11-05 Added Nanofit 2-pin connector schematic
2017-11-05 Added MicroFit 11 pin
2017-11-06 Added Molex connector footprints
2017-11-07 added pin numbers to DTO25
2017-11-08 Added regulator and resistor for CP2120 to OEM library
2017-11-10 added 200mA fuse footprint
2017-11-10 CD4043 details(no footprint yet)
2017-11-10 Adds 5k power resistor and to-263 heatsink footprint to library (TSAL)
2017-11-11 added footprint fo 10K resistor
2017-11-13 576k and 2.94M Resistor
2017-11-17 Added 20-pin MicroFit and MCP6001 SC-70-5 footprint
2017-11-17 Added 5k power resistor and heatsink footprint to library (TSAL)
2017-11-17 corrected pin numbers on LTC1380
2017-11-26 added micromatch via for interface board
2017-11-28 Added Microfit3 12-pin 2x6 header
2017-12-01 3D Models
    [C_0805.fcstd, C_0805.step, DO_214AA.fcstd, DO_214AA.step, FCrtYd.step, Fuse1210.step, Fuse_1210.fcstd, G5Q.fcstd]
2017-12-02 Ultrafit-2 and Micromatch-8 models
    [Ultrafit-2.fcstd, Ultrafit-2.step, micromatch_female_ra_8.fcstd, micromatch_female_ra_8.step]
2017-12-27 added 3d model for relay
    [Relay_SPDT_OMRON-G2RL-1-E.fcstd, part235_sp.step]
2017-12-27 added 3d files for 3k heatsink, 10k resistor, and ultrafit-4
    [RA-T2X-51E-ND .fcstd, 1722861104.step, RA-T2X-51E_sp.step, R_10K_HV.fcstd, part_sp.step, ultrafit-4.fcstd]
2017-12-28 added a few more 3d models of OEM parts
    [AP101.fcstd, DO-215AD002_sp.step, D_Schottky_SOD123.fcstd, Fuse_807.fcstd, Part 1.step, Part 2.step, Relay_SPDT_OMRON-G2RL-1-E.fcstd, TIP 144_sp.step]
2017-12-29 3D Model folders for Micromatch 20, C_1206, R_2512, and SOT-23-5 and -6
    [C_1206_OEM.fcstd, C_1206_OEM.step, Micromatch_Female_RA_20.fcstd, Micromatch_Female_RA_20.step, R_2512_OEM.fcstd, R_2512_OEM.step, SOT-23-5(generic).fcstd, SOT-23-5(generic).step]
2018-01-02 Updating footprints
2018-01-03 10uF rated for 16V
2018-01-04 added 3d models for AIR Control
    [32A-M.step, Atmega16m1.fcstd, Atmega16m1.step, CAN Transceiver.step, CAN_Transceiver.fcstd, C_Radial_D10_L13_P5_OEM.fcstd, C_Radial_D10_L13_P5_OEM.step, Header_Pin_2x3.fcstd]
2018-01-04 add 3D models for SMB_13v_zener SOD_923_20V_zener SOT_89_linear regulator and 1k power resistor
    [R_1K_HS_TO247.fcstd, R_1k_HS_TO247.step, SMB.STEP, SMB.fcstd, SMB.step, SOD-923.IGS, SOD-923.STEP, SOD-923.fcstd]
2018-01-05 Added 3D model for DTO25 and 2x10 molex microfit
    [DTO025.step, DTO25.fcstd, Molex_Microfit3_Header_02x10_Angled_OEM.fcstd, Molex_Microfit3_Header_02x10_Angled_OEM_fp.step]
2018-01-06 added other molex microfit and nanofit
    [Microfit3_Header_02x06_Angled_OEM.fcstd, Microfit3_Header_02x06_Angled_OEM.step, Molex_NanoFit_1x02x2_50mm_Angled_OEM.fcstd, Molex_NanoFit_1x02x2_50mm_Angled_OEM001.step]
2018-01-14 larger diode symbols
2018-01-25 Added info for BOM
2018-01-26 added the heatsink pins for the 3k/1k resistor
2018-02-02 added rotary switch for programming
2018-02-03 added a part and footprint for the mx150L connector
2018-02-04 Ultrafit 5and no footprint led
2018-02-04 created vertical micromatch footprints
2018-02-04 micromatch vertical with footprints
2018-02-04 Added 178k res, 270k res, 21mA fuse
2018-02-05 fixed ultrafit footprints
2018-02-06 changed pin on four channel op amp so it works
2018-02-07 added ampseal 14 and 23 footprints
2018-02-07 Ampseal14&23 model + micromatch_vert10
    [AmpSeal-14.step, Ampseal-14.fcstd, Ampseal-23.fcstd, Ampseal_23.step, COMPOUND_sp.step, Ultrafit-5.fcstd, micromatch_10_vert.step, micromatch_vert10.fcstd]
2018-02-08 added 3D models for rj-45 and MM-female-20
    [rj45-vert.step]
2018-02-09 added 3d models, parts, and purchasing links
    [1723101302.step, 194270032.step, Ultrafit_2_RA.fcstd, mx150l_2.fcstd]
2018-02-12 unfinished fuse block
2018-02-13 fixed the 3d model of the 3k heatsink.
    [RA-T2X-51E-ND .fcstd, RA-T2X-51E_sp.step, RA-T2X-51E_sp001_sp.step, R_3k_heatsink.fcstd]
2018-02-13 Ampseal 35 footprint
2018-02-13 edited fuse holder, still incomplete
2018-02-17 git reckt! Added a cad file for the ampseal 35
    [Ampseal-35.fcstd, C-1-776231-4.step]
2018-02-19 fuse holder sch and footprint
2018-02-21 added led bar footprint
2018-02-22 adding 3d models for lv interface, prog switch, fuse block, micromatch male 6,12,18,20 although they are called female
    [3P4T_rotary_switch.fcstd, C-1-215464-2.step, C-1-215464-8.step, C-2-215464-0.step, C-215464-6.step, fuse_block.fcstd, fuse_block.step, micromatch_female_ra_12.fcstd]
2018-02-22 added 3D Models for led bar chip and led bar segment, fixed fuse block
    [SEGMENT_BICOL_BL-AR12Z3010.fcstd, led_bar.step]
2018-03-09 fixed footprints
2018-03-31 fixed fuse block parameters
2018-05-02 charging board updates
2018-05-11 added fuse block holder for lv interface board
2018-08-12 added new adxl335 accelerometer component
2018-08-13 added new digital accelerometer footprint
2018-09-01 added new ultrafit 4 ra connector:
2018-09-06 more fixes, everything good (fields, footprints, stock, etc.) through crystal
2018-09-14 accidentally inserted DK at beginning, must have been same issue as before
2018-09-21 done up through 330 ohm resistor
2018-09-21 done through resistors
2018-09-21 Added 10pin connector footprint
2018-10-02 fixing for merge
    fixing alphabetical ordering, removing duplicate entry for TLP175A_OEM, removing K field on 8mhz crystal and new stm32, fixing 18pf cap description
2018-10-02 fixing for merge
    removing crystal_smd diffs, changed MFN to DK for 8mhz crystal and new stm32
2018-10-02 added description back for new stm32
2018-10-03 added components for SD card dev board
2018-10-04 added fp for sd_card_dev board
2018-10-18 Updated symbols for BMS
2018-10-20 Updated rest of BMS symbols
2018-10-20 button for reset, c.1uF0603
2018-10-23 Replaced 2MM socket strip footprint with 0.1in socket strip
2018-10-23 Add PWR163 27 ohm resistor symbol and footprint
2018-10-23 Revert "Replaced 2MM socket strip footprint with 0.1in socket strip"
    This reverts commit 283a451c5b97459f3beeb0839c607c8300cef588.
2018-10-23 Added footprints for BMS symbols
2018-10-26 Fixed 10nF capacitor reference field to say C
2018-10-30 Assigned footprints for 10nF cap, 4.99k resistor, 60.4ohm resistor, and 200mA fuse for BMS
2018-11-09 symbol and footprint for LMT85-Q1
2018-11-13 Added footprint to MCP6001
2018-11-15 Added symbol and footprint for through hole bolt connection for BMS structural PCB voltage tab connections
2018-11-22 Edited symbols and footprints for LMT85-Q1 and bolt hole so that pins match pads in layout
2018-11-27 Add 120 ohm resistor
    Slightly modified text placement on a couple components
2018-11-28 Added tolerancing and keepout zone to bolt footprint
2018-12-04 Added slider switch MHSS1105 to formula library
2018-12-04 added footprint for bmi088, a mux footprint?, and updated the bmi088 schematic to include the new footprint.
2018-12-04 Add BMS balancing power resistors
2018-12-04 definitely am not adding a rgb diode. totally not going to put this on the sensing module. ;)
2018-12-07 Adding Nano-Fit connectors schematics
2018-12-15 Fix description of SMW resistor
2018-12-31 Fixed footprint assignment for BSS308PE
2019-01-08 added solid state relay (CPC1025N)
2019-01-15 Added 3D model stp files
    [7490100111A.stp, LTC1380.STEP, LTC6811-1.stl, LTC6811-1.stp, SOT753.STEP, User Library-SC70-5-1.STEP, c-1-2178713-6-1-3d.stp, pwr163s-25-1001f.stp]
2019-01-17 added AND gate (3V-16V vcc
2019-01-25 Added NAND gate (Vdd up to 16V)
2019-01-29 added footprints to components
2019-02-02 added microfit footprints and parts
2019-02-05 Fix missing parens in 4 kicad models
2019-02-07 Adding Fuse Block Holder Schematic and Footprint
2019-02-08 Fixed pins on Fuse Block Holder
2019-02-10 modified capacitor footprint to reflect proper layers
2019-02-10 changed purchasing link to purchasinglink on two schematics. Might have added a dope phoenix to our footprints library ...
2019-02-14 Add 3D models for PWR163 balancing resistors
    [pwr163.stp]
2019-02-14 Updated 3D models from latest KiCAD default libraries when I redownloaded KiCAD
2019-02-19 Adding model for Fuse Block
    [Fuse_3557-2.step, MM_F_VT_6.stp]
2019-02-19 Added footprints for LED Bar Componenets
2019-03-01 add two microfits and relays
    [D_Series_Cynergy_Relays.STEP, MF-08-RA.stp, MF_RA_06.stp, Standex_Meder_Relay.STEP]
2019-03-01 added footprint to ampseal23
2019-03-02 added new buck converter parts
2019-03-07 Add B5B-PH connector
2019-03-11 Add BAS40 small Schottky diode, 0.1% 1k and 17.4k, and adjust isoSPI symbol
2019-03-12 Update hole size for fuse holder
2019-03-13 Add 54.9K Resistor for Buck Converter
2019-03-14 new nanofit footprint for ziptie attachment
2019-03-14 removed animal footprints and extra ultrafit
2019-03-15 link 3d models
    [MicroFit-10-RA.stp]
2019-03-18 renamed iso-spi-cutout footprint
2019-03-18 Add 3.3 ohm PWR163 balancing resistor
2019-03-18 Repaired micromatch, mcp6001, ltc1380 footprints
    [c-1-2178713-6-1-3d.stp, c-1-338068-6-f-3d.stp]
2019-03-19 Edit BAS40-00 pin numbering to match actual package
2019-03-23 new thermistor symbol and footprint
2019-03-26 updated thermistor symbol
2019-03-27 updated symbol fields for components related to BMS perihperal
2019-03-27 adding socket and terminal strips and their footprints
2019-03-29 Add 3D Model Links
    Added links to C_radial
    Nanofit
    Ultrafit 2,3,5
    micromatch 6
    Also added 3D model for C_radial
    [UVZ_Cap.step]
2019-04-05 added Microfit_VT_10 symbol and footprint
2019-04-05 Added fields to 200mA fuse symbol
2019-04-12 Add microfit_v_2
    schematic symbol
    footprint and associated 3d model
    [BBS-126-G-A.stp, MicroFit_V_2.stp, Microfit_2_VT.stp, SS-126-G-2.stp]
2019-05-19 added 17.8k resistor for bms
    for bspd current sense setpoint
2019-05-20 fixed microfit vert 2
    footprint was really weird
2019-11-14 Adding NanoFit Connectors
2019-11-14 Added 2x5, 2x6 nanofit schematics
2019-11-14 Adding NanoFit Default FootPrints
2019-11-15 added 3d models and microfit 2
    [LTC6804-G.step, LTC6804-L.step, LTC6804.step, MM-12-V-Female.stp, Microfit_RA_SMD.stp, SOT223.stp]
2019-11-15 adding DNP resistor
2019-11-15 Adding Nanofit 10 and 12 with appropriate footprints
2019-11-15 Rasberry Pi Pin Header
2019-11-15 Adding gas guage for GLV Battery Monitor
2019-11-15 Updated LM3480 footprint
2019-11-21 added BQ79606A-Q1 board
2019-11-21 fixing some library issues that messed with the template schematic
2019-11-22 adding inductor for 3.3V buck output
2019-11-25 Adding parts for the 328 Hacker Board
2019-11-30 fixing BOM fields for some parts
2019-12-01 add tire temp sensor
2019-12-01 addted tire temp
2019-12-06 Fied rj45 schematic symbol
2019-12-06 fixed l_15uH footprint field
2019-12-10 Tire Temp sensor
2019-12-10 Edit Tire Temp Schematics
2019-12-10 Edit Temperature Sensor Schematics
2019-12-12 adding TPS563231 for High Current Buck
2019-12-14 4.7uH Inductor Footprint for high current buck
2019-12-14 Footprints for high current buck
2019-12-14 Fix Tire temp sensor diagram
2019-12-28 minor fixes to issues noticed during BOM exports
2020-01-15 Added part info and 3d models
    Added part info for Microfit 4 and 6 as well as 3d models for both, including 3d models for the mating connector
    Added mating connector for ampseal 35
    [MicroFit_4_OtherSide.stp, MicroFit_6_OtherSide.stp, MicroFit_VT_4.stp, MicroFit_VT_6.stp, ampseal35-otherend.stp]
2020-01-17 Adding redcude_7461166
    [c-2-215464-0-c-3d.stp, redcube_7461166.stp]
2020-01-18 TSMP Resistor Footprint
2020-01-24 updates 1.23.20
    [Microfit_RA_4.stp]
2020-01-25 izzi updates
    [430450400.stp]
2020-01-30 Edit tire temp sensor footprint
2020-02-01 Add 3D model for Crystal
    [Crystal_SMD_SeikoEpson_TSX3225-4Pin_3.2x2.5mm_HandSoldering.step]
2020-02-03 added 2 capacitors
2020-02-04 added a resistor
2020-02-05 Adding 3d models and 12V Relay
    [Ampseal35_OtherSide.stp, ampseal-14_OtherSide.stp]
2020-02-05 Test Point SMD Footprint
2020-02-05 Adding 12V Relay
2020-02-07 added new buck for TSAL
    [1723101304.stp]
2020-02-08 adding transformer footprint
2020-02-14 added 125 and 500 ohm resistor
2020-02-15 added new fuse for BMS
2020-02-27 Added new HV fuse
2020-03-04 add footprint and datasheet for TI BMS chip
2020-03-04 added in a few resistors
2020-03-06 more footprints
2020-03-10 Updated footprint for op-amp to be from formula library
2020-03-10 Dux Interface components
    [NF_VT_TH_2x2.stp, NF_VT_TH_2x5.stp, NF_VT_TH_2x6.stp]
2020-04-26 Screw Terminal 1x5 for LV BMS
2020-09-14 revert formula.lib file to 657a8b6256f (resistors were deleted)
2020-10-08 Add 1.8k resistor
2020-10-12 Add power flags for HVPS
2020-10-12 Added USB-A and a couple of resistors for power bank project
2020-10-12 Add USB-A and a couple of resistors for power bank project
2020-11-03 add usb connectors for battery bank
    [5019--3DModel-STEP-56544.STEP, SAMTEC-USB-A-S-S-B-SM2.stp, SM91501ALE.STP, TE-Microusb.stp]
2020-11-10 created LT3751 Flyback Controller IC symbol and footprint
2020-11-11 Added flyback output diode rfn5tf8s symbol and footprint, and fixed lt3751 footprint reference designator
2020-11-11 Added flyback isolation amplifier (for voltage sensing) ACPL-C87B symbol and footprint
2020-11-11 Added flyback transformer GA3460-BL symbol and footprint
2020-11-12 Added power mosfet NTB35N15 symbol and footprint for review
2020-11-12 add microUSB connector footprint
2020-11-13 Add footprints for Power Bank project
2020-11-14 Add missing footprints
2020-11-16 Add 8-bit voltage level shifter
2020-11-19 Add rotary encoder + LCD Display
2020-11-23 Added missing information to previously added flyback components, as well as a few more passives
    [SMB.step, SOD-923.step, micromatch_female_ra_20.fcstd]
2020-11-30 Add JST-GH 6 pin connector
2020-12-04 Add Lin Transciever
    [TLIN1021DRQ1.stl, TLIN1021DRQ1.stp]
2020-12-10 change i2c lcd screen to spi
2020-12-10 removed duplicate 75k resistor, added missing fields to remaining one
2020-12-10 added 5.6V Zener diode for USB supply
2020-12-11 fix: add footprints for R_500, USB_B BAT400
2021-01-08 Fixed LM3480 and TXB0104 footprint references
2021-02-02 Add power MOSFET for HVPS
2021-02-06 srees buck chip
2021-02-08 fixed footprint reference for components using formula to footprints
2021-02-12 updated libraries (power coupons)
2021-02-12 add debug leds & lcd screen
2021-02-20 add 220pF capacitor to library
2021-02-21 fixed footprint
2021-02-25 Add LCD screen footprint to library
2021-03-02 add debugging LEDs
2021-03-05 Add RB228T100 Diode for HVPS
2021-03-05 Added 1x03 pin Connector footprint
    Needed for use in LIN Hackerboard
2021-03-09 added +5v buck chip footprint
2021-03-09 Add 5v DCDC Converter for HVPS
2021-03-09 Add 22nF cap and 10Ohm resistor
2021-03-16 links to +5v hvps buck actually added this time
2021-03-16 updated links for hvps 5v buck
2021-03-16 Add mounting hole to library
2021-03-19 add debug leds
2021-03-26 added footprint for -5v hvps buck
2021-03-26 updated links for -5v hvps buck
2021-03-26 ACTUALLY updated links for -5v hvps buck
2021-03-29 Add MegaFit Connector for HVPS
    q
2021-03-29 Update footprint for Discharge Relay
2021-03-29 Add footprints for encoder connectors
2021-03-29 flyback part tweaks, added a new general purpose diode
2021-03-29 Add connector footprint to footprints library
2021-03-30 Added 01x09 symbols and footprints
2021-03-30 Properly centered the 01x9 footprint
2021-03-31 Add passives for power bank
2021-05-20 Add LDO symbol and footprint
2021-05-20 Add symbol/footprint for XGL4020 inductor.
2021-05-22 Add footprints/symbols for resistors and capacitors.
2021-06-17 Addeed CD4044B part and modified micromatch connector.
    Added an Atmega64m1 alias to the atmega16m1.
2021-07-01 added a 23.7kOhm resistor to the library
2021-07-01 Revert "added a 23.7kOhm resistor to the library"
    This reverts commit bfaa75fef3d3be0b45812541da1ed7fd3723e5b5.
2021-07-01 Added a 23.7KOhm resistor to the formula lib
