olin-electric-motorsports/OEM_Preferred_Parts/(notices)

Notices in the files:
3DModels/USB/SAMTEC-USB-A-S-S-B-SM2.stp:
FILE_NAME( 'p:/temp/worker_127/temp/exporttempdir_172_1547_RJFi0/format_0/USB-A-S-S-B-SM2.stp', '2020-11-03T02:38:55', ( 'License CC BY-ND 4.0' ), ( 'CADENAS' ), ' ', 'PARTsolutions', ' ' );
